openUC2/UC2-STEP/README.md

<p align="left">

</p>

# openUC2 *STEP Files*
---

This repository stores all the STEP Files for the openUC2 ecosystem. It is automatically exported using the Autodesk Inventor Task Scheduler.

## Get Involved

This project is open so that anyone can get involved. You don't even have to learn CAD designing or programming. Find ways you can contribute in  [CONTRIBUTING](https://github.com/openUC2/UC2-GIT/blob/master/CONTRIBUTING.md)

## License and Collaboration

This project is open-source and is released under the CERN open hardware license. Our aim is to make the kits commercially available.
We encourage everyone who is using our Toolbox to share their results and ideas, so that the Toolbox keeps improving. It should serve as a easy-to-use and easy-to-access general purpose building block solution for the area of STEAM education. All the design files are generally for free, but we would like to hear from you how is it going.

You're free to fork the project and enhance it. If you have any suggestions to improve it or add any additional functions make a pull-request or file an issue.

Please find the type of licenses [here](https://github.com/openUC2/UC2-GIT/blob/master/License.md)

REMARK: All files have been designed using Autodesk Inventor 2019 (EDUCATION)

## Collaborating
If you find this project useful, please like this repository, follow us on Twitter and cite the webpage! :-)
