openUC2/UC2-STEP/STEP/Assembly_Cube_Laser_Multicolour_insert_v3.ipt.step

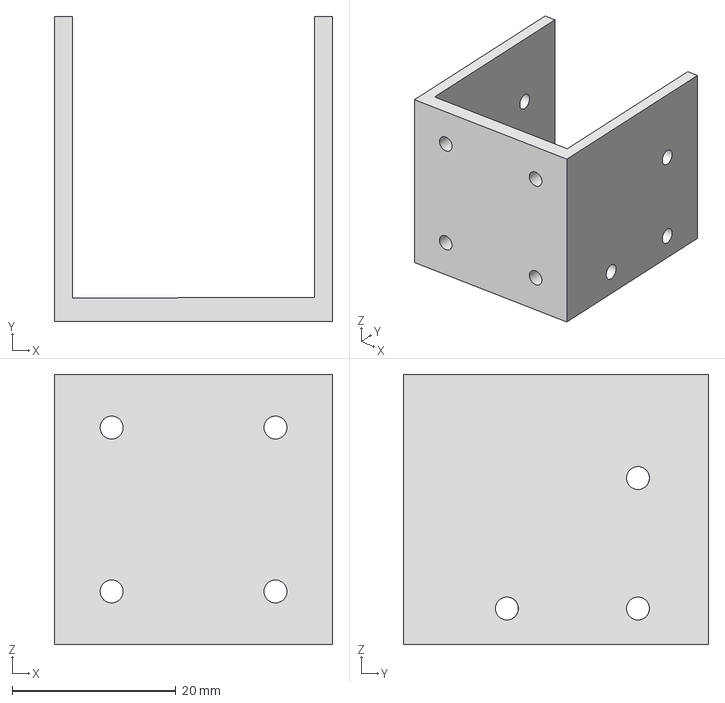
[picture p1: CAD file, 2022-11-30]
STEP/Assembly_Cube_Laser_Multicolour_insert_v3.ipt.step
33.9 x 37.3 x 33.0 mm
