openUC2/UC2-STEP/STEP/Assembly_Cube_Flexuremanipulator_v3.iam.step

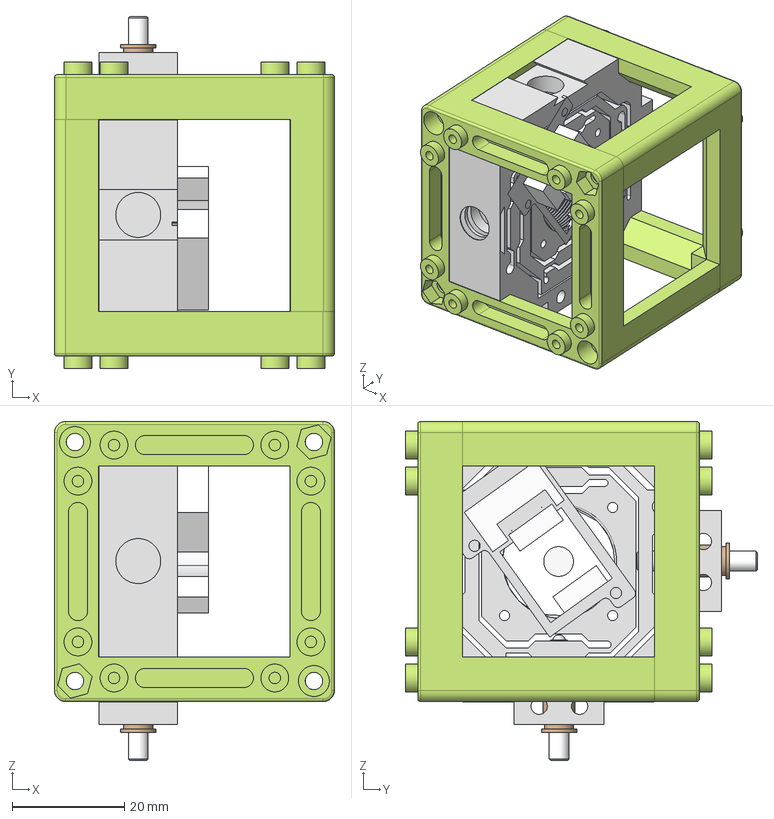
[picture p2: CAD file, 2022-11-30]
STEP/Assembly_Cube_Flexuremanipulator_v3.iam.step
49.8 x 62.6 x 60.3 mm
10_Cube_1x1_IM x 2
20_Cube_Inser_Flexuremanipulator_v3
00_F6SSN2P-Step x 2
00_F6SS088-Step x 2
20_Cube_Inser_Flexuremanipulator_springlock_v3
00_KES400_Bluray_Lens
00_KES_Bluray_Magnet
00_KES400_Lens
20_Cube_Insert_Flexuremanipulator_kes400_adapterplate_v3
