openUC2/UC2-STEP/STEP/Assembly_Cube_noBP.iam.step

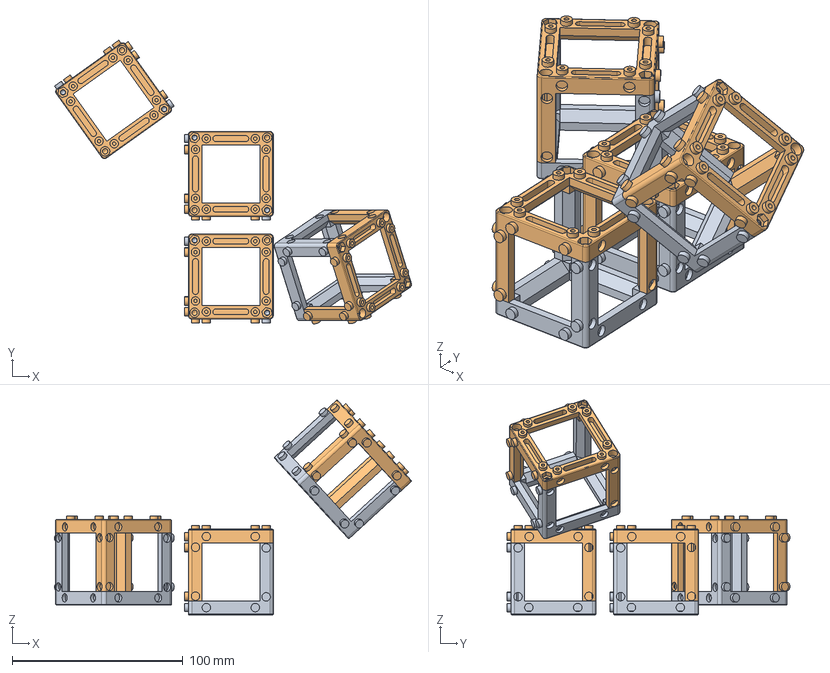
[picture p3: CAD file, 2022-11-30]
STEP/Assembly_Cube_noBP.iam.step
208.8 x 165.9 x 125.6 mm
10_Cube_1x1_IM x 4
10_Cube_1x1_IM_1 x 4
