openUC2/UC2-STEP/STEP/Assembly_Cube_Beamsplitter_new_v3.iam.step

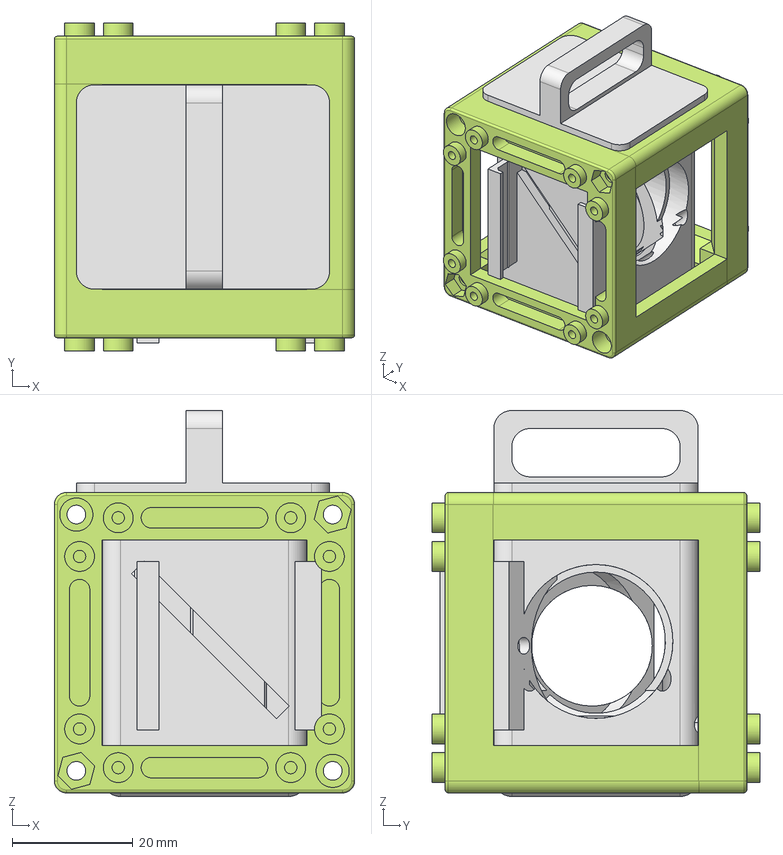
[picture p4: CAD file, 2022-11-30]
STEP/Assembly_Cube_Beamsplitter_new_v3.iam.step
49.8 x 54.4 x 64.0 mm
10_Cube_1x1_IM x 2
30_Cube_Insert_Filter_Revolver_Filter_base_single
30_Cube_Insert_Filter_Revolver_Filter_base_single_v3
