openUC2/UC2-STEP/STEP/Assembly_Cube_Flashlight_v3.iam.step

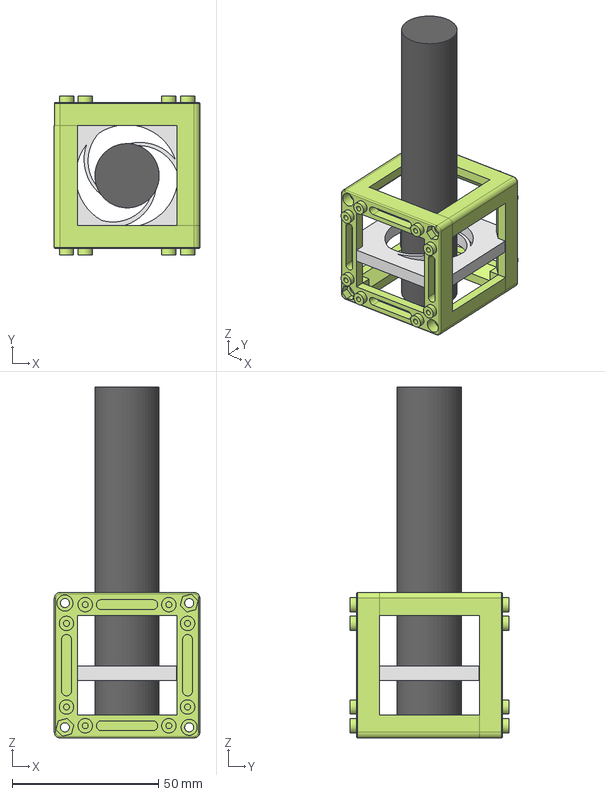
[picture p5: CAD file, 2022-11-30]
STEP/Assembly_Cube_Flashlight_v3.iam.step
49.9 x 54.5 x 120.0 mm
20_Cube_Insert_Holder-okular+flashlight_v3
10_Cube_1x1_IM x 2
00_flashlight
