openUC2/UC2-STEP/STEP/Assembly_Cube_Laser_Multicolour_v3.iam.step

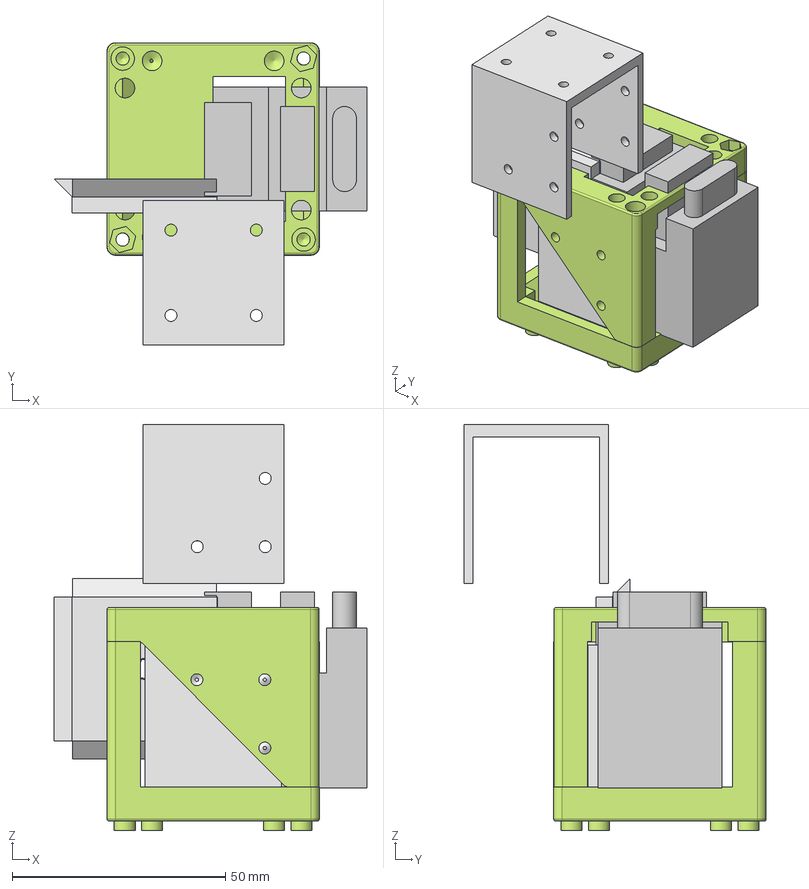
[picture p6: CAD file, 2022-11-30]
STEP/Assembly_Cube_Laser_Multicolour_v3.iam.step
73.3 x 70.9 x 95.1 mm
00_RGB_Laser_Laserlands
10_Cube_1x1_IM
10_Cube_1x1_IM_1
Assembly_Cube_Laser_Multicolour_insert_v3
20_Cube_Insert_Laser_multicolour_sidewall_v3
20_Cube_Insert_Template_inplate_V3
