openUC2/UC2-STEP/STEP/Assembly_Cube_Lasertack_v3.iam.step

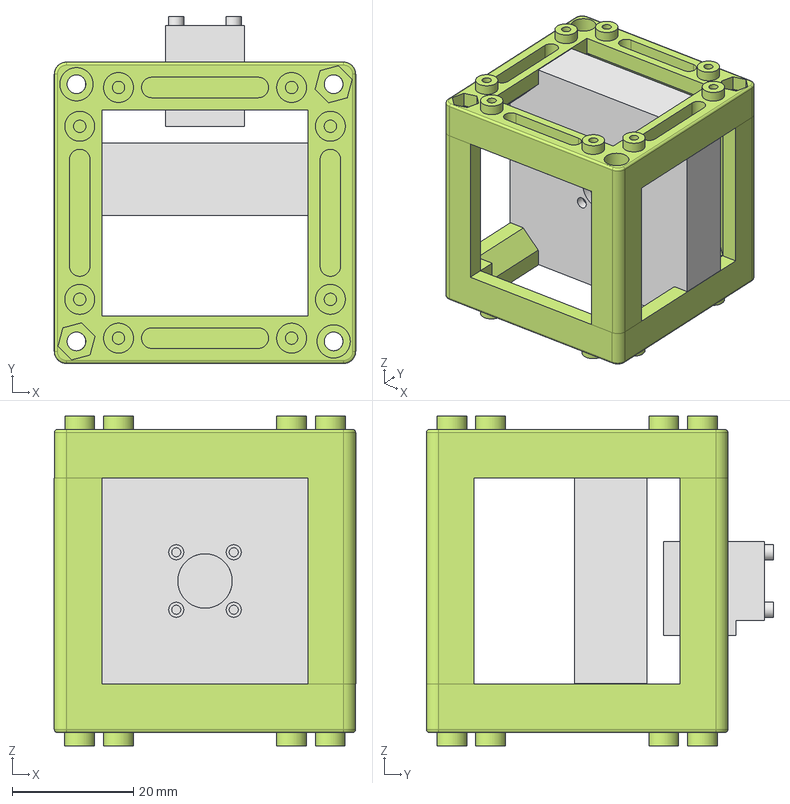
[picture p7: CAD file, 2022-11-30]
STEP/Assembly_Cube_Lasertack_v3.iam.step
49.8 x 57.3 x 54.5 mm
10_Cube_1x1_IM x 2
20_Cube_Insert_Lasertack_mount_v3
00_Lasertack_Coolingblock
