openUC2/UC2-STEP/STEP/Assembly_Cube_Baseplate_wMagnets_v3.iam.step

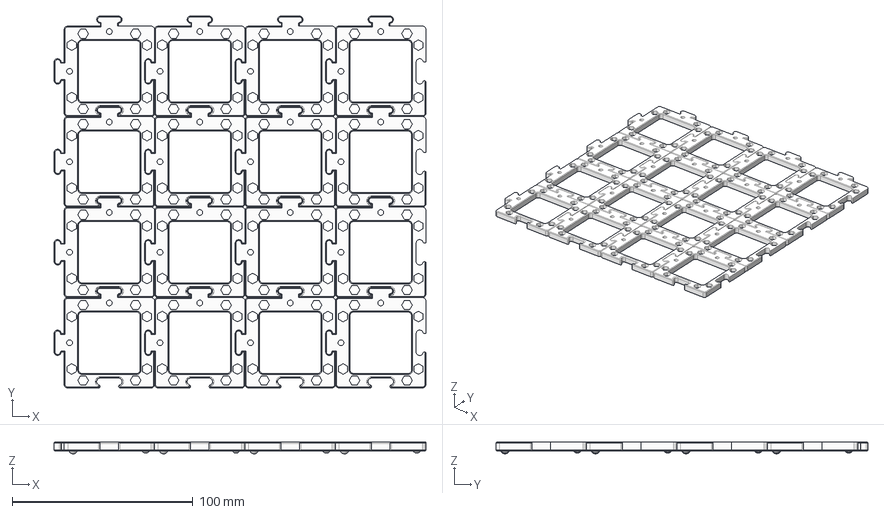
[picture p9: CAD file, 2022-11-30]
STEP/Assembly_Cube_Baseplate_wMagnets_v3.iam.step
205.6 x 205.6 x 6.55 mm
10_Base_puzzle_v3 x 16
00_BallMagnets_5mm x 16
