openUC2/UC2-STEP/STEP/Assembly_Cube_empty_IM_withBase_v3.iam.step

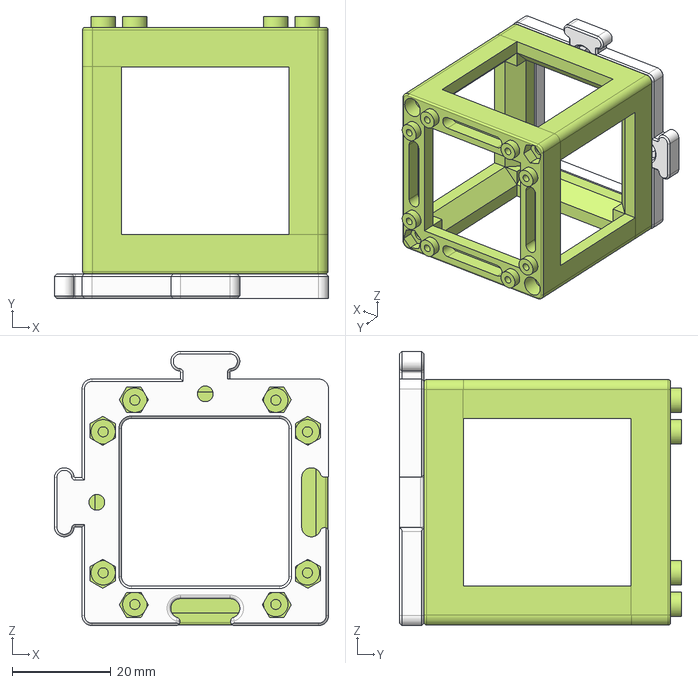
[picture p10: CAD file, 2022-11-30]
STEP/Assembly_Cube_empty_IM_withBase_v3.iam.step
55.6 x 57.2 x 55.6 mm
10_Cube_1x1_IM x 2
10_Base_puzzle_v3
