openUC2/UC2-STEP/STEP/Assembly_Cube_RMS_objective.iam.step

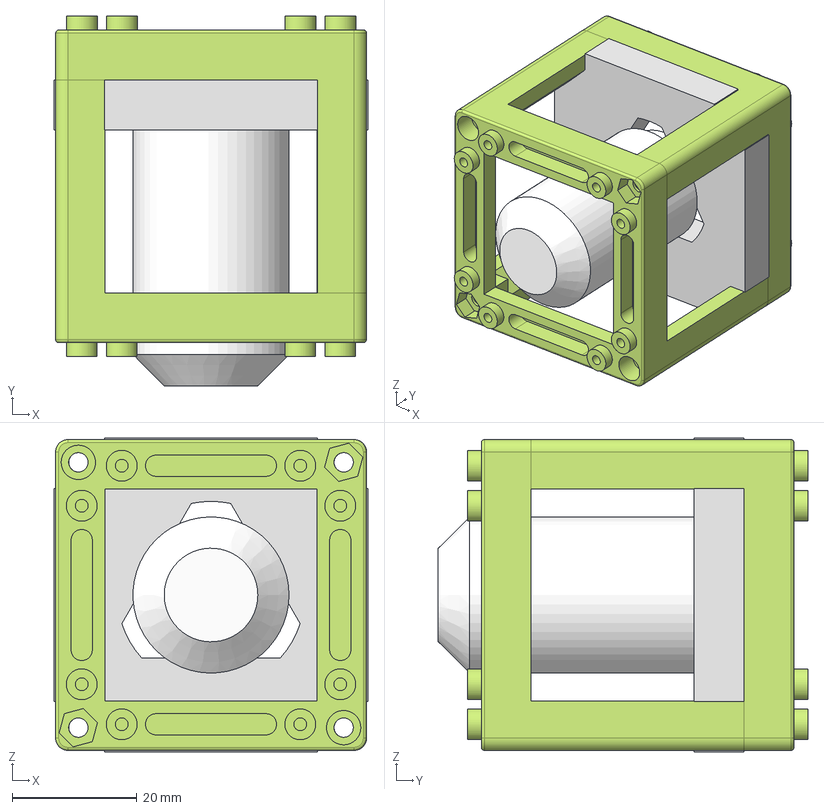
[picture p11: CAD file, 2022-11-30]
STEP/Assembly_Cube_RMS_objective.iam.step
50.3 x 59.2 x 50.3 mm
10_Cube_1x1_IM x 2
20_IM_Cube_Insert_Lens_holder_RMS_63x
00_Microscope_Objective_Lens10x
