openUC2/UC2-STEP/STEP/Assembly_Cube_Beamexpander_seperated_v3.iam.step

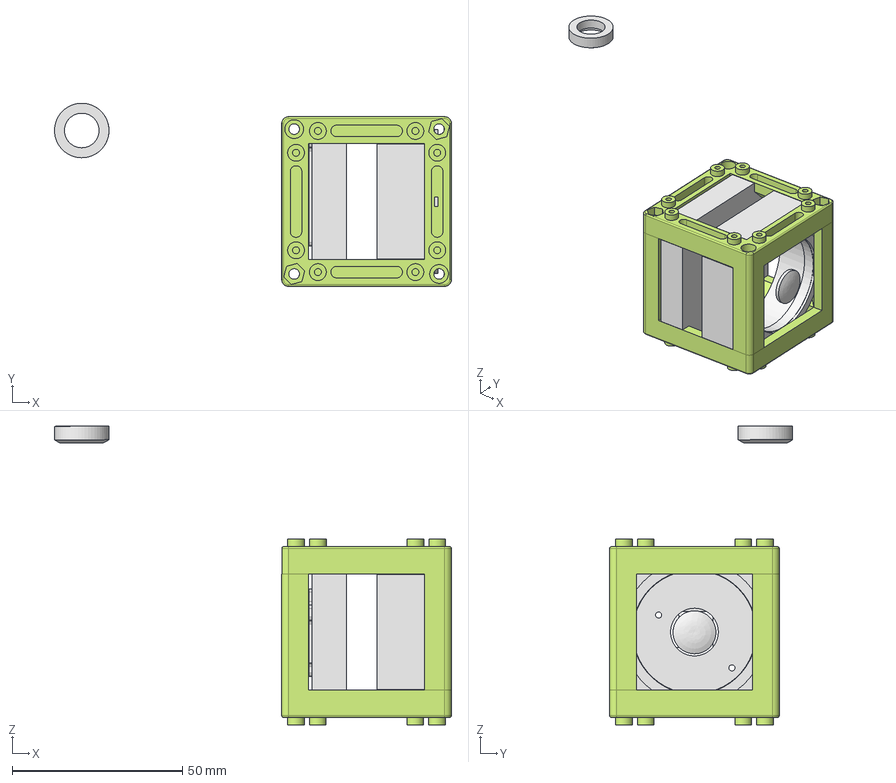
[picture p13: CAD file, 2022-11-30]
STEP/Assembly_Cube_Beamexpander_seperated_v3.iam.step
116.5 x 53.8 x 87.7 mm
10_Cube_1x1_IM x 2
00_Lens_f_29_d12.6
20_Beamexpander_Lens_Adapter
20_Cube_Insert_Fiber_STMount_Center
00_KES400_Bluray_Lens
00_KES_Bluray_Magnet
00_KES400_Lens
20_Lens_holder_DIA_50mm
20_Lens_holder_156mm_clamp
