openUC2/UC2-STEP/STEP/Assembly_Cube_lineartranslator_v3.iam.step

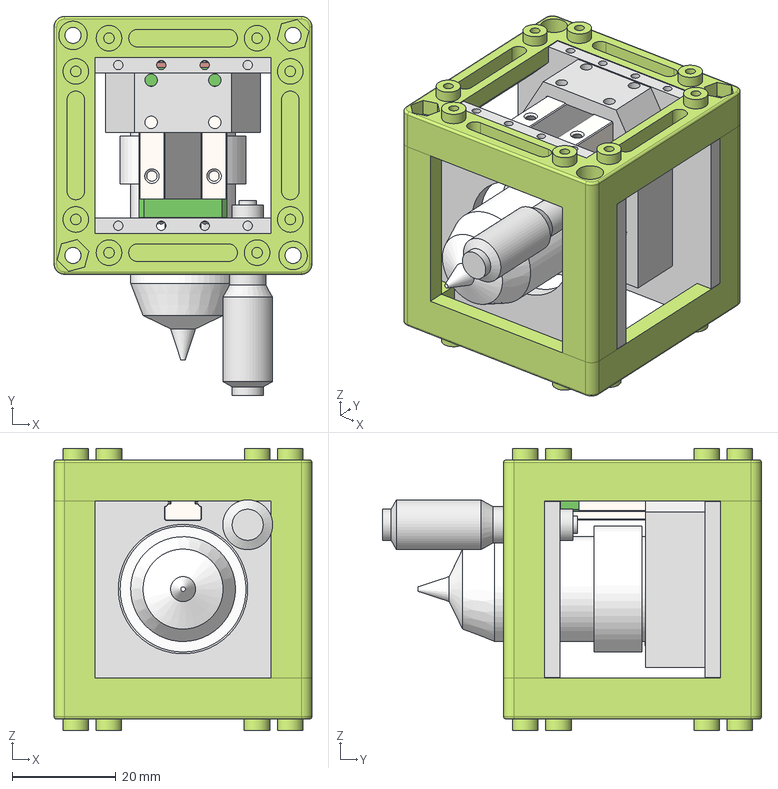
[picture p14: CAD file, 2022-11-30]
STEP/Assembly_Cube_lineartranslator_v3.iam.step
49.8 x 73.2 x 54.5 mm
10_Cube_1x1_IM x 2
20_Cube_Insert_lineartranlator_mgn7_base_v3 x 2
00_MGN7_34mm
MGN7-H
30_Cube_lineartranslator_adapter_RMS_v3
00_RS_Pro_Micrometer_small
00_objectivelens_10x
