openUC2/UC2-STEP/STEP/Assembly_base_4x1.iam.step

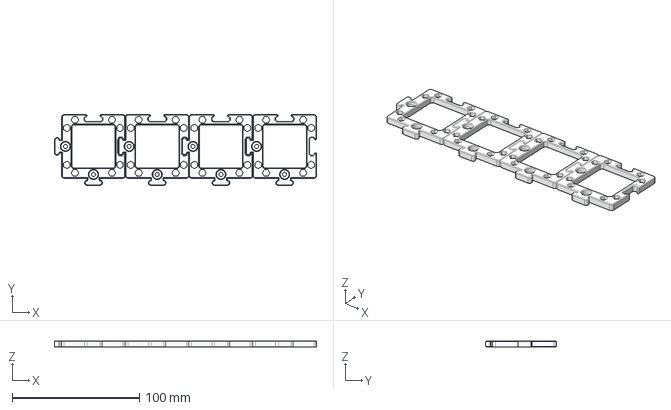
[picture p15: CAD file, 2022-11-30]
STEP/Assembly_base_4x1.iam.step
205.6 x 55.6 x 5.00 mm
10_Base_puzzle_v3 x 4
