openUC2/UC2-STEP/STEP/Assembly_Motorcoupling_Nema_M3_Selfcentering.iam.step

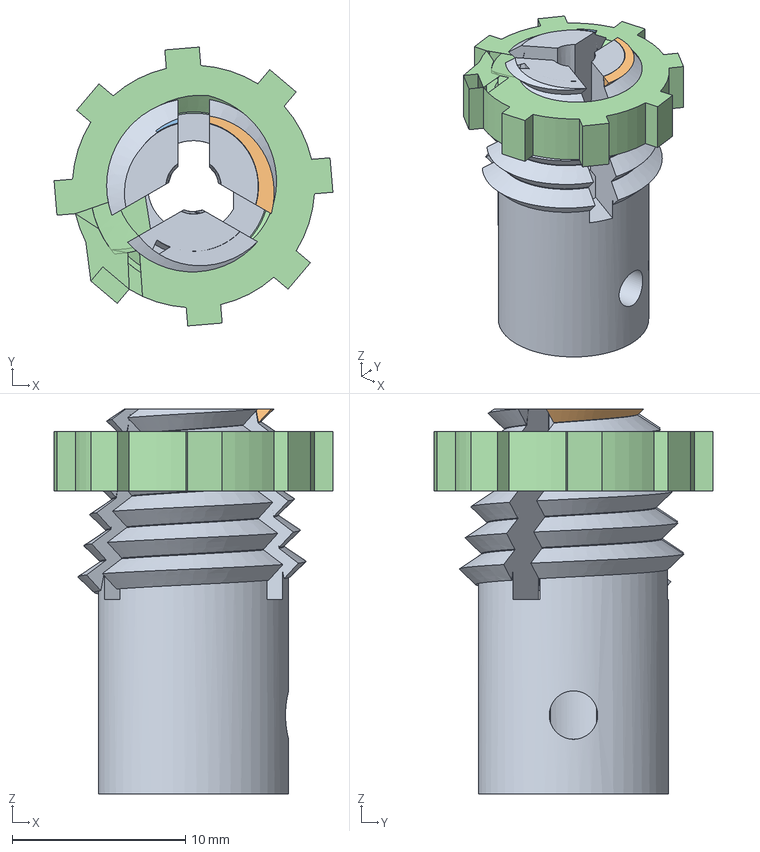
[picture p16: CAD file, 2022-11-30]
STEP/Assembly_Motorcoupling_Nema_M3_Selfcentering.iam.step
16.1 x 16.1 x 22.3 mm
00_coupler_5_3_nema_screw
00_coupler_5_3_nema_screw_nut
