openUC2/UC2-STEP/STEP/Assembly_Cube_Lightsheet_FEPTube_Flowcube_v3.iam.step

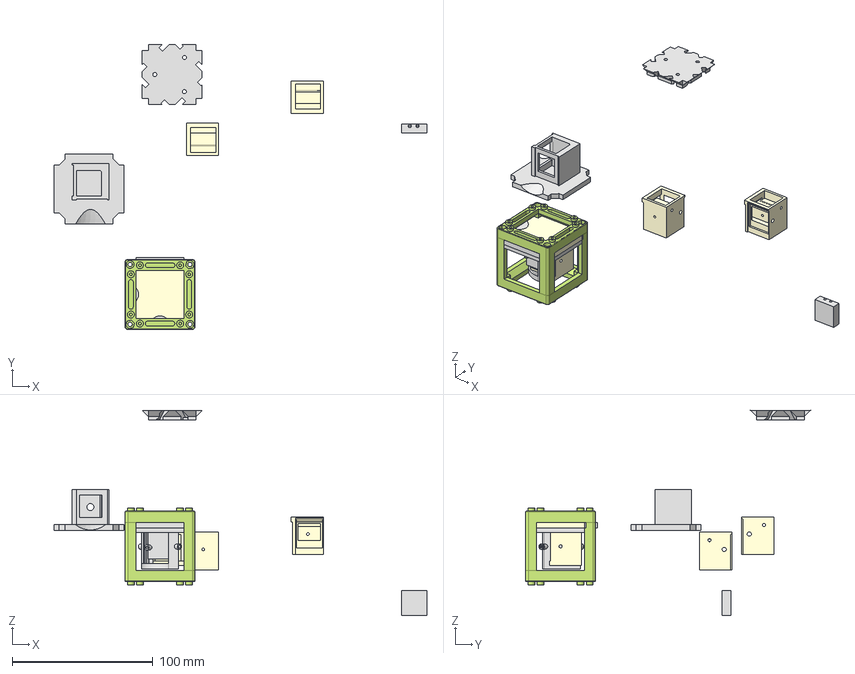
[picture p17: CAD file, 2022-11-30]
STEP/Assembly_Cube_Lightsheet_FEPTube_Flowcube_v3.iam.step
264.8 x 202.4 x 145.8 mm
10_Cube_1x1_IM x 2
20_Cube_Insert_Lightsheet_FEPTube_Flowcube_v3 x 2
00_FEP_Tube_3mm_x_20mm
20_Cube_Insert_Lightsheet_FEPTube_Pipette_v3
20_Cube_Insert_Lightsheet_FEPTube_Flowcube_v3_1
20_Cube_Insert_Lightsheet_FEPTube_shifted_v3
20_Cube_Insert_Lightsheet_FEPTube_shifted_blockonly_v3
20_Cube_Insert_Lightsheet_FEPTube_shifted_blockonly_v3_MIR
30_Cube_Insert_Filter_Revolver_Base_v3
20_Cube_Insert_Lightsheet_FEPTube_shifted_blockonly_squarecapillary_v 3
