openUC2/UC2-STEP/STEP/Assembly_Perestaltic_Pump_NEMA17.iam.step

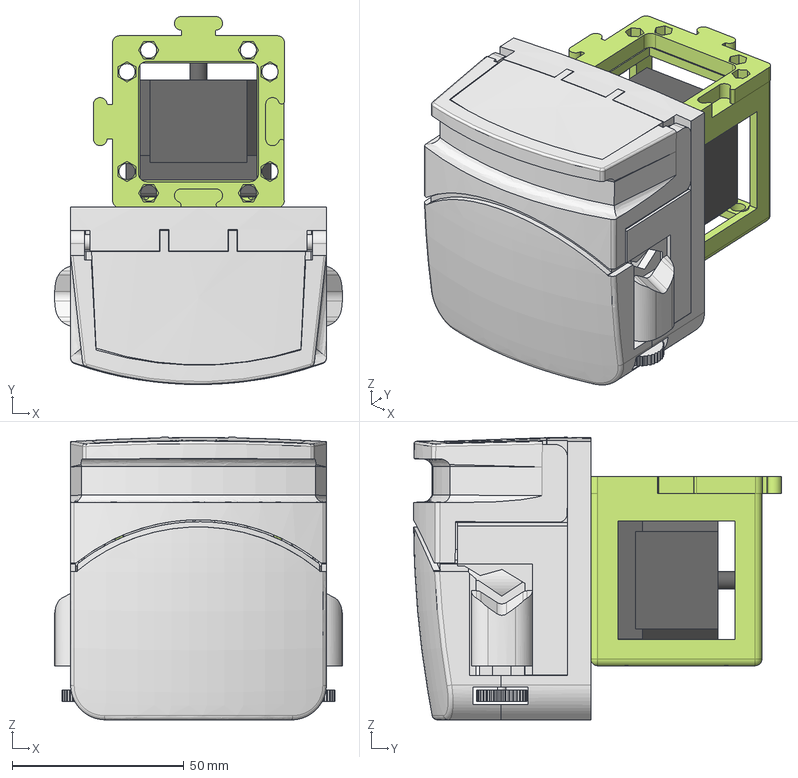
[picture p19: CAD file, 2022-11-30]
STEP/Assembly_Perestaltic_Pump_NEMA17.iam.step
83.8 x 107.1 x 82.3 mm
40_Perestaltic_Pump_NEMA17_Body
00_NEMA_17
Pump Slide Gray
Pump Base1 Gray
MS-0227 r2 Pump Head Shaft Modified
Pump Front Cover gray
Pump Clamp gray x 2
Pump Top Latch gray
