openUC2/UC2-STEP/STEP/Assembly_Cube_CanonEOS_Adapter_v3.iam.step

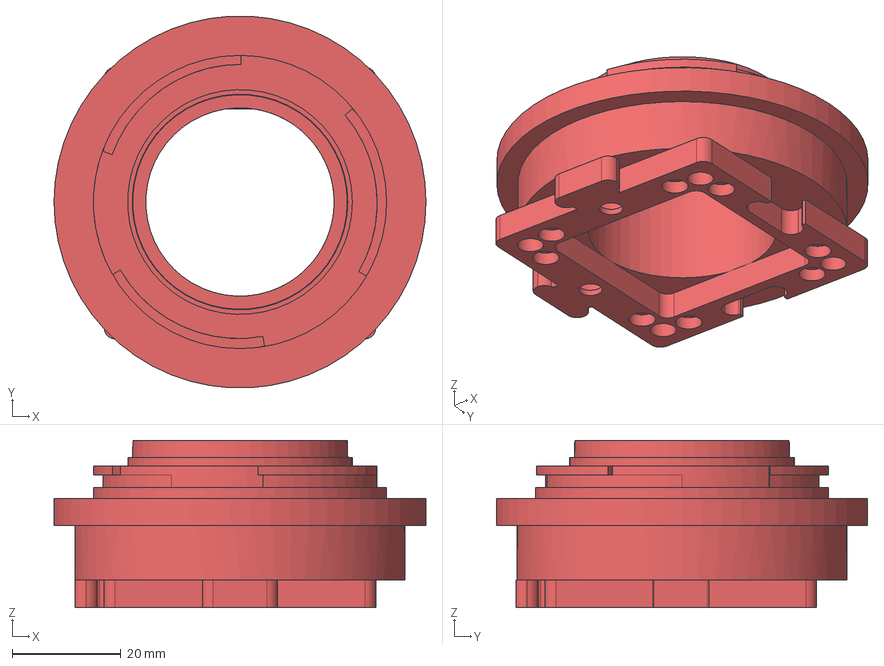
[picture p20: CAD file, 2022-11-30]
STEP/Assembly_Cube_CanonEOS_Adapter_v3.iam.step
68.5 x 68.4 x 30.8 mm
10_Base_v2
