openUC2/UC2-STEP/STEP/Assembly_Rect_Aperture_Insert_half.iam.step

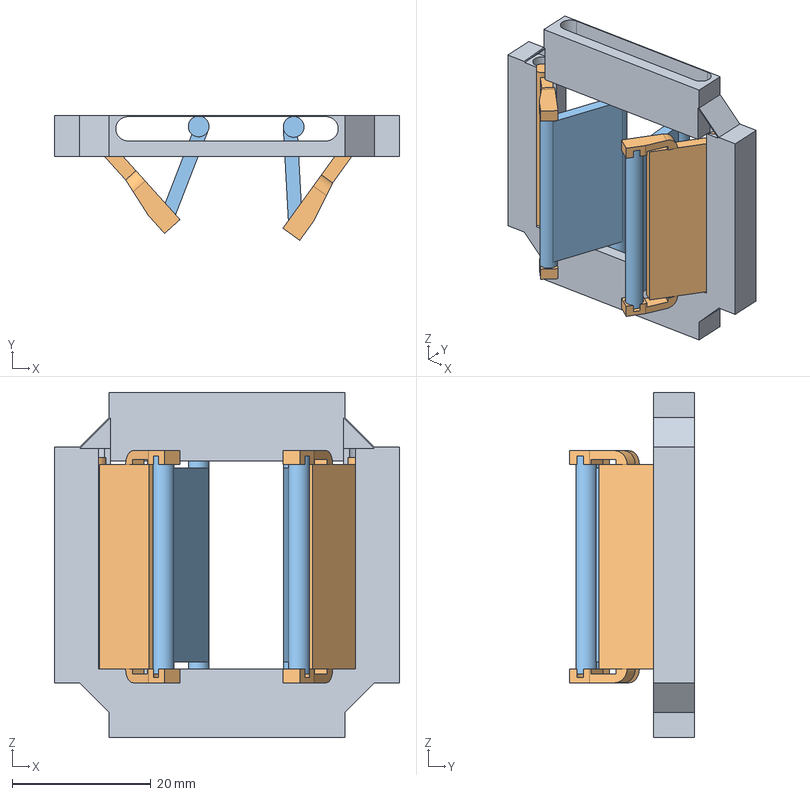
[picture p21: CAD file, 2022-11-30]
STEP/Assembly_Rect_Aperture_Insert_half.iam.step
49.8 x 18.0 x 49.8 mm
20_Rect_Aperture_Insert_half_v3
20_Rect_Aperture_door_hinge x 2
20_Rect_Aperture_door_slide x 2
