openUC2/UC2-STEP/STEP/Assembly_Cube_Sample_holder_v3_or2.iam.step

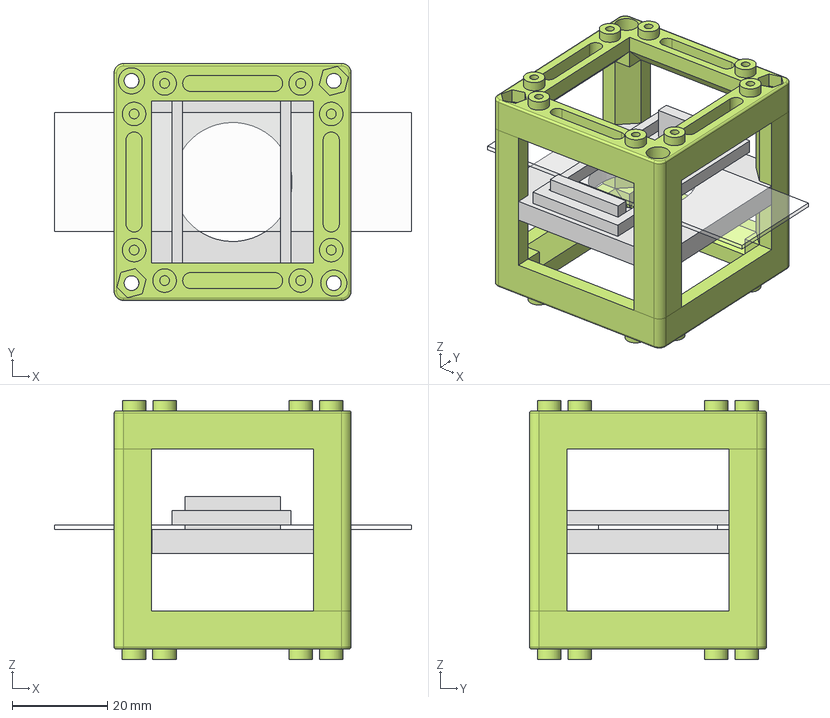
[picture p22: CAD file, 2022-11-30]
STEP/Assembly_Cube_Sample_holder_v3_or2.iam.step
75.0 x 49.8 x 54.5 mm
10_Cube_1x1_IM x 2
20_Cube_Insert_Sample_clamp
20_Cube_insert_Sample_holder_v3
00_Microscope_Slide
