openUC2/UC2-STEP/STEP/Assembly_Cube_Arducam_USB_v3.iam.step

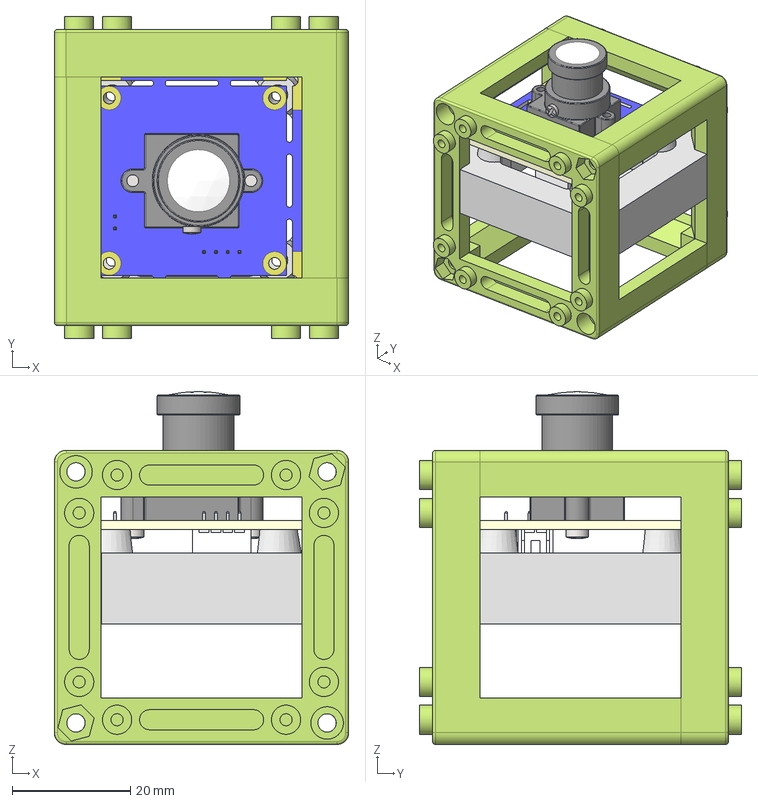
[picture p23: CAD file, 2022-11-30]
STEP/Assembly_Cube_Arducam_USB_v3.iam.step
49.8 x 54.5 x 59.7 mm
00_Arducam_USB
20_Cube_Insert_Arducam_USB_insert_v3
10_Cube_1x1_IM x 2
