openUC2/UC2-STEP/STEP/Assembly_Cube_Laser_v3.iam.step

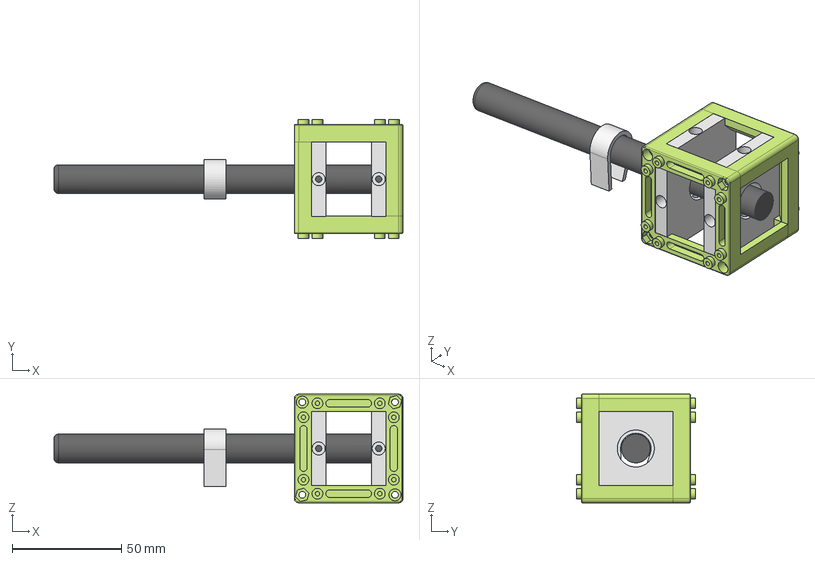
[picture p24: CAD file, 2022-11-30]
STEP/Assembly_Cube_Laser_v3.iam.step
160.0 x 54.5 x 49.8 mm
10_Cube_1x1_IM x 2
00_Laserpointer_450nm_blue
00_Laser_Clamp_OnOffSwitch
20_Cube_Insert_Laser_Holder_fixed_v3 x 2
