openUC2/UC2-STEP/STEP/Assembly_microfluidic_lightsheet_v0.iam.step

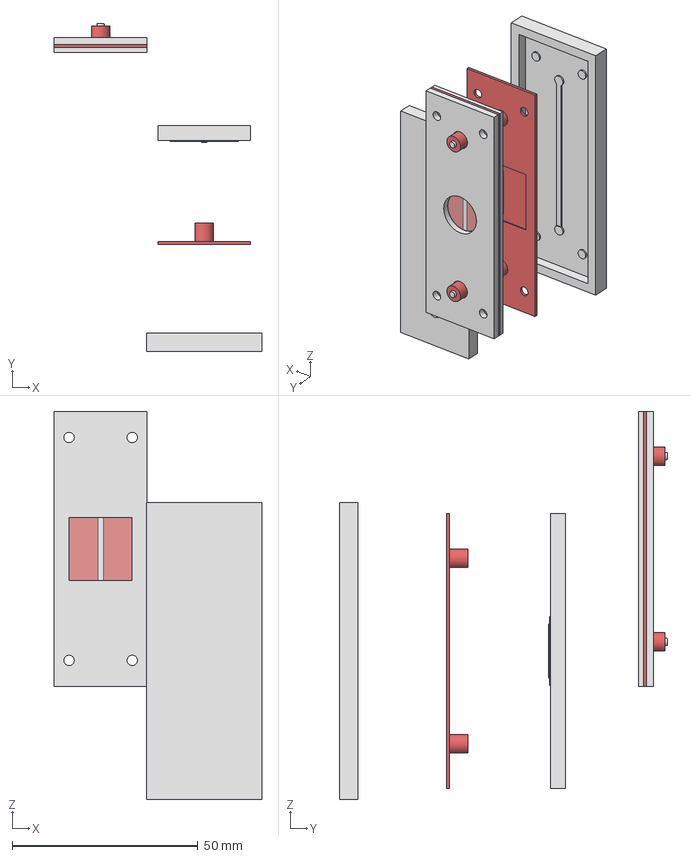
[picture p26: CAD file, 2022-11-30]
STEP/Assembly_microfluidic_lightsheet_v0.iam.step
55.9 x 88.3 x 104.5 mm
40_microfluidic_chip_lightsheet_base_v0
40_microfluidic_chip_lightsheet_layer1_v0
00_coverglass_18mm x 2
40_microfluidic_chip_lightsheet_layer1_negative_v0 x 2
40_microfluidic_chip_lightsheet_layer2_v0
40_microfluidic_chip_lightsheet_layer1_negative_mould_upper_v0
40_microfluidic_chip_lightsheet_layer1_negative_mould_lower_v0
