openUC2/UC2-STEP/STEP/Assembly_Cube_28byi_Motor_v3.iam.step

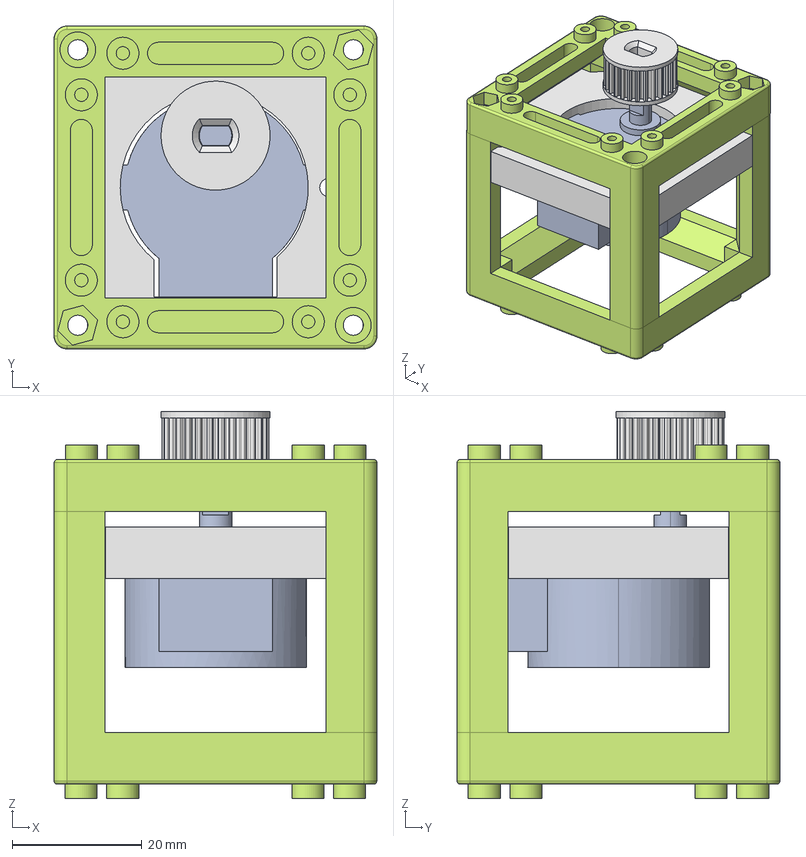
[picture p27: CAD file, 2022-11-30]
STEP/Assembly_Cube_28byi_Motor_v3.iam.step
49.8 x 49.8 x 59.7 mm
10_Cube_1x1_IM x 2
00_Stepper_Motor_28BYJ-48
20_Cube_Insert_RaspiCam_v3
00_Pulley_28byj-48
