openUC2/UC2-STEP/STEP/Assembly_Cube_NEOMATRIX_4x4_v3.iam.step

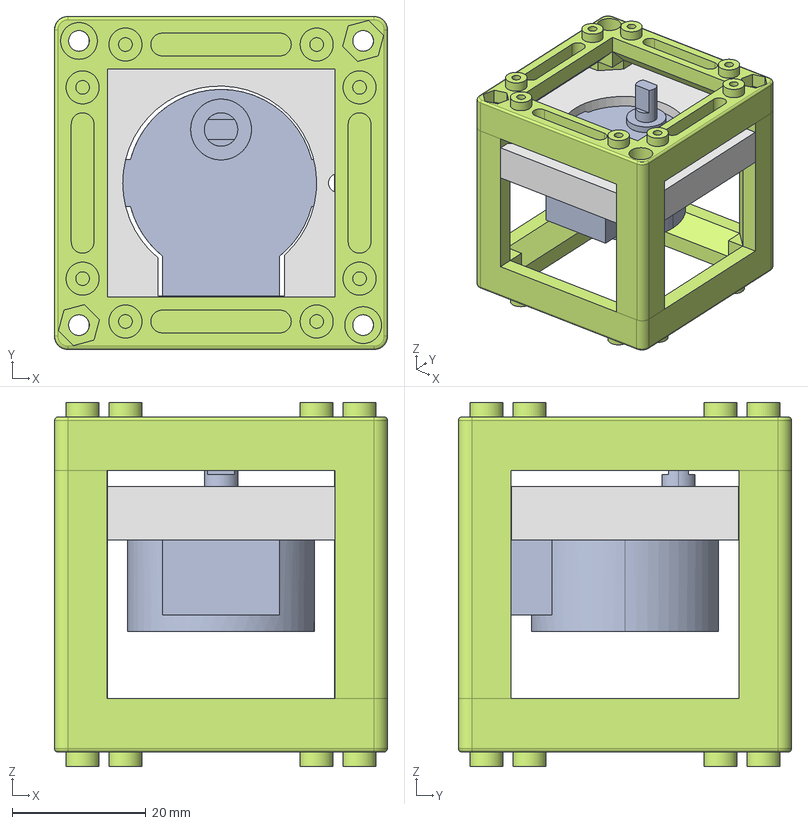
[picture p28: CAD file, 2022-11-30]
STEP/Assembly_Cube_NEOMATRIX_4x4_v3.iam.step
49.8 x 49.8 x 54.5 mm
10_Cube_1x1_IM x 2
00_Stepper_Motor_28BYJ-48
20_Cube_Insert_RaspiCam_v3
