openUC2/UC2-STEP/STEP/Assembly_Cube_Daheng_Imaging_Camera_v3.iam.step

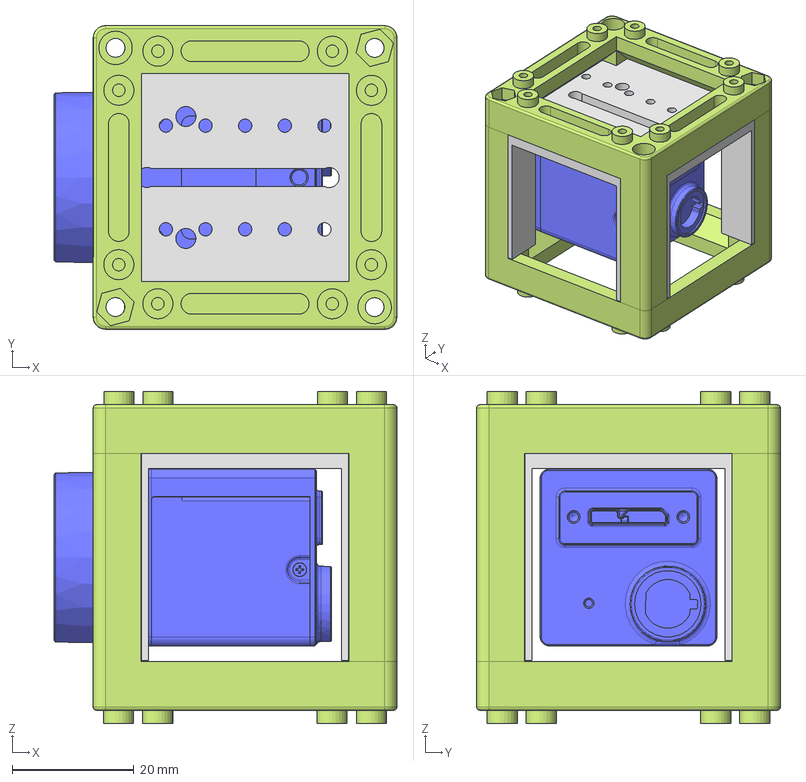
[picture p29: CAD file, 2022-11-30]
STEP/Assembly_Cube_Daheng_Imaging_Camera_v3.iam.step
56.2 x 49.8 x 54.5 mm
10_Cube_1x1_IM x 2
00_Daheng_IMX174_mer2_u3_user_a1.0.1
20_Cube_insert_AlliedVision_Alvium_v3
