openUC2/UC2-STEP/STEP/Assembly_Cube_Eyepiece_v3.iam.step

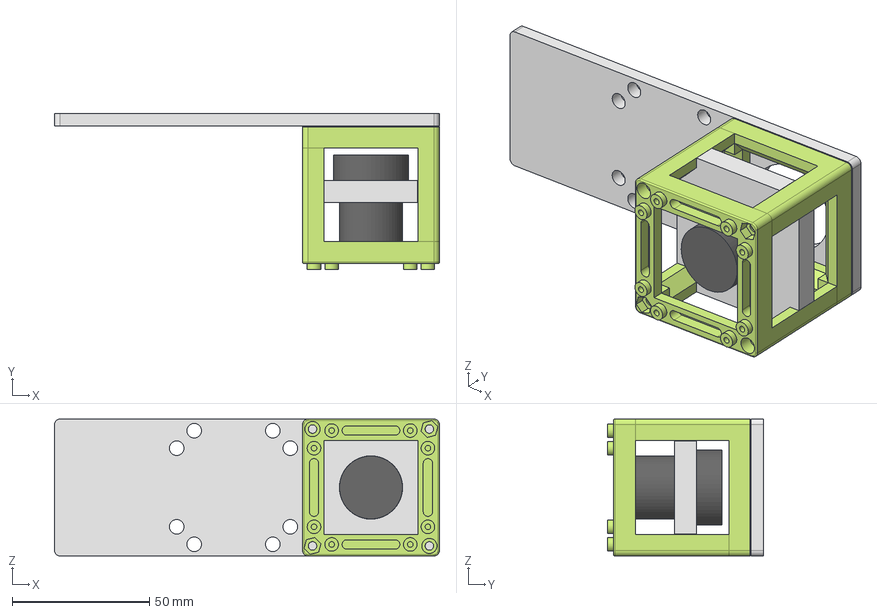
[picture p30: CAD file, 2022-11-30]
STEP/Assembly_Cube_Eyepiece_v3.iam.step
140.0 x 56.8 x 49.8 mm
10_Cube_1x1_IM x 2
00_Eyepiece_WF20x 23,2mm
30_Smartphone_Holder_v3
20_Cube_Insert_Eyepiece
