openUC2/UC2-STEP/STEP/Assembly_Cube_2D_Galvo_Fiberlauncher_v3.iam.step

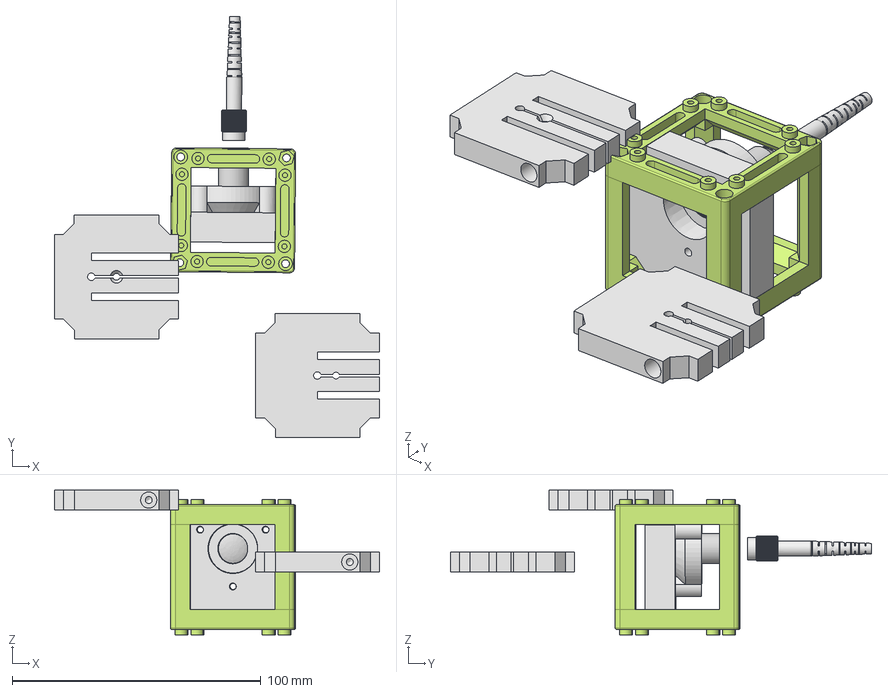
[picture p31: CAD file, 2022-11-30]
STEP/Assembly_Cube_2D_Galvo_Fiberlauncher_v3.iam.step
130.6 x 169.2 x 58.2 mm
10_Cube_1x1_IM x 2
00_SM1FC-Step
20_Cube_Insert_2D_Galvo_Fiberlaunch_v3
20_Cube_Insert_2D_Galvo_Fiberlaunch_SM1FC_part1_v3
P1-305A-FC-1-Step
00_Fiber_M12_collimator_v3
20_Cube_Insert_2D_Galvo_Fiberlaunch_center_v3
