openUC2/UC2-STEP/STEP/Assembly_Cube_Lens_holder_165mm_v3.iam.step

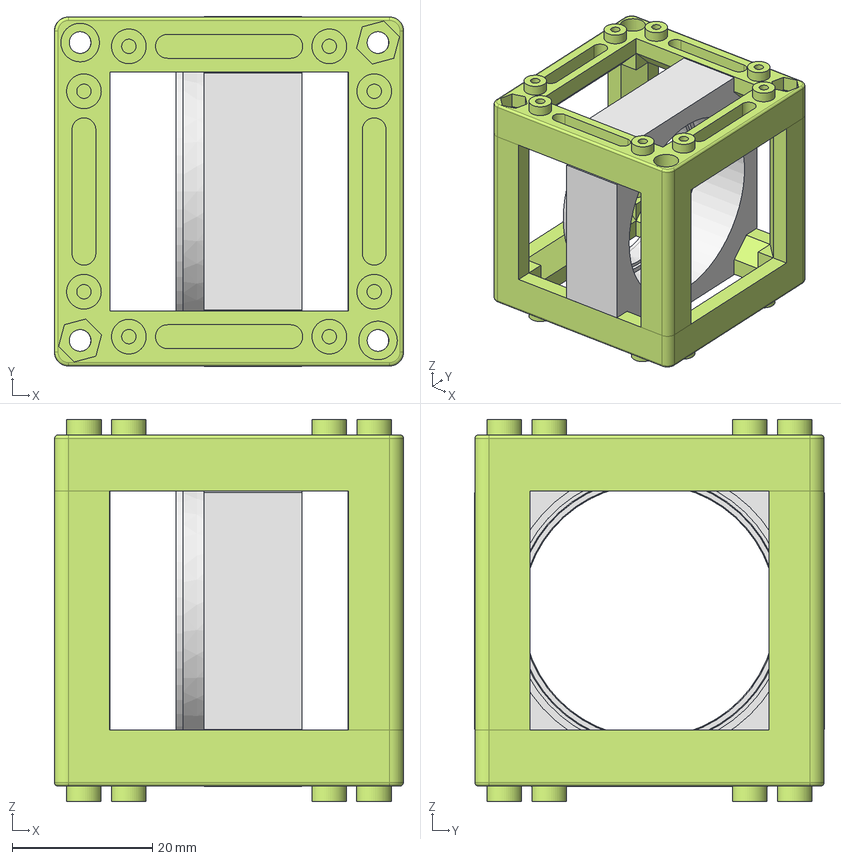
[picture p32: CAD file, 2022-11-30]
STEP/Assembly_Cube_Lens_holder_165mm_v3.iam.step
49.8 x 50.0 x 54.5 mm
10_Cube_1x1_IM x 2
20_Lens_holder_DIA_50mm
20_Lens_holder_156mm_clamp
