openUC2/UC2-STEP/STEP/Assembly_Cube_BaslerCam_acA1920_25gm_v3.iam.step

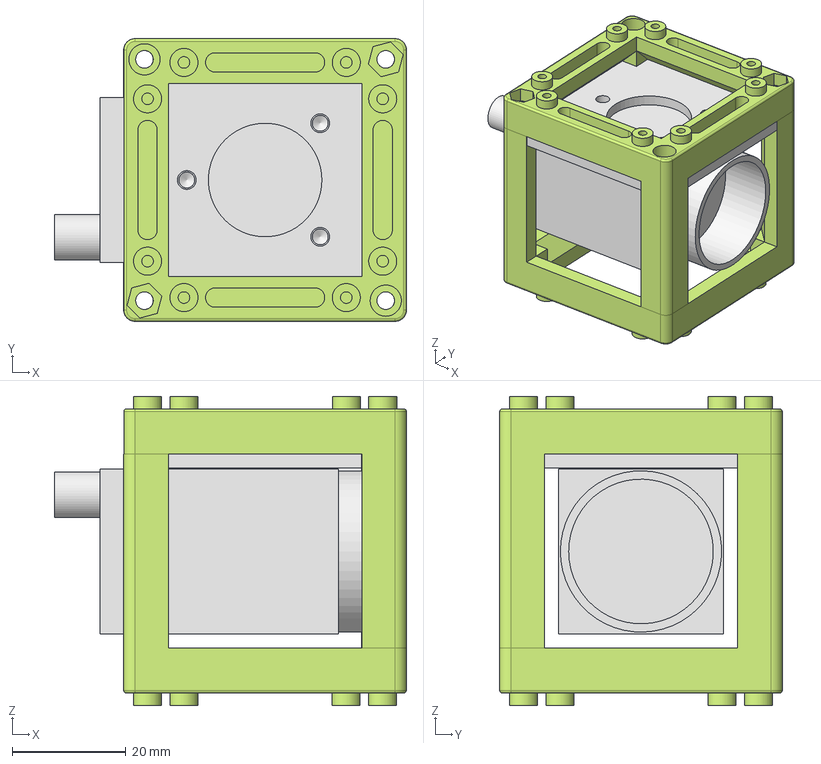
[picture p33: CAD file, 2022-11-30]
STEP/Assembly_Cube_BaslerCam_acA1920_25gm_v3.iam.step
62.0 x 49.8 x 54.5 mm
10_Cube_1x1_IM x 2
00_Basler_acA1920_25gm
20_Cube_insert_Basler_acA1920_25gm_v3
