openUC2/UC2-STEP/STEP/Assembly_Cube_RaspiCam_v3.iam.step

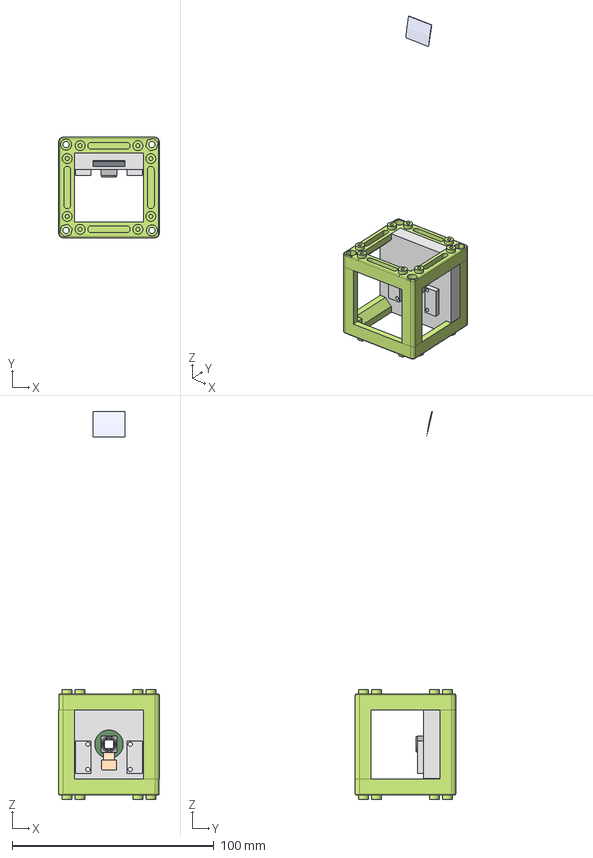
[picture p34: CAD file, 2022-11-30]
STEP/Assembly_Cube_RaspiCam_v3.iam.step
49.8 x 49.8 x 192.2 mm
10_Cube_1x1_IM x 2
RasPi_Camera
20_Cube_Insert_RaspiCam_v3
