openUC2/UC2-STEP/STEP/Assembly_Cube_Insert_Template_straightened_v3.iam.step

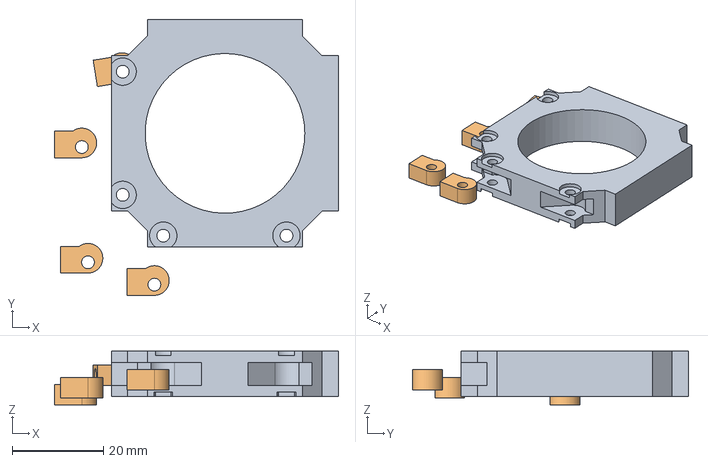
[picture p35: CAD file, 2022-11-30]
STEP/Assembly_Cube_Insert_Template_straightened_v3.iam.step
62.2 x 60.4 x 11.8 mm
20_Cube_Insert_Filter_25mm
20_Cube_Insert_Template_straightened_levelarm_v3 x 4
