openUC2/UC2-STEP/STEP/Assembly_RMS_Aligningtool_opticalaxis.iam.step

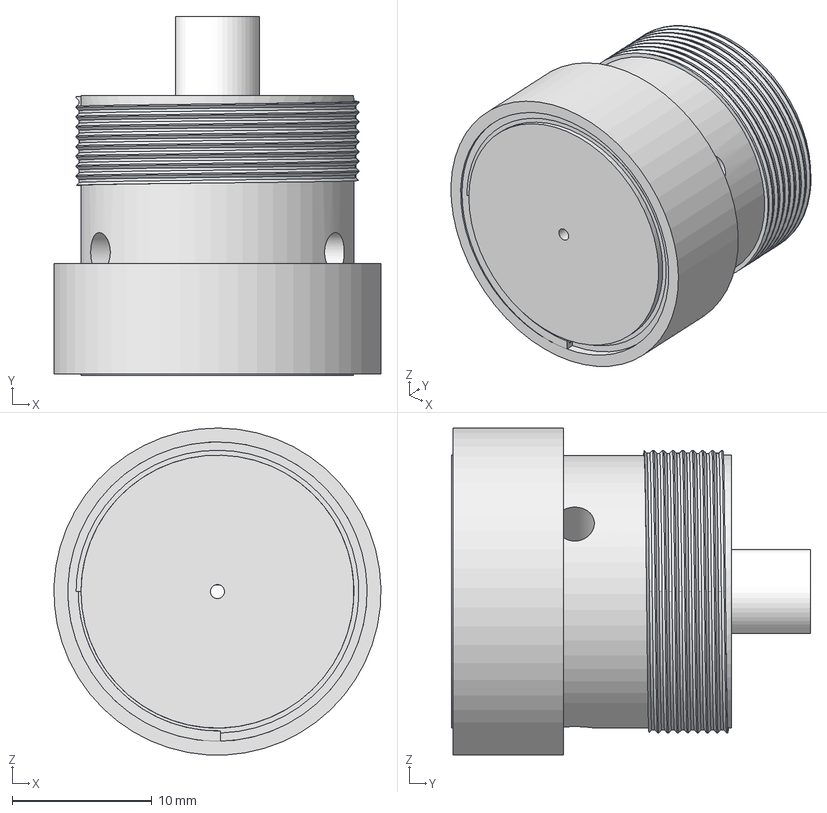
[picture p37: CAD file, 2022-11-30]
STEP/Assembly_RMS_Aligningtool_opticalaxis.iam.step
23.4 x 25.7 x 23.4 mm
00_RMS_Laser_alignmenttool
00_IR_Laserdiode
00_RMS_Thread
