openUC2/UC2-STEP/STEP/50_Assembly_ETL_Mould.iam.step

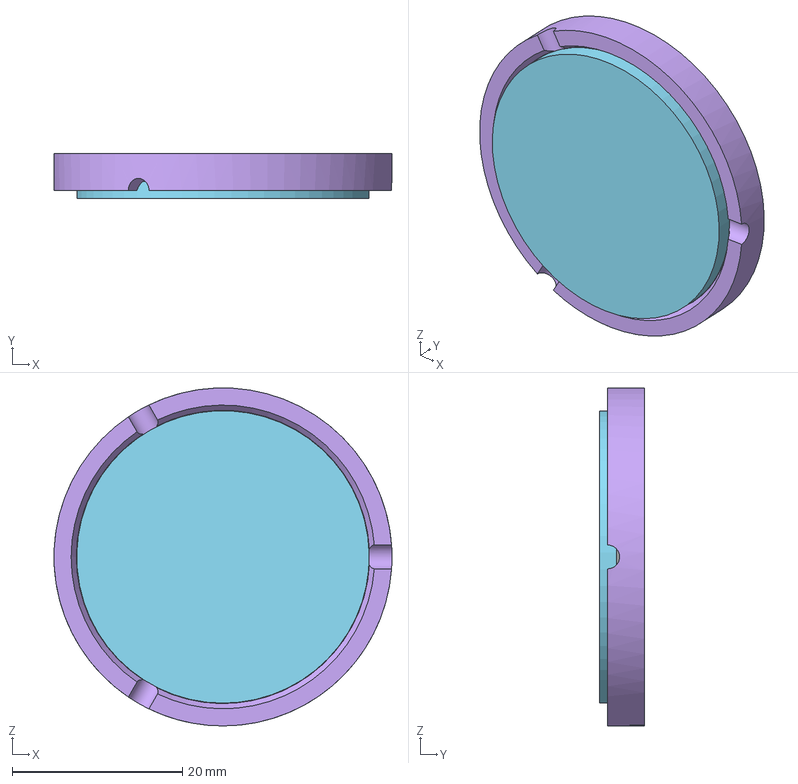
[picture p38: CAD file, 2022-11-30]
STEP/50_Assembly_ETL_Mould.iam.step
39.7 x 5.30 x 39.6 mm
50_ETL_Membrane_Mould_Lower_v0
50_ETL_Membrane_Mould_Upper_v0
00_coverglass_10mm x 2
50_ETL_Membrane_v0
