openUC2/UC2-STEP/STEP/Assembly_Cube_focusing_v3.iam.step

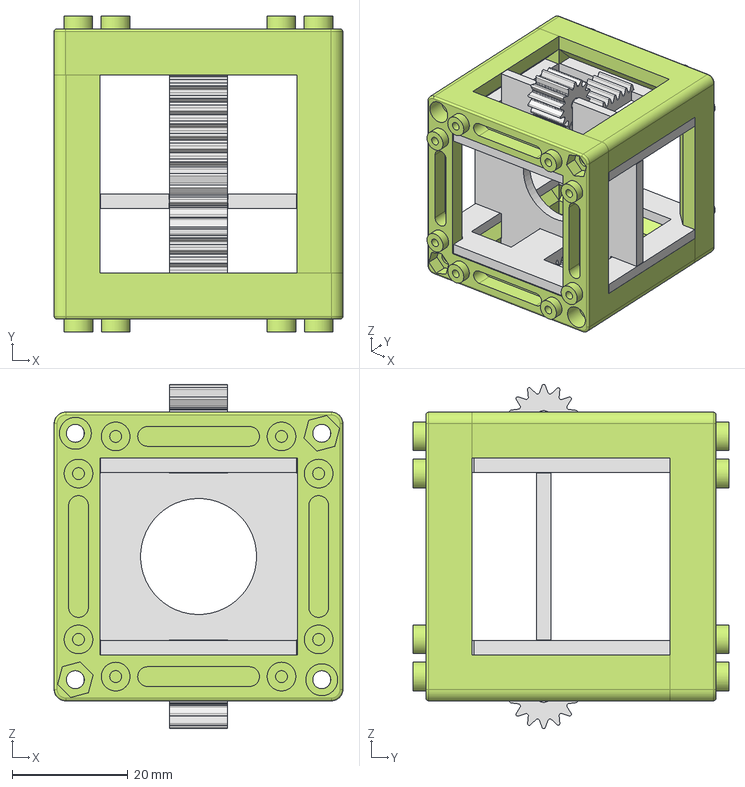
[picture p39: CAD file, 2022-11-30]
STEP/Assembly_Cube_focusing_v3.iam.step
49.8 x 54.5 x 59.4 mm
10_Cube_1x1_IM x 2
20_Cube_Insert_focusing_rail_v3 x 2
20_Cube_Insert_focusing_holder_v3
30_Cube_Z_Focus_MGN12_manual_gear_v3 x 2
