openUC2/UC2-STEP/STEP/20_Rect_Aperture_test_full.iam.step

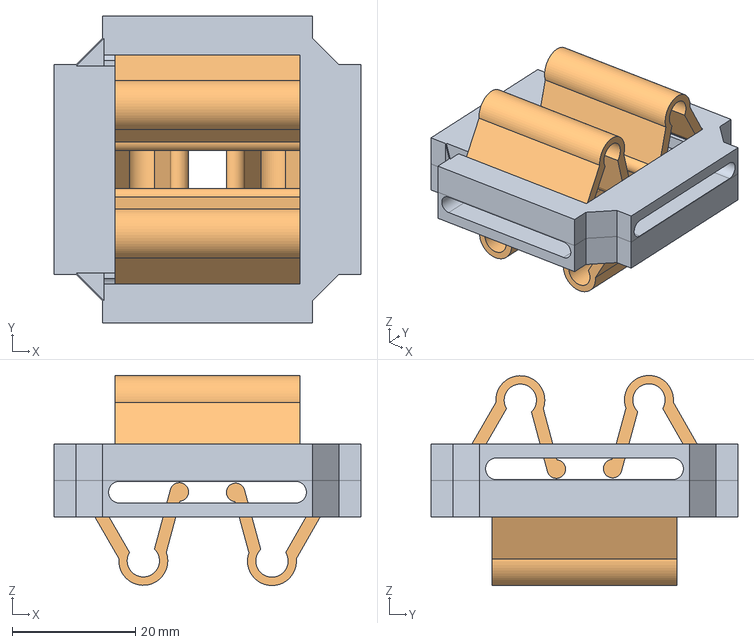
[picture p40: CAD file, 2022-11-30]
STEP/20_Rect_Aperture_test_full.iam.step
49.8 x 49.8 x 34.1 mm
20_Rect_Aperture_Insert_half_v3 x 2
20_Rect_Aperture_door_test x 4
