openUC2/UC2-STEP/STEP/Assembly_Cube_Samplebase_v3.iam.step

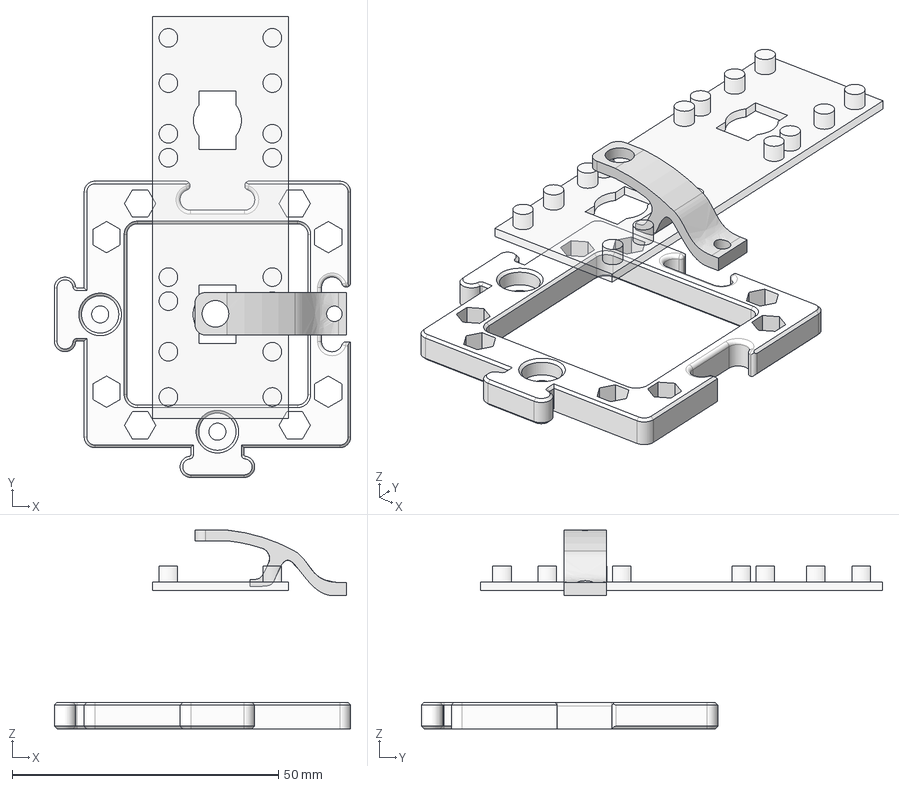
[picture p41: CAD file, 2022-11-30]
STEP/Assembly_Cube_Samplebase_v3.iam.step
55.6 x 86.5 x 37.3 mm
10_Base_puzzle_v3
00_FluidicChip_AlexSwen
30_Cube_Chipadapter_Fluicis
30_Cube_Chipadapter_Fluicis_clamp
