openUC2/UC2-STEP/STEP/Assembly_Cube_AlliedVision_Alvium_v3.iam.step

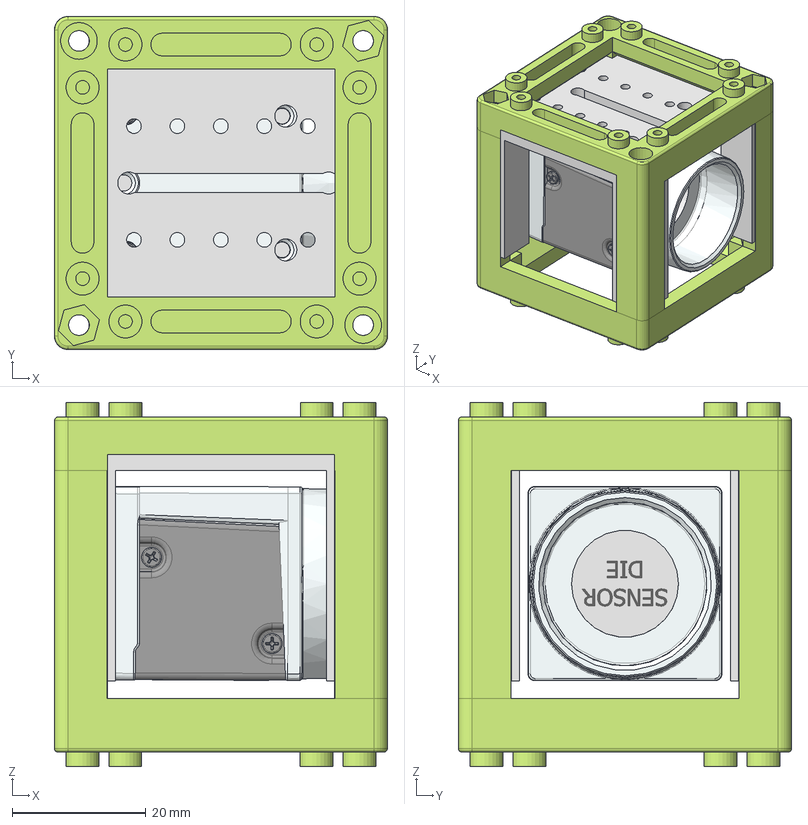
[picture p42: CAD file, 2022-11-30]
STEP/Assembly_Cube_AlliedVision_Alvium_v3.iam.step
49.8 x 49.8 x 54.5 mm
10_Cube_1x1_IM x 2
20_Cube_insert_AlliedVision_Alvium_v3
00_Basler_ace_USB3_C-Mount
