openUC2/UC2-STEP/STEP/Assembly_Cube_Dichroic_Beamsplitter_25x35_v3.iam.step

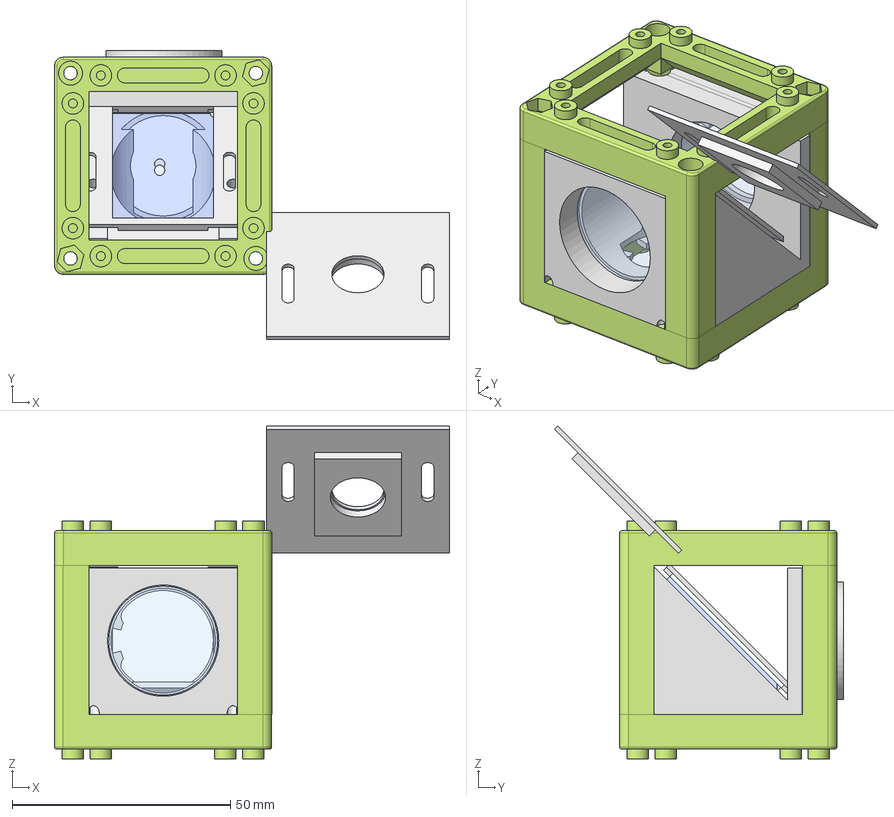
[picture p43: CAD file, 2022-11-30]
STEP/Assembly_Cube_Dichroic_Beamsplitter_25x35_v3.iam.step
90.6 x 66.2 x 76.3 mm
10_Cube_1x1_IM x 2
20_Cube_Insert_Beamsplittercube_Base_25x35_v3
00_Comar_Dichroic_16x25x0.2
00_Comar_Filter_25Dia x 3
20_Cube_Insert_Beamsplittercube_Retainring_25mm x 2
20_Cube_Insert_Beamsplittercube_Dichroicmirror_Retainplate
20_Cube_Insert_Beamsplittercube_Dichroicmirror_Retainplate_filteradap ter12.5mm_25_36
