openUC2/UC2-STEP/STEP/Assembly_Cube_SQUID_Z_Focus_v3.iam.step

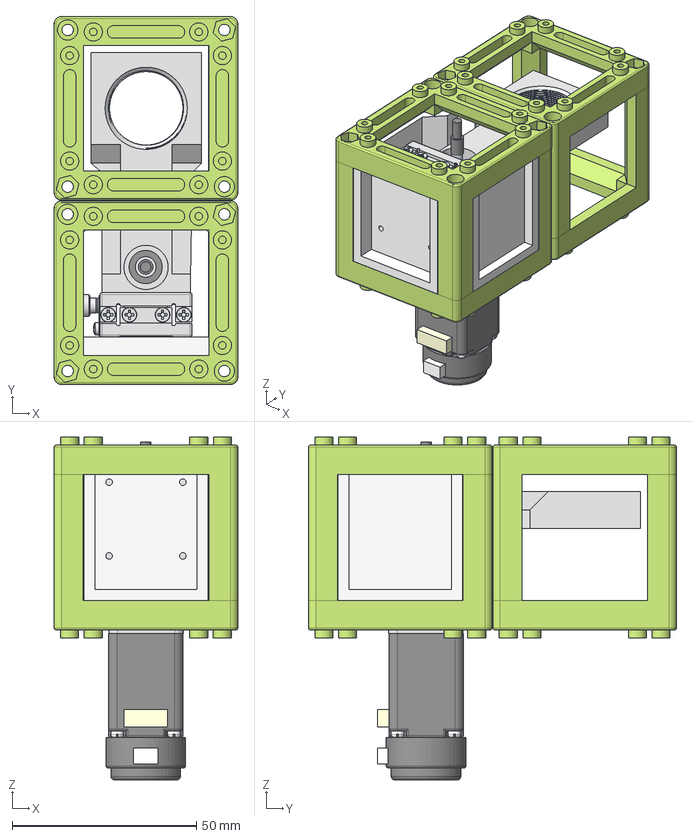
[picture p44: CAD file, 2022-11-30]
STEP/Assembly_Cube_SQUID_Z_Focus_v3.iam.step
49.8 x 99.8 x 93.0 mm
30_Cube_SQUID_Z_Focus_base_v3
Group1^MX25-SC(«¬¿ý)
Group2^MX25-SC(«¬¿ý)
10_Cube_1x1_IM x 4
30_Cube_SQUID_Z_Focus_slide_v3
30_Cube_SQUID_Z_Focus_spacer_v3
AMETEK-21H4U-2_5-0_75-12-ENC
