openUC2/UC2-STEP/STEP/Assembly_Cube_Z_Focus_Drylin_NEMA_slide.iam.step

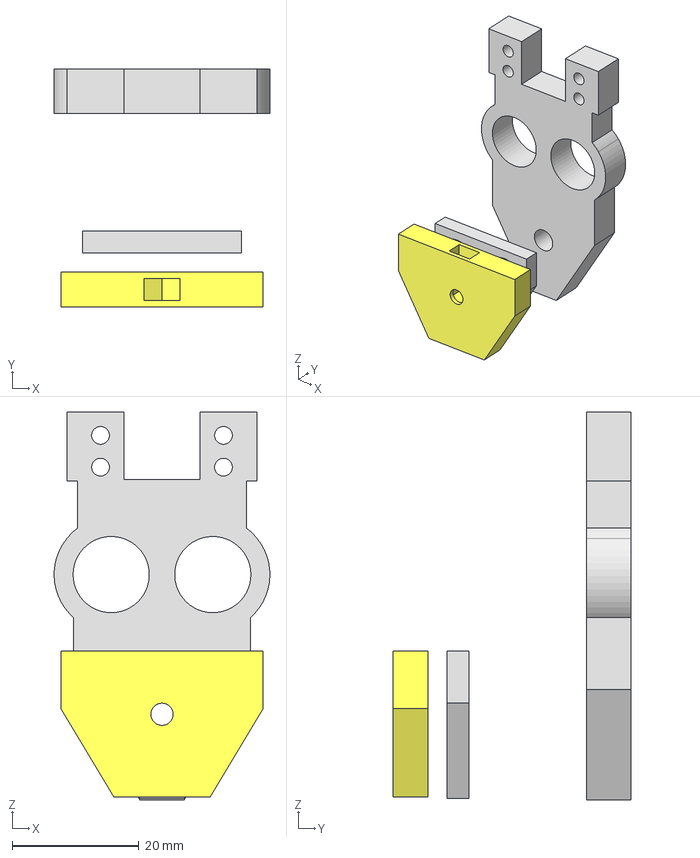
[picture p45: CAD file, 2022-11-30]
STEP/Assembly_Cube_Z_Focus_Drylin_NEMA_slide.iam.step
34.0 x 37.5 x 61.1 mm
30_Cube_Z_Focus_Drylin_NEMA_slide_part1
30_Cube_Z_Focus_Drylin_NEMA_slide_part1_1
30_Cube_Z_Focus_MGN_NEMA_slide_part2
