openUC2/UC2-STEP/STEP/Assembly_Cube_explosion_IM_v3.iam.step

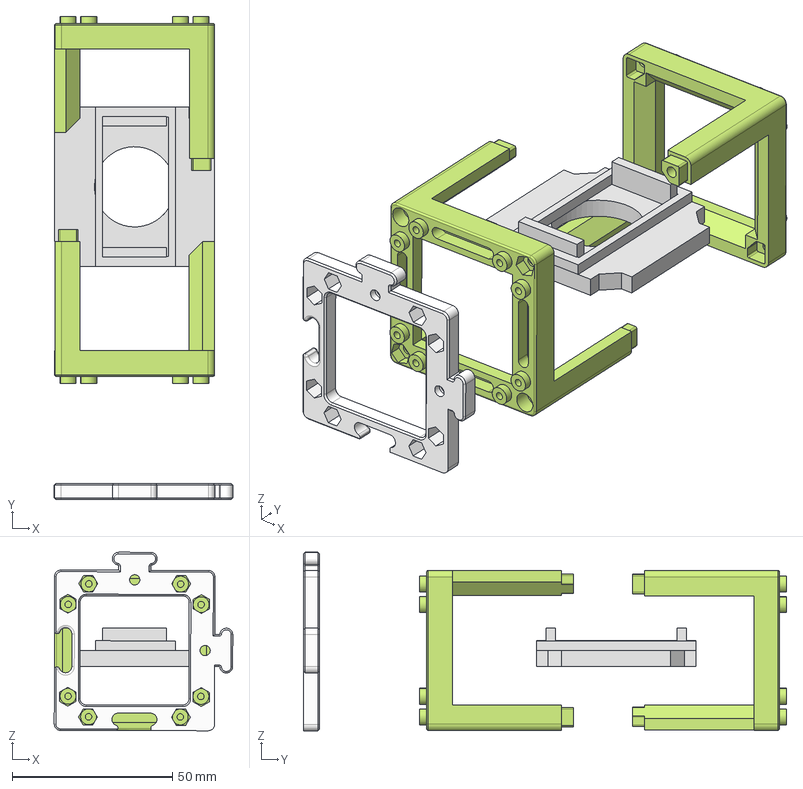
[picture p46: CAD file, 2022-11-30]
STEP/Assembly_Cube_explosion_IM_v3.iam.step
55.7 x 150.6 x 55.7 mm
10_Base_puzzle_v3
10_Cube_1x1_IM x 2
20_Cube_Insert_Sample_clamp
20_Cube_insert_Sample_holder_v3
