openUC2/UC2-STEP/STEP/Assembly_Cube_CircularAperture_v3 - Kopie.iam.step

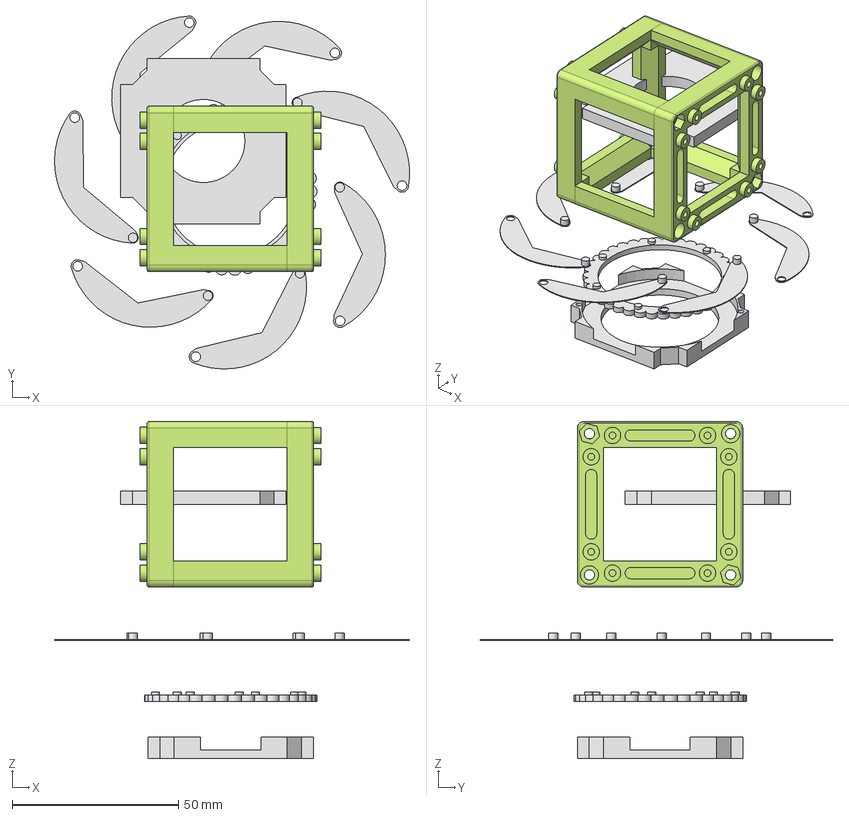
[picture p47: CAD file, 2022-11-30]
STEP/Assembly_Cube_CircularAperture_v3 - Kopie.iam.step
106.8 x 106.2 x 101.4 mm
20_Cube_Insert_CirAp_Lid_v3
20_Cube_Insert_CirAp_Wheel
20_Cube_Insert_CirAp_Guide_v3
10_Cube_1x1_IM x 2
20_Cube_Insert_CirAp_Leaf x 7
