openUC2/UC2-STEP/STEP/Assembly_Cube_Mirror_Stairs_NEW_v3.iam.step

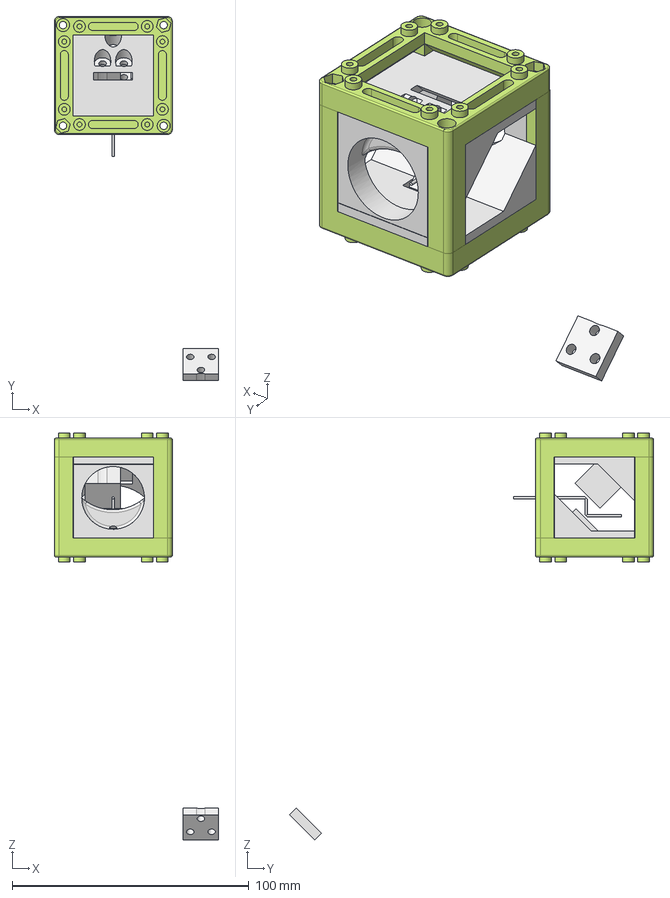
[picture p48: CAD file, 2022-11-30]
STEP/Assembly_Cube_Mirror_Stairs_NEW_v3.iam.step
69.4 x 153.7 x 171.8 mm
20_Cube_Insert_Mirror_Stairs_fixed_v3 x 2
10_Cube_1x1_IM x 2
00_Beam_Stairs_7.5mm
20_Cube_Insert_Mirror_Stairs_fixed_varspacer1_v3 x 2
20_Cube_Insert_Mirror_Stairs_fixed_varspacer2_v3
