openUC2/UC2-STEP/STEP/Assembly_Cube_Insert_Laser_Decentered_Galvo_v3.iam.step

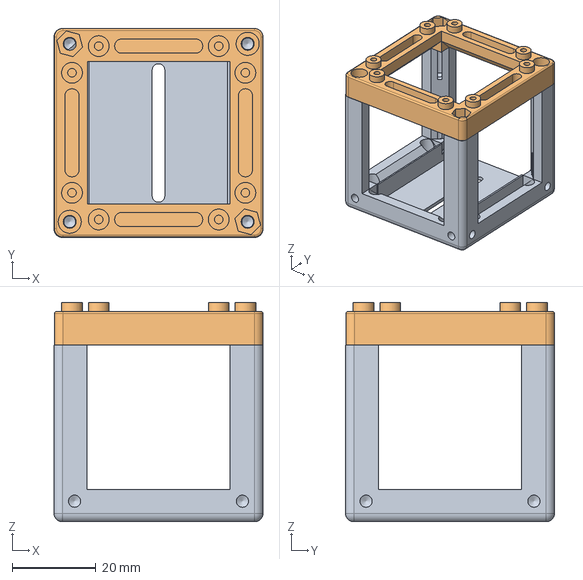
[picture p50: CAD file, 2022-11-30]
STEP/Assembly_Cube_Insert_Laser_Decentered_Galvo_v3.iam.step
49.8 x 49.8 x 52.3 mm
10_Cube_1x1_v2
20_Cube_Insert_Laser_Decentered_Galvo_lid_1
