openUC2/UC2-STEP/STEP/20_Cube_Insert_Template_fullcube_v3.ipt.step

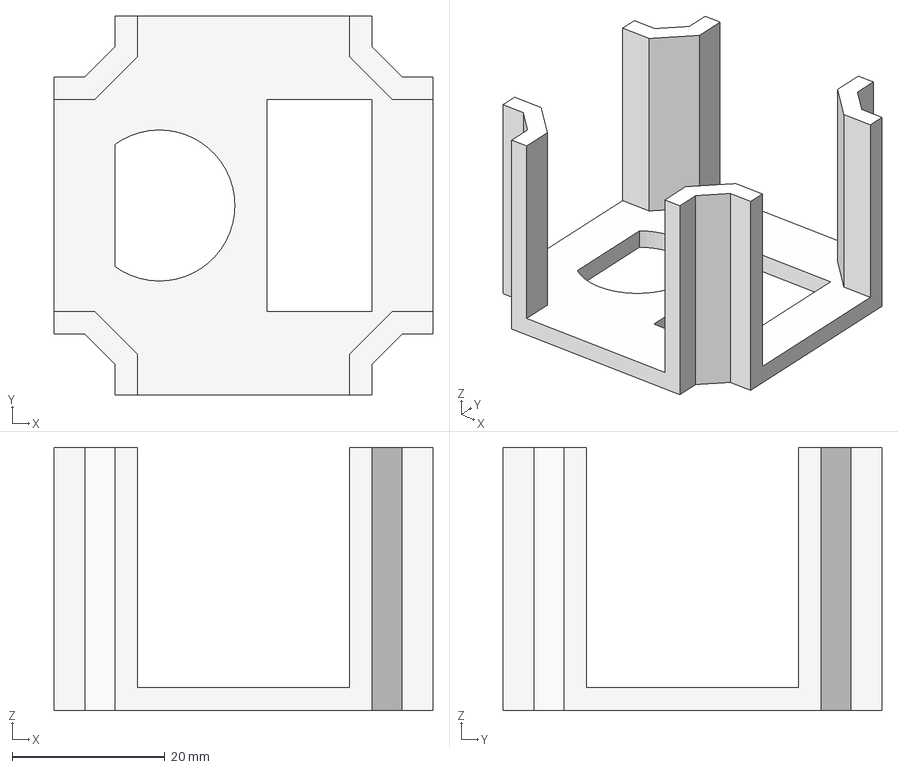
[picture p51: CAD file, 2022-11-30]
STEP/20_Cube_Insert_Template_fullcube_v3.ipt.step
49.7 x 49.7 x 34.5 mm
