openUC2/UC2-STEP/STEP/Assembly_Cube_Fibermount_LC_v3.iam.step

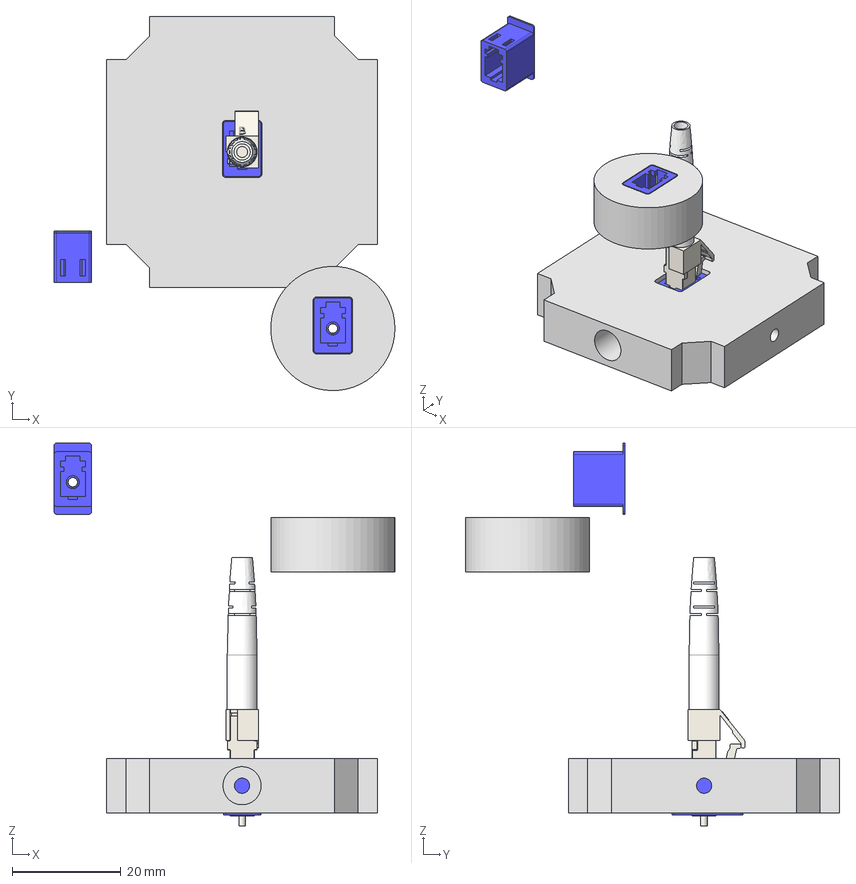
[picture p52: CAD file, 2022-11-30]
STEP/Assembly_Cube_Fibermount_LC_v3.iam.step
62.6 x 68.7 x 70.4 mm
20_Cube_Insert_Fiber_STMount_Center
00_SM05LC-Step x 3
00_LC_Duplex_Fiber_Connector
00_SM05LC-toRMS
