openUC2/UC2-STEP/STEP/Assy_Support Profile.iam.step

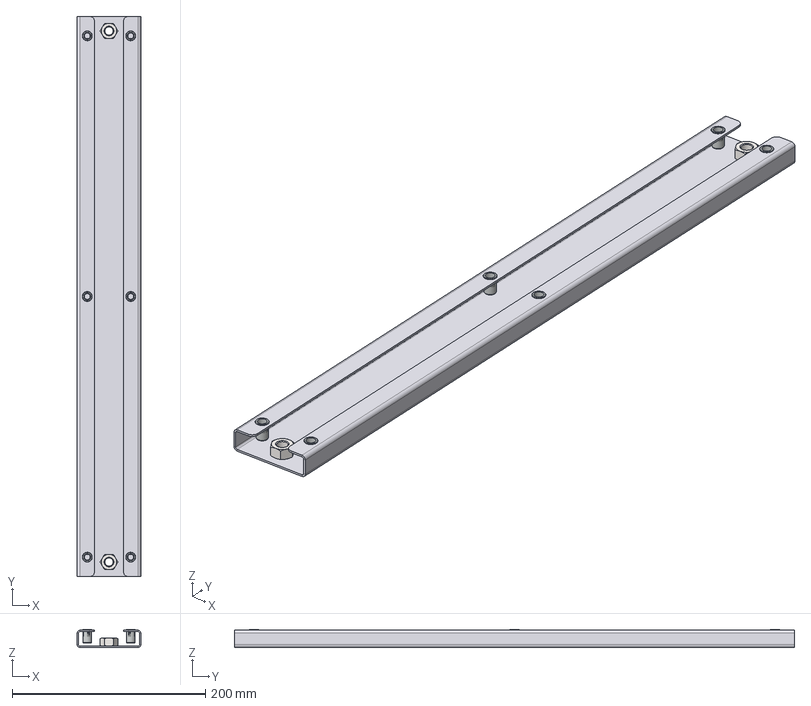
[picture p53: CAD file, 2022-11-30]
STEP/Assy_Support Profile.iam.step
66.0 x 580.0 x 18.7 mm
Support profile
Nut Rivet M6 x 6
hex nut style 1 gradeab_iso_ISO - 4032 - M10 - D - N x 2
