openUC2/UC2-STEP/STEP/Assembly_Cube_2D_Galvo_v3.iam.step

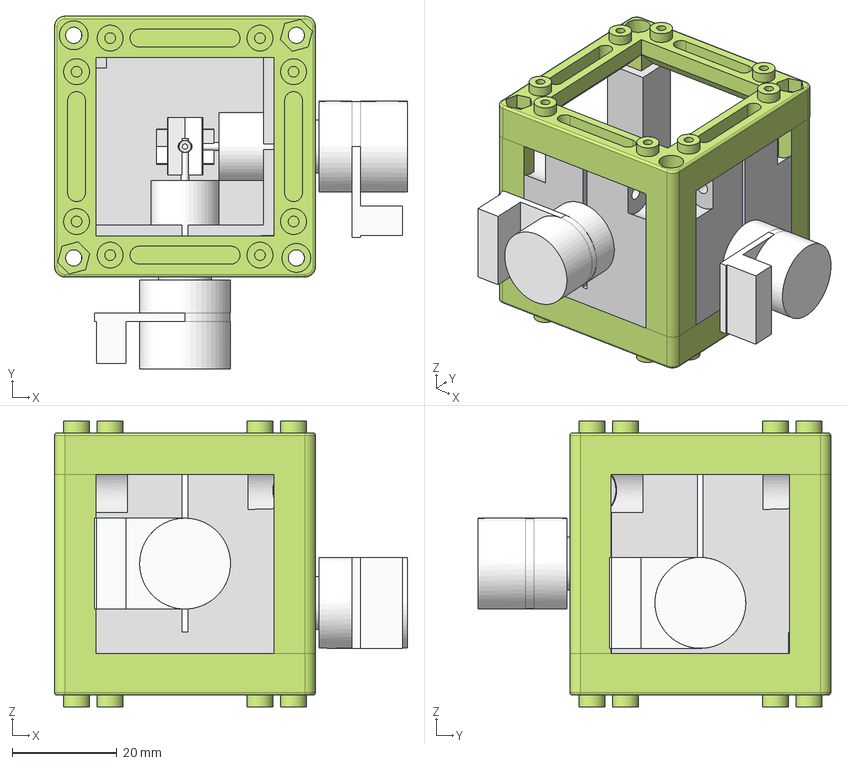
[picture p54: CAD file, 2022-11-30]
STEP/Assembly_Cube_2D_Galvo_v3.iam.step
67.4 x 67.3 x 54.5 mm
00_Galvo_Taobao x 2
10_Cube_1x1_IM x 2
20_Cube_insert_AlliedVision_Alvium_v3
