openUC2/UC2-STEP/STEP/Assembly_XYZ_micrometre_heightadapter.iam.step

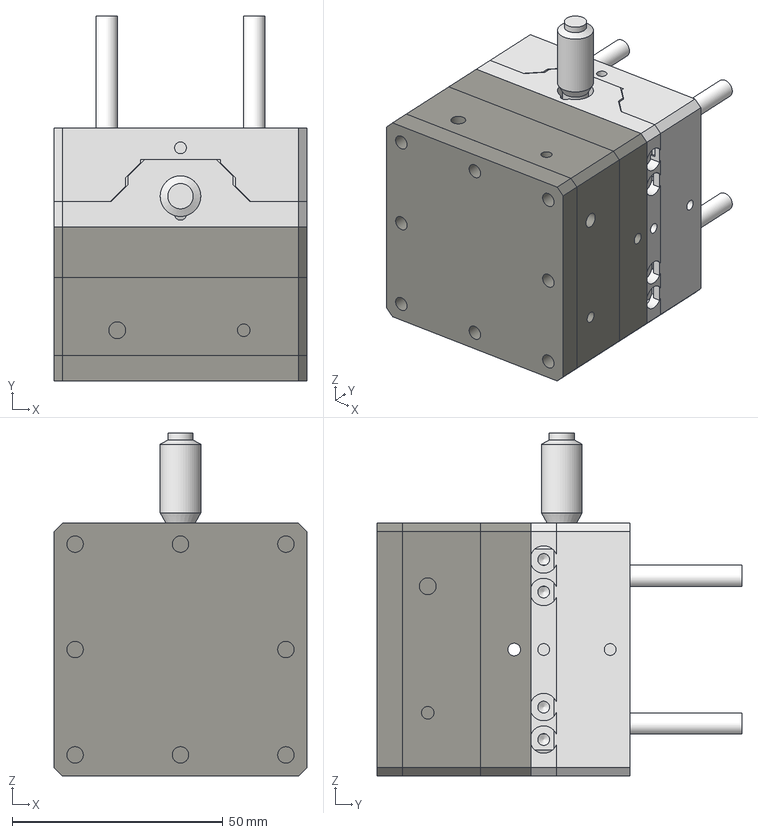
[picture p55: CAD file, 2022-11-30]
STEP/Assembly_XYZ_micrometre_heightadapter.iam.step
60.0 x 86.5 x 81.4 mm
00_XY_stage-CHUO_SEIKI_LD-647-R1-Top
00_XY_stage-CHUO_SEIKI_LD-647-R1-Middle
00_XY_stage-CHUO_SEIKI_LD-647-R1-Bottom
40_XYStage_Heightadapter_Base
00_RS_Pro_Micrometer_small
00_rod_5mm x 4
40_XYStage_Heightadapter_Levelarm
40_XYStage_Heightadapter_Slide
