openUC2/UC2-STEP/STEP/Assembly_Cube_Syringepump_Micro_v3.iam.step

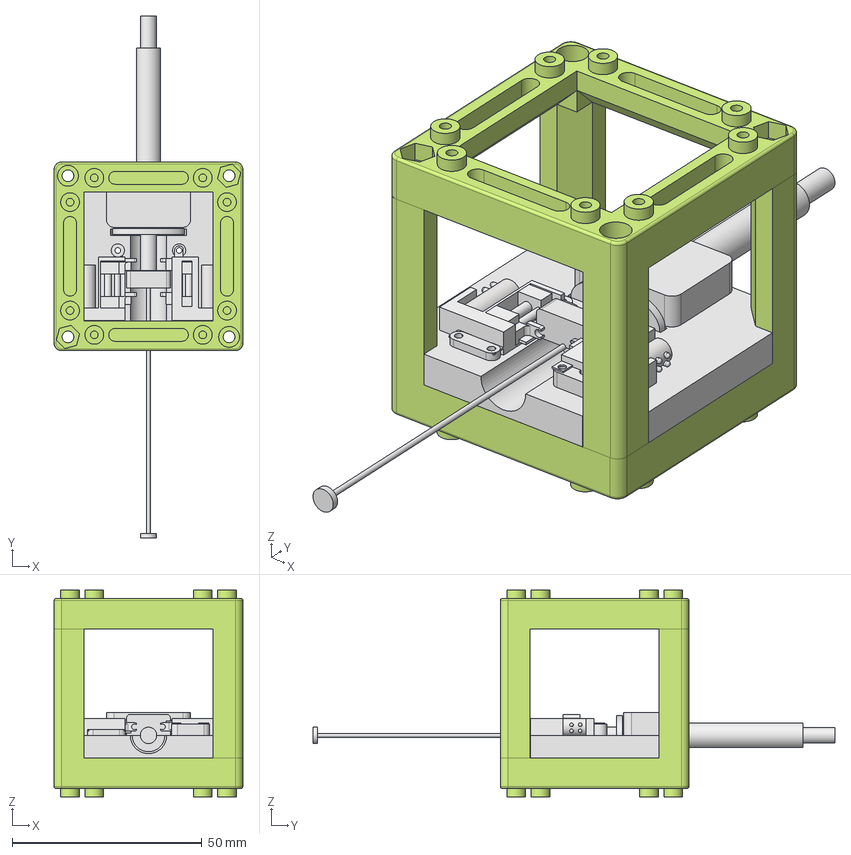
[picture p56: CAD file, 2022-11-30]
STEP/Assembly_Cube_Syringepump_Micro_v3.iam.step
49.8 x 137.7 x 54.5 mm
10_Cube_1x1_IM x 2
20_Cube_Insert_Syringepump_Micro_v3
00_Syringe_10ml
00_Microlinearmotor_aliexpress_5mm x 2
20_Cube_Insert_Template_magnetic_clamp_v3
20_Cube_Insert_Syringepump_Micro_syringeclamp_v3
