openUC2/UC2-STEP/STEP/Assembly_Cube_Beamexpander_v3.iam.step

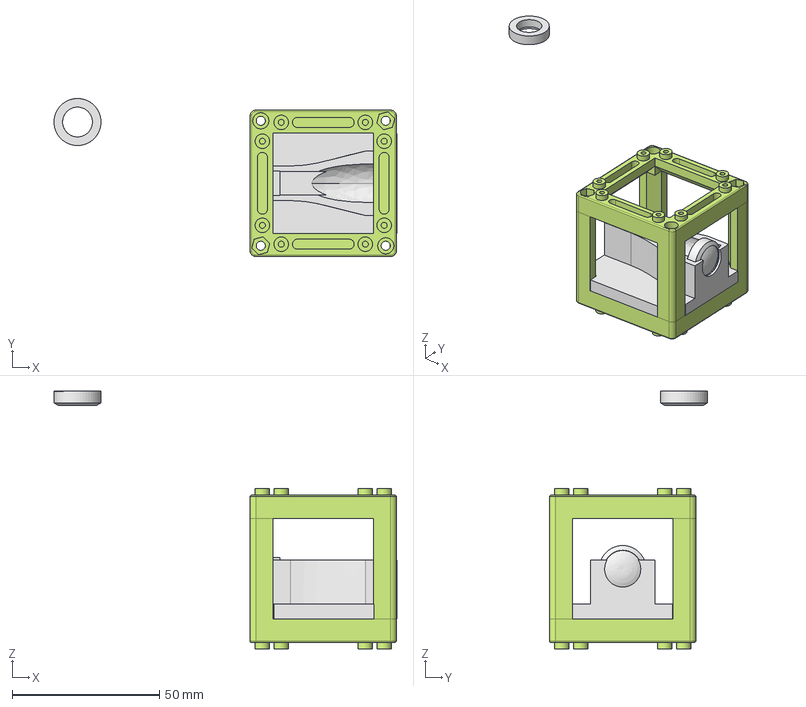
[picture p57: CAD file, 2022-11-30]
STEP/Assembly_Cube_Beamexpander_v3.iam.step
116.7 x 53.7 x 87.7 mm
10_Cube_1x1_IM x 2
20_Cube_Insert_Beamexpander_v3
20_Beamexpander_Lens_Adapter x 2
00_Lens_Iphone_5s
00_Lens_f_29_d12.6
