openUC2/UC2-STEP/STEP/Assembly_Cube_Lens_holder_100mm_v3.iam.step

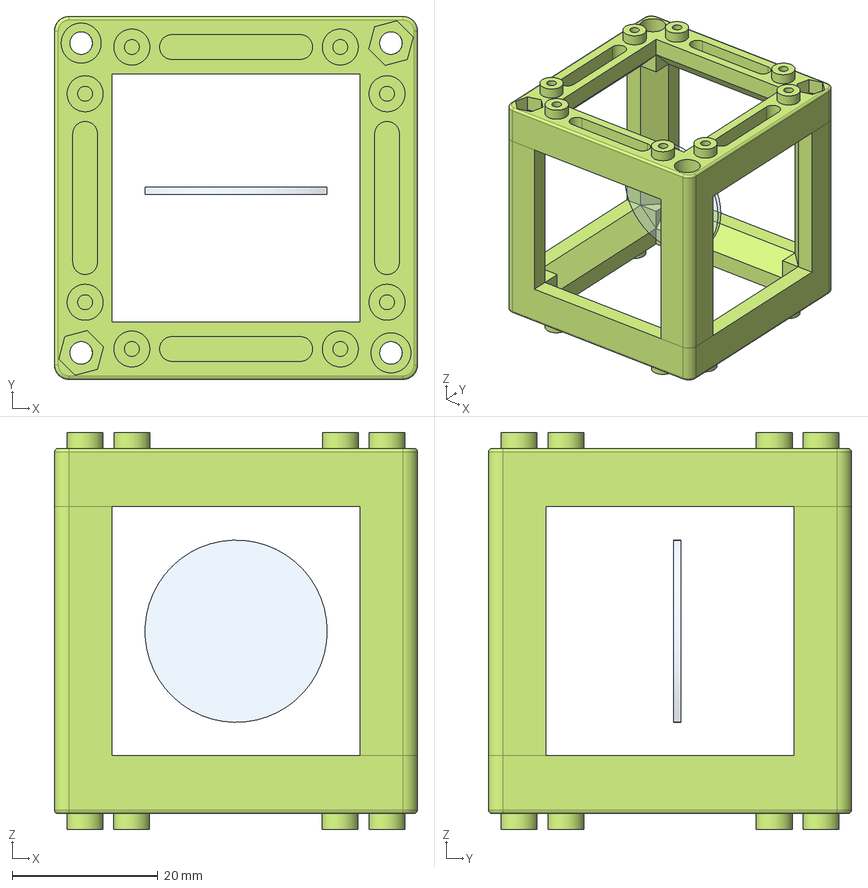
[picture p58: CAD file, 2022-11-30]
STEP/Assembly_Cube_Lens_holder_100mm_v3.iam.step
49.8 x 49.8 x 54.5 mm
10_Cube_1x1_IM x 2
20_Insert_Lens_holder_v3_imported
20_Insert_Lens_clamp_v3
00_Comar_Filter_25Dia
