openUC2/UC2-STEP/STEP/Assembly_Voicecoil_Flexure_Scanner_v0.iam.step

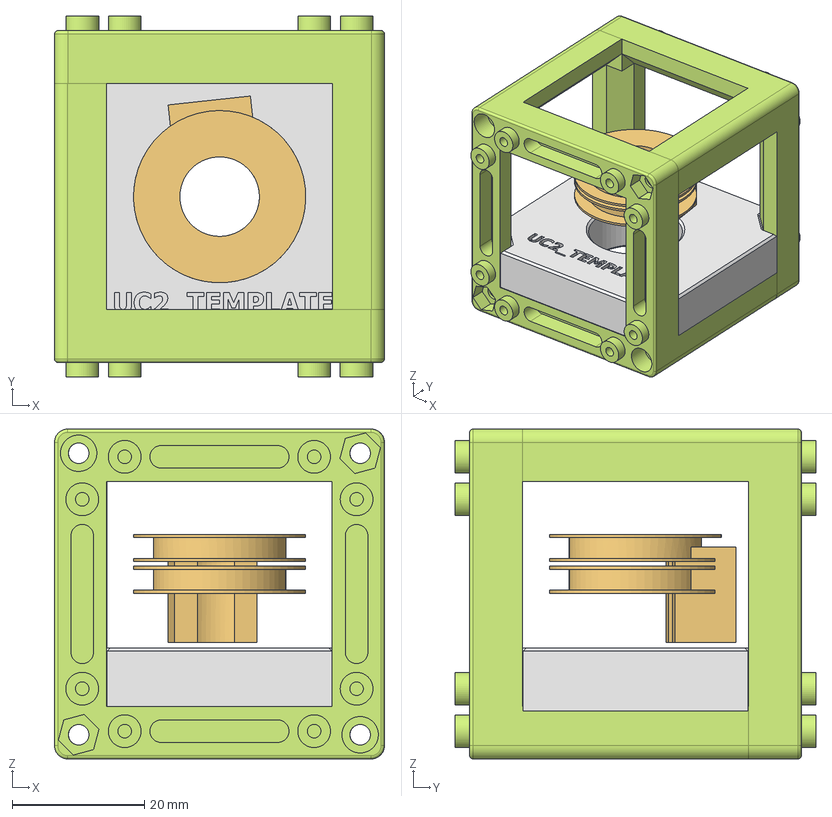
[picture p59: CAD file, 2022-11-30]
STEP/Assembly_Voicecoil_Flexure_Scanner_v0.iam.step
49.8 x 54.5 x 49.8 mm
50_ETL_28by_coil
10_Cube_1x1_IM x 2
20_Cube_Insert_Filter_25mm
