openUC2/UC2-STEP/STEP/Assembly_cellSTORM_fiberbase_v3.iam.step

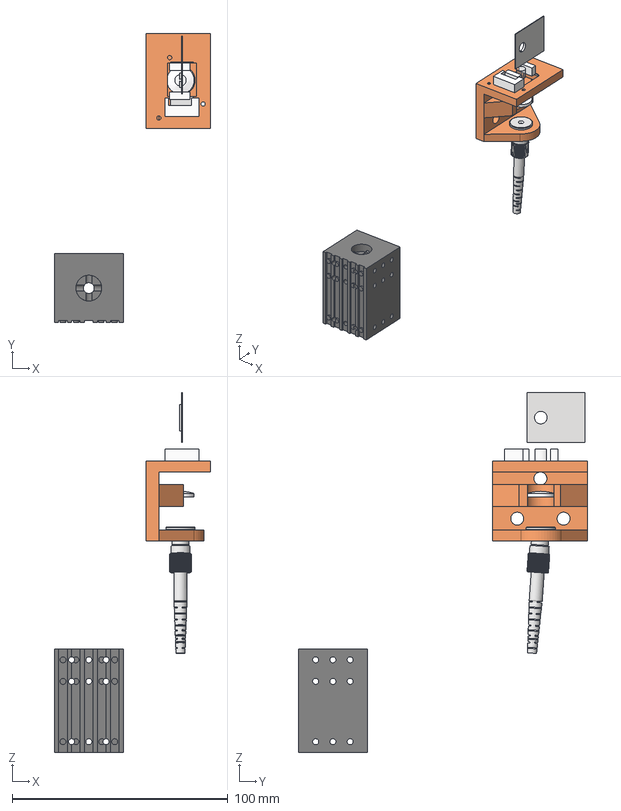
[picture p60: CAD file, 2022-11-30]
STEP/Assembly_cellSTORM_fiberbase_v3.iam.step
72.5 x 134.2 x 167.0 mm
P1-305A-FC-1-Step
SM05FCA-Step
LA1304-Step
30_cellSTORM_fiberbase_base_v3
02_Nanoscopy_Chip
00_LASER_640nm
00_KES400_Bluray_Lens
00_KES_Bluray_Magnet
00_KES400_Lens
