openUC2/UC2-STEP/STEP/Assembly_Openflexure_Deltagstage_v3.iam.step

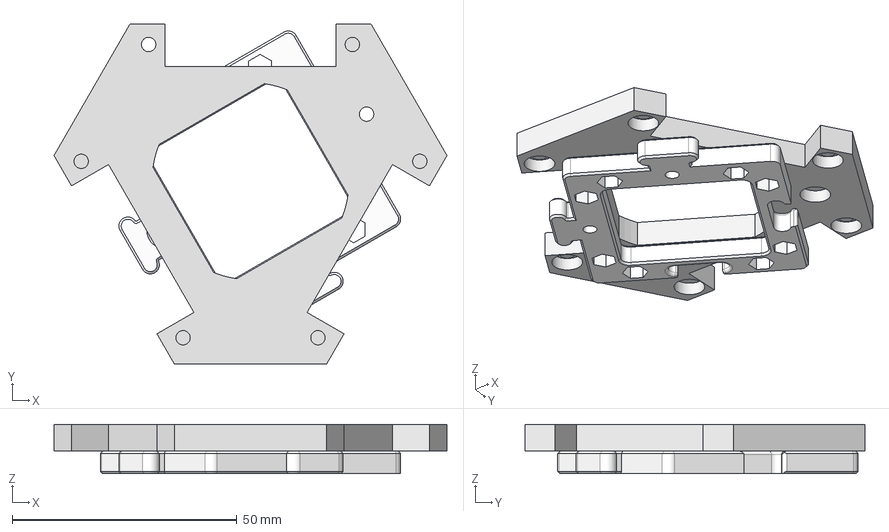
[picture p61: CAD file, 2022-11-30]
STEP/Assembly_Openflexure_Deltagstage_v3.iam.step
87.4 x 75.7 x 11.0 mm
00_openflexure_delta_stage_06_22
20_Cube_Insert_Openflexure_Deltastage_Adapter
