openUC2/UC2-STEP/STEP/Assembly_Cube_Dichroic_Beamsplitter_multi_motorized_25x35_linearmotor_v3.iam.step

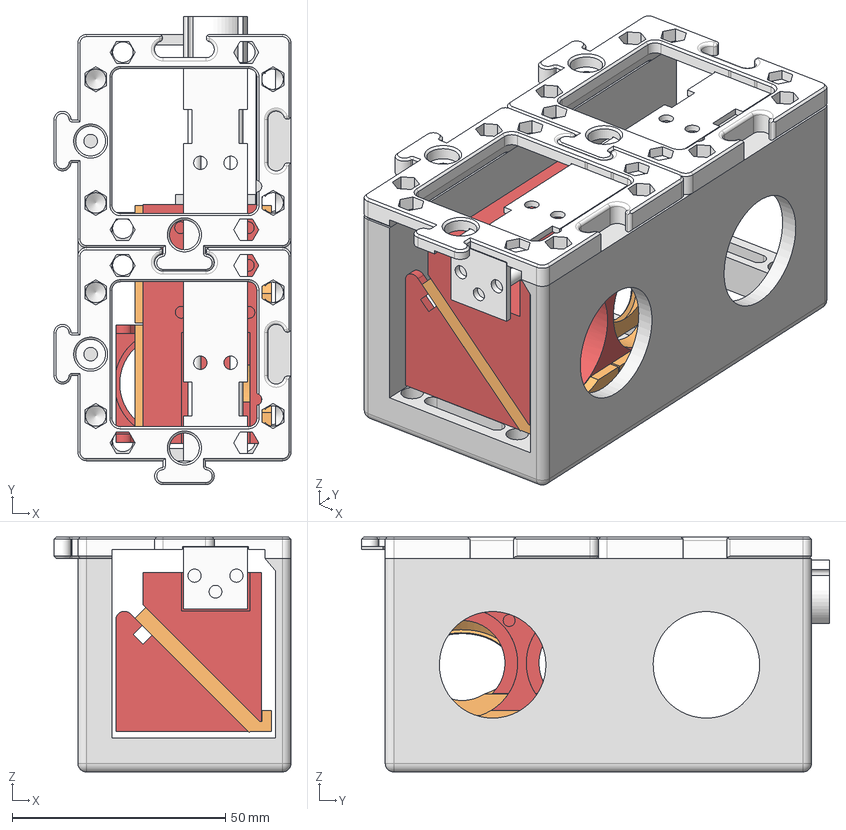
[picture p62: CAD file, 2022-11-30]
STEP/Assembly_Cube_Dichroic_Beamsplitter_multi_motorized_25x35_linearmotor_v3.iam.step
55.6 x 109.9 x 55.1 mm
30_Cube_Insert_Filter_Revolver_Filter_base_triple
00_Linear_Stepper_90mm
00_Linear_Stepper_90mm_slide
20_Cube_Insert_Beamsplittercube_motorized_base_slide_linearmotor x 2
30_Cube_Insert_Filter_Revolver_Filter_lid_linearmotor x 2
30_Cube_Insert_Filter_Revolver_Filter_lid_triple_linearmotor
30_Cube_Insert_Filter_Revolver_Filter_lid_linearmotor_excitationfilte r
