openUC2/UC2-STEP/STEP/Assembly_Cube_LED_Matrix_v3.iam.step

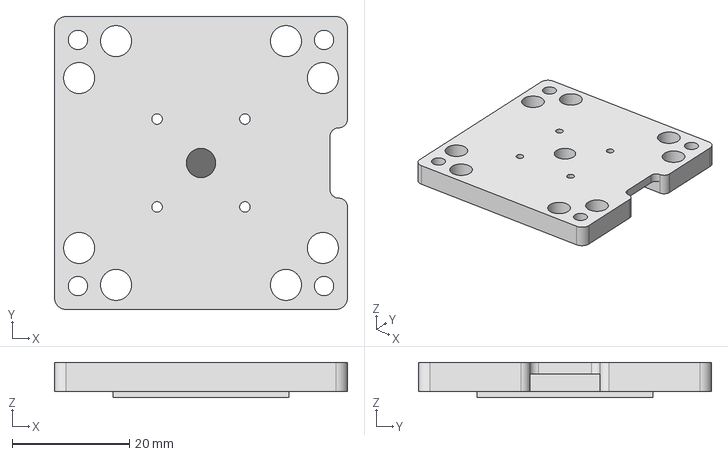
[picture p64: CAD file, 2022-11-30]
STEP/Assembly_Cube_LED_Matrix_v3.iam.step
50.0 x 50.0 x 6.00 mm
00_LED-ARRAY_4x4
20_IM_LED_holder
