openUC2/UC2-STEP/STEP/Assembly_Cube_empty_IM_v3.iam.step

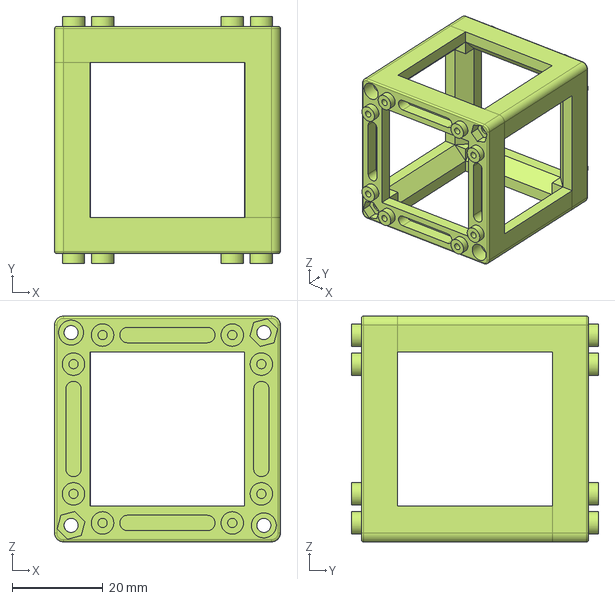
[picture p66: CAD file, 2022-11-30]
STEP/Assembly_Cube_empty_IM_v3.iam.step
49.8 x 54.5 x 49.8 mm
10_Cube_1x1_IM x 2
