openUC2/UC2-STEP/STEP/Assembly_Z-Stage_Sampleholder.iam.step

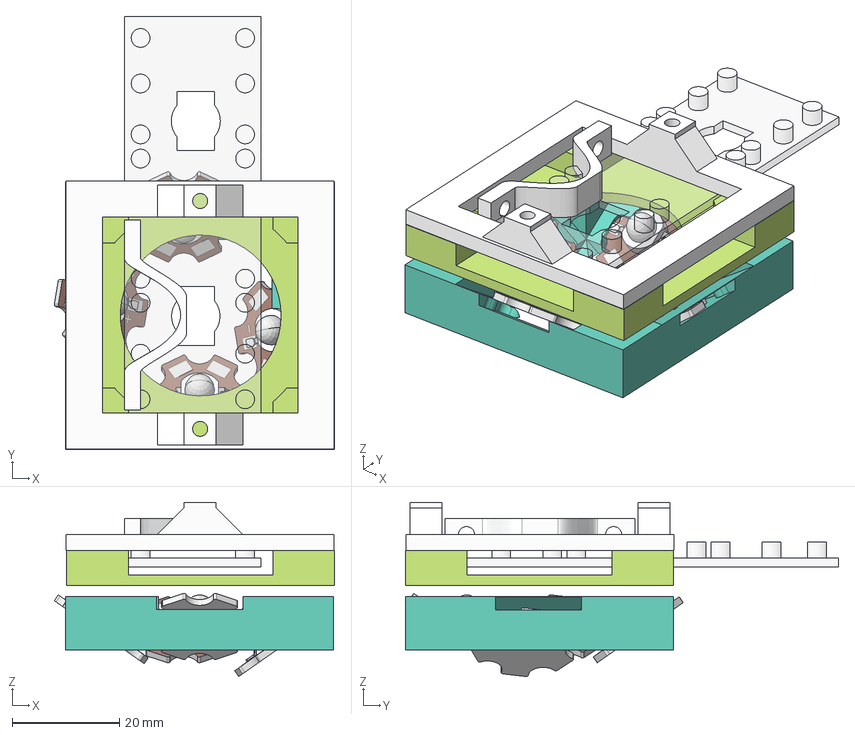
[picture p67: CAD file, 2022-11-30]
STEP/Assembly_Z-Stage_Sampleholder.iam.step
52.3 x 80.8 x 32.5 mm
30_XY_Stage_Clamp_Slide
00_FluidicChip_AlexSwen
30_Z_Stage_Adapterplate
30_Z_Stage_Fluomodule
00_LED_star_base x 4
00_LED_lens x 4
00_LED_smd_body x 4
