openUC2/UC2-STEP/STEP/Assembly_Cube_Lens_Cylindrical__cheap_v3.iam.step

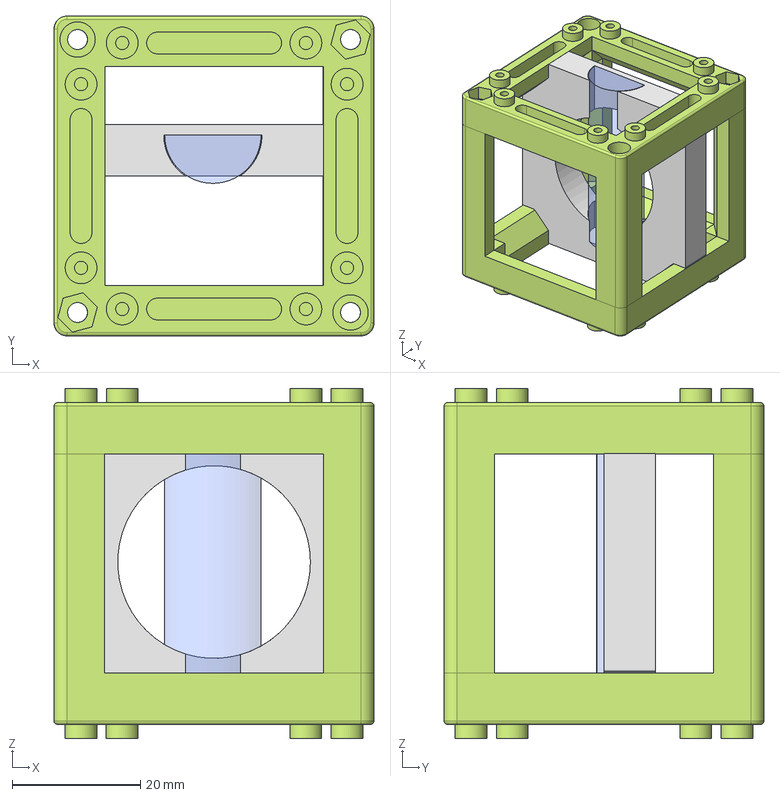
[picture p68: CAD file, 2022-11-30]
STEP/Assembly_Cube_Lens_Cylindrical__cheap_v3.iam.step
49.8 x 49.8 x 54.5 mm
10_Cube_1x1_IM x 2
00_Glassslab_Lens_Cylindrical_30mm_Plexiglas
20_Cube_Insert_Lens_Cylindrical_v3
