openUC2/UC2-STEP/STEP/Assembly_Cube_Z_Focus_MGN_manual_v3.iam.step

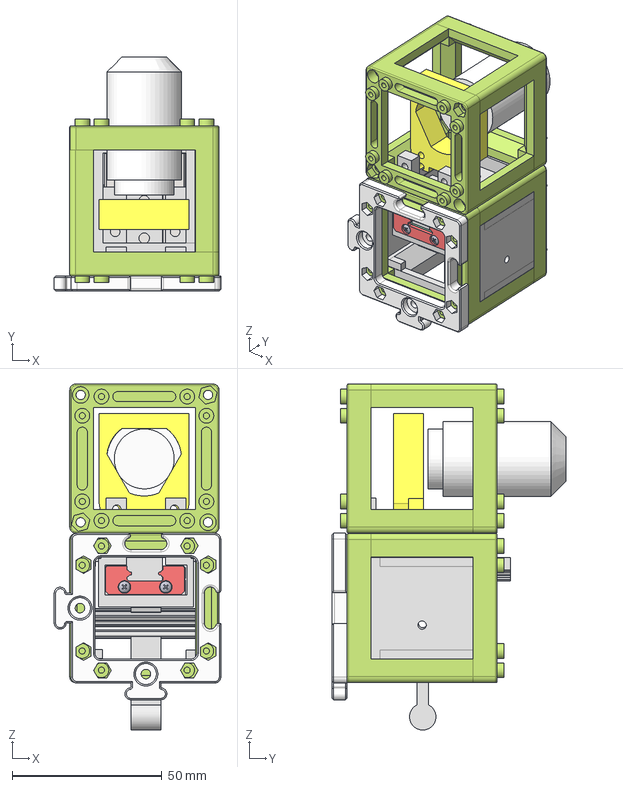
[picture p69: CAD file, 2022-11-30]
STEP/Assembly_Cube_Z_Focus_MGN_manual_v3.iam.step
55.6 x 78.0 x 115.5 mm
10_Cube_1x1_IM x 4
00_MGN12H, LINEAR GUIDE BLOCK
30_Cube_Z_Focus_MGN_manual_base_v3
00_Microscope_Objective_Lens10x
10_Base_puzzle_v3
30_Cube_Z_Focus_MGN_NEMA_rail
30_Cube_Z_Focus_MGN_NEMA_adapter
30_Cube_Z_Focus_MGN12_NEMA_slide_part2
30_Cube_Z_Focus_MGN12_manual_gear_v3
