openUC2/UC2-STEP/STEP/Assembly_Cube_Dichroic_Beamsplitter_multi_motorized_25x35_linearmotor_90degreerot_v3.iam.step

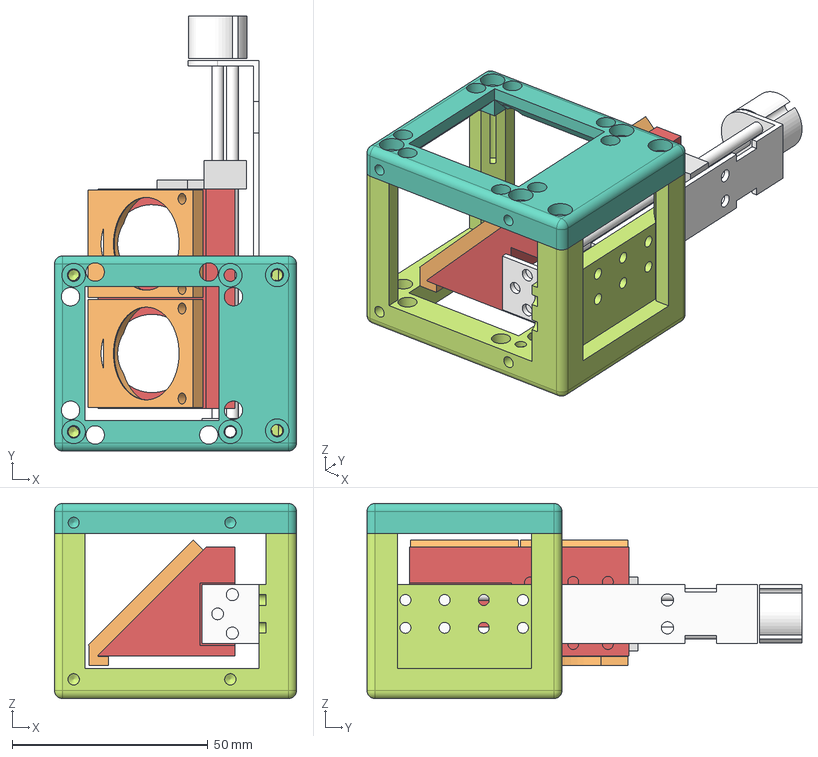
[picture p71: CAD file, 2022-11-30]
STEP/Assembly_Cube_Dichroic_Beamsplitter_multi_motorized_25x35_linearmotor_90degreerot_v3.iam.step
61.8 x 111.1 x 49.8 mm
30_Cube_Insert_Filter_Revolver_Filter_base_triple
00_Linear_Stepper_90mm
00_Linear_Stepper_90mm_slide
20_Cube_Insert_Beamsplittercube_motorized_cube_base
20_Cube_Insert_Beamsplittercube_motorized_cube_LID
30_Cube_Insert_Filter_Revolver_Filter_lid_linearmotor x 2
