openUC2/UC2-STEP/STEP/Assembly_Cube_Laser_Block_v3.iam.step

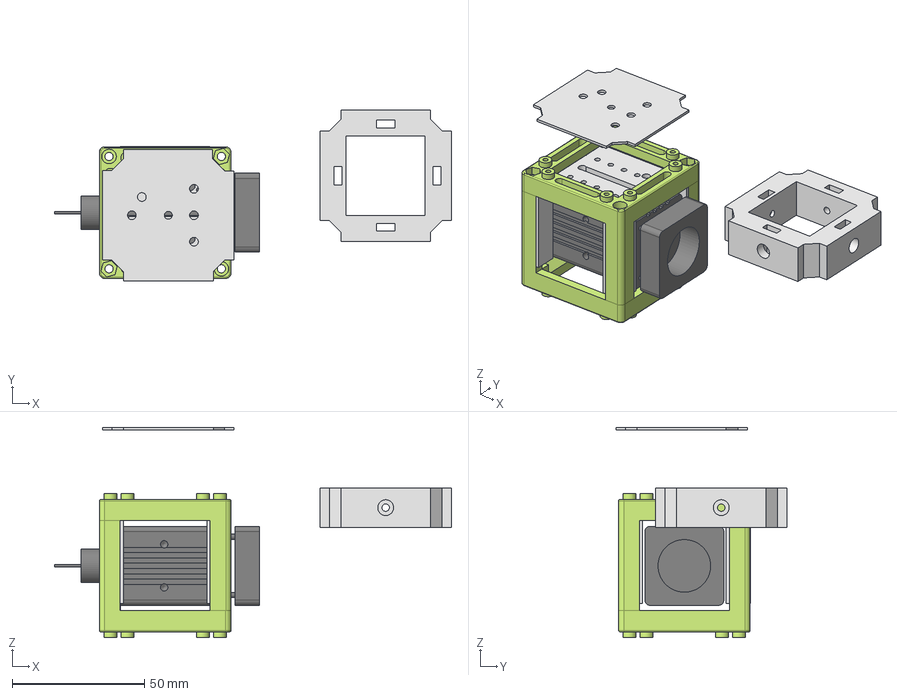
[picture p73: CAD file, 2022-11-30]
STEP/Assembly_Cube_Laser_Block_v3.iam.step
150.2 x 64.8 x 79.6 mm
10_Cube_1x1_IM x 2
00_Laser_532nm_200mw
20_Cube_insert_AlliedVision_Alvium_v3
20_Cube_insert_AlliedVision_Alvium_v3_1
30_Cube_Z_Focus_MGN_NEMA_Motorsupport_centered
