openUC2/UC2-STEP/STEP/Assembly_cellSTORM_laserbase_v3.iam.step

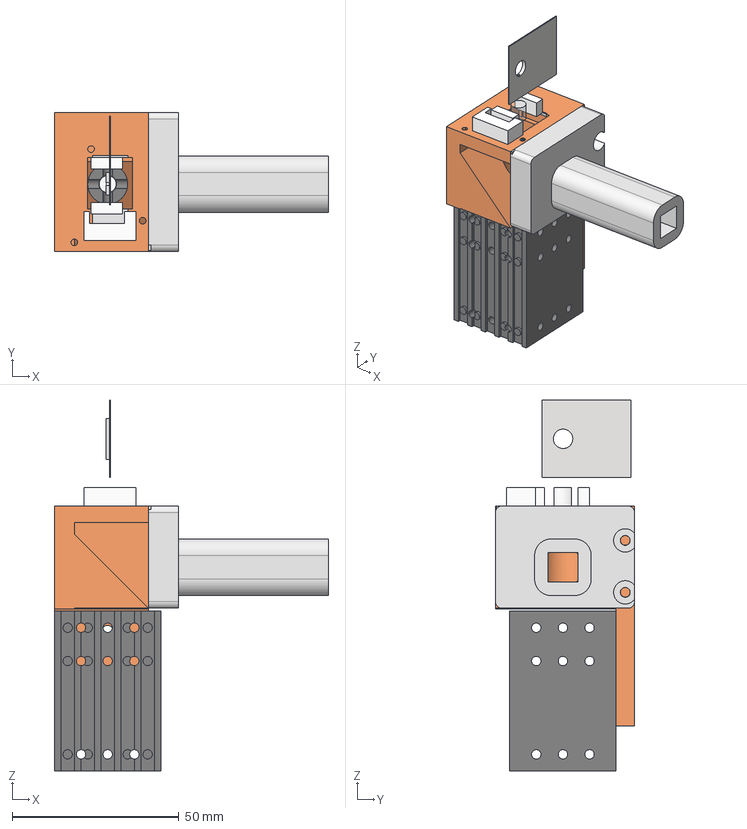
[picture p74: CAD file, 2022-11-30]
STEP/Assembly_cellSTORM_laserbase_v3.iam.step
82.3 x 41.8 x 111.3 mm
30_cellSTORM_laserbase_base_v3
02_Nanoscopy_Chip
00_LASER_640nm
00_KES400_Bluray_Lens
00_KES_Bluray_Magnet
00_KES400_Lens
30_cellSTORM_laserbase_ESP32cameradapter_v3
