openUC2/UC2-STEP/STEP/Assembly_Cube_Rect_Aperture_v3.iam.step

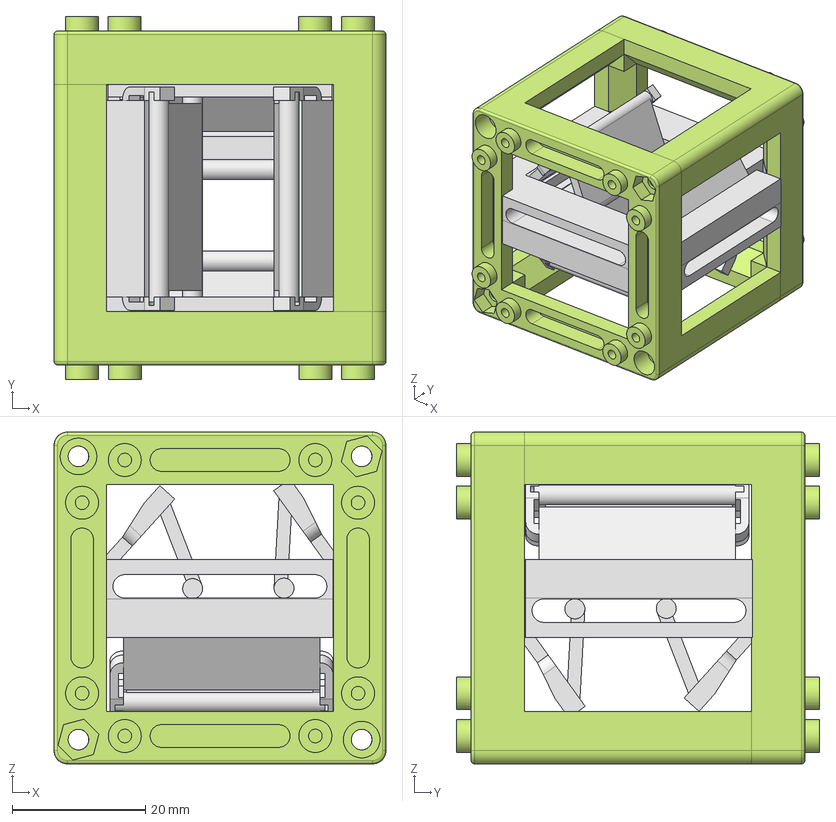
[picture p75: CAD file, 2022-11-30]
STEP/Assembly_Cube_Rect_Aperture_v3.iam.step
49.8 x 54.5 x 49.8 mm
10_Cube_1x1_IM x 2
20_Rect_Aperture_Insert_half_v3 x 2
20_Rect_Aperture_door_hinge x 4
20_Rect_Aperture_door_slide x 4
