openUC2/UC2-STEP/STEP/Assembly_Powersupply_Galvo.iam.step

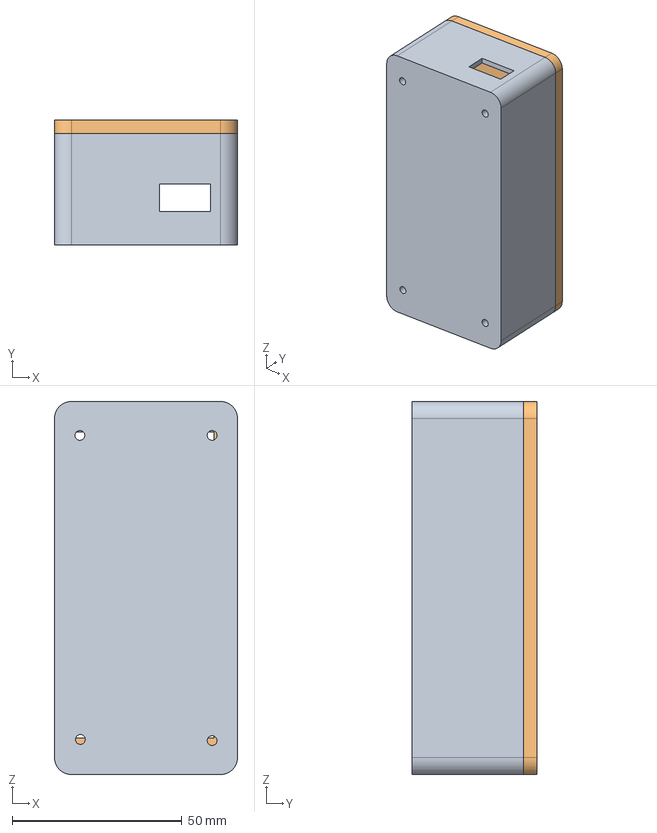
[picture p76: CAD file, 2022-11-30]
STEP/Assembly_Powersupply_Galvo.iam.step
54.0 x 37.0 x 110.0 mm
00_Case_Powersupply_Galvo
00_Case_Powersupply_Galvo_lid
