openUC2/UC2-STEP/STEP/Assembly_XYTable_Aliepexress_cellstorm_laserslide.iam.step

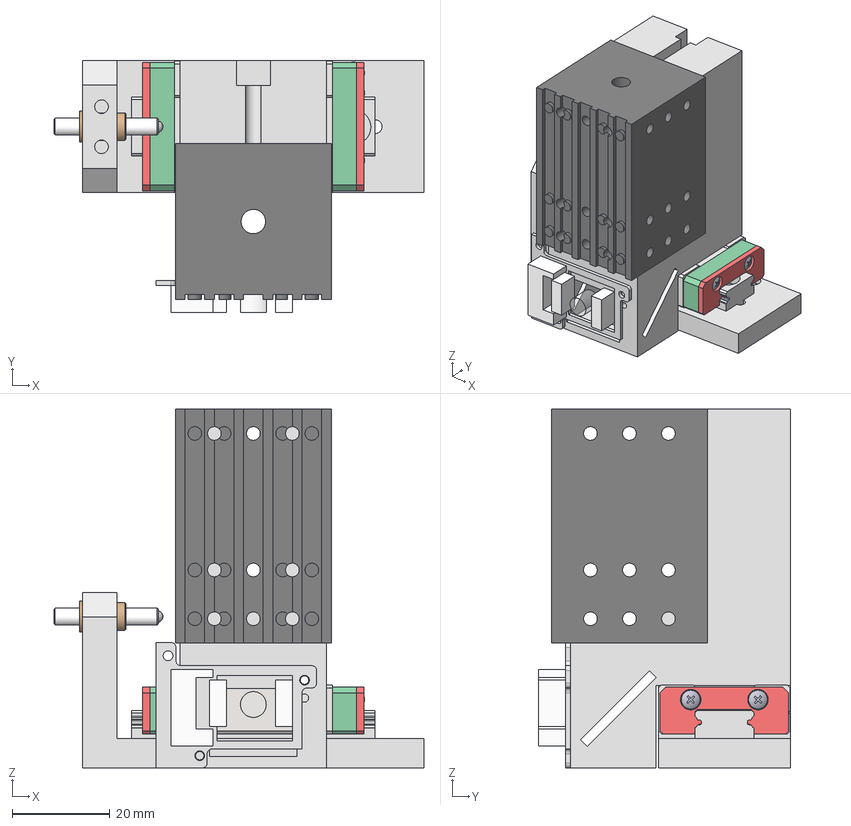
[picture p77: CAD file, 2022-11-30]
STEP/Assembly_XYTable_Aliepexress_cellstorm_laserslide.iam.step
75.9 x 51.7 x 73.6 mm
30_Cube_Z_Focus_MGN_NEMA_rail
00_MGN12H, LINEAR GUIDE BLOCK
00_LASER_640nm
30_XYTabel_Aliexpress_cellSTORM_xmount
30_XYTabel_Aliexpress_cellSTORM_lasermount
00_KES400_Bluray_Lens
00_KES_Bluray_Magnet
00_KES400_Lens
00_F6SSN2P-Step
00_F6SS088-Step
