openUC2/UC2-STEP/STEP/Assembly_BOX_Insert_Holder.ipt.step

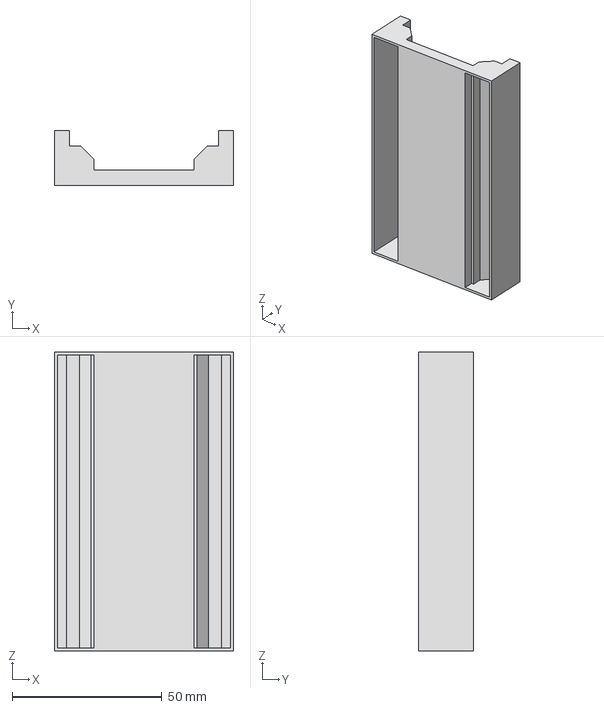
[picture p78: CAD file, 2022-11-30]
STEP/Assembly_BOX_Insert_Holder.ipt.step
60.0 x 18.3 x 100.0 mm
