openUC2/UC2-STEP/STEP/Assembly_Cube_KES400A_OPU_v3.iam.step

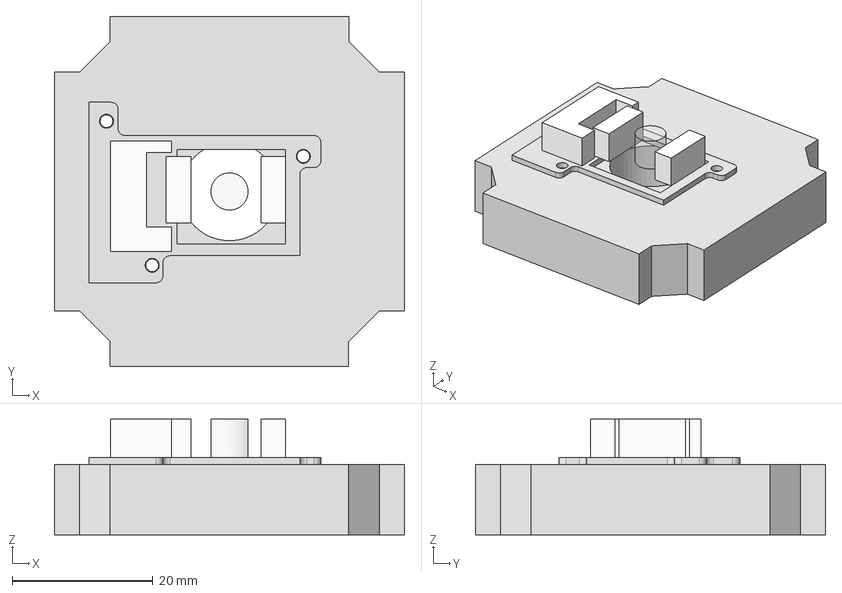
[picture p79: CAD file, 2022-11-30]
STEP/Assembly_Cube_KES400A_OPU_v3.iam.step
49.8 x 49.8 x 16.5 mm
20_Cube_Insert_Fiber_STMount_Center
00_KES400_Bluray_Lens
00_KES_Bluray_Magnet
00_KES400_Lens
