openUC2/UC2-STEP/STEP/EXPERIMENT_LEGO_Assembly_Cube_empty_IM_v3.iam.step

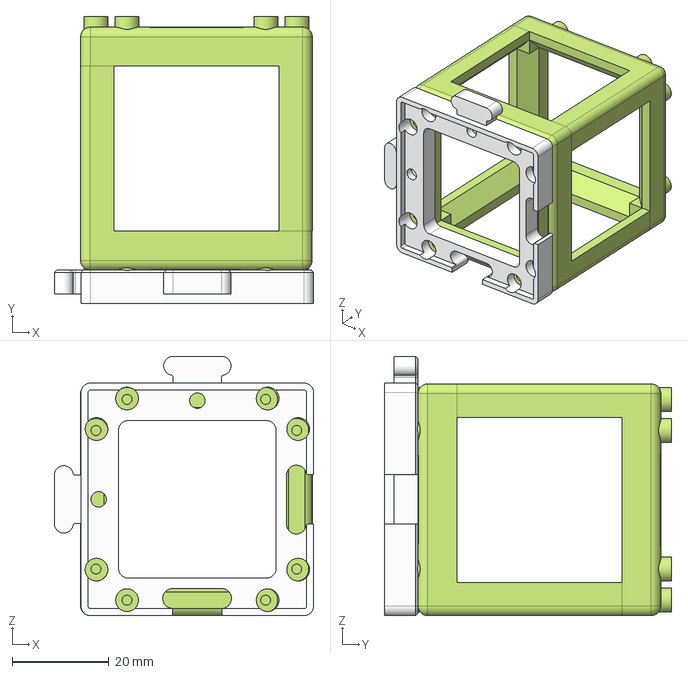
[picture p80: CAD file, 2022-11-30]
STEP/EXPERIMENT_LEGO_Assembly_Cube_empty_IM_v3.iam.step
53.5 x 59.2 x 53.5 mm
EXPERIMENT_LEGO_10_Cube_1x1_IM x 2
10_Base_puzzle_v3
