openUC2/UC2-STEP/STEP/Assembly_Cube_Eyeball_v3.iam.step

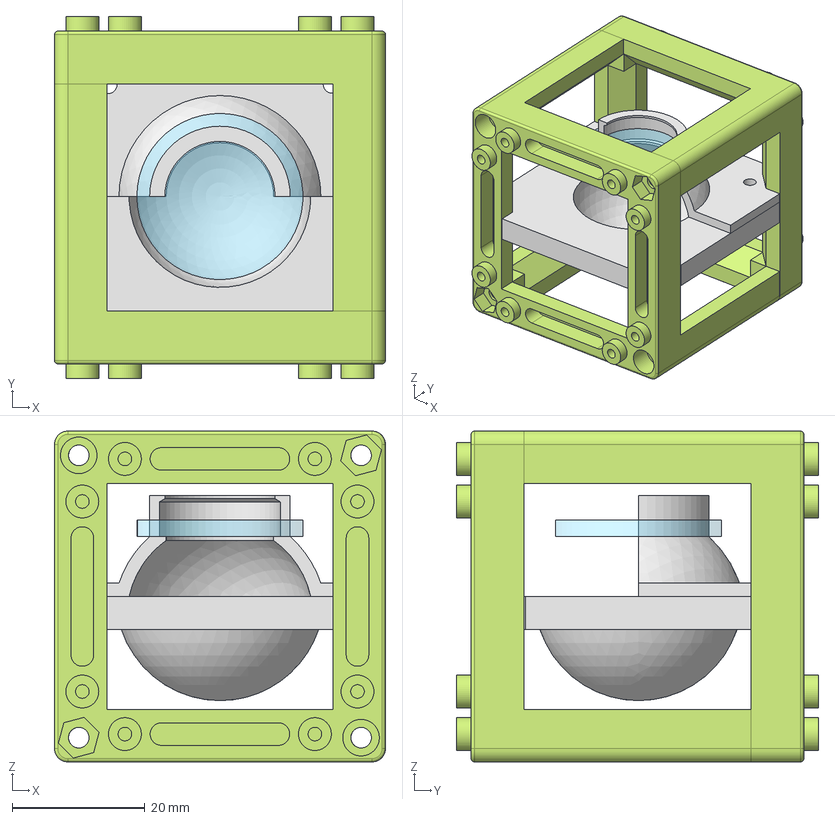
[picture p81: CAD file, 2022-11-30]
STEP/Assembly_Cube_Eyeball_v3.iam.step
49.8 x 54.5 x 49.8 mm
20_Cube_Insert_Eye_v3
20_Cube_Insert_Eye_Lens_v3
10_Cube_1x1_IM x 2
00_Lens_d21,5
