openUC2/UC2-STEP/STEP/Assembly_Cube_Lid_KES400A_Pickup.iam.step

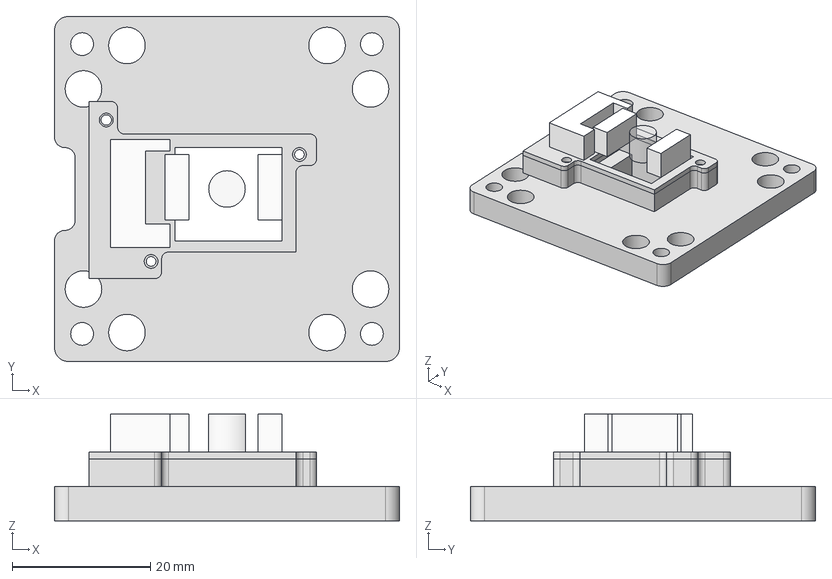
[picture p82: CAD file, 2022-11-30]
STEP/Assembly_Cube_Lid_KES400A_Pickup.iam.step
50.0 x 50.0 x 15.5 mm
30_IM_TopPlate_KES400A_holder_v3
00_KES400_Bluray_Lens
00_KES_Bluray_Magnet
00_KES400_Lens
