openUC2/UC2-STEP/STEP/Assembly_Cube_Camera_ESP32_v3.iam.step

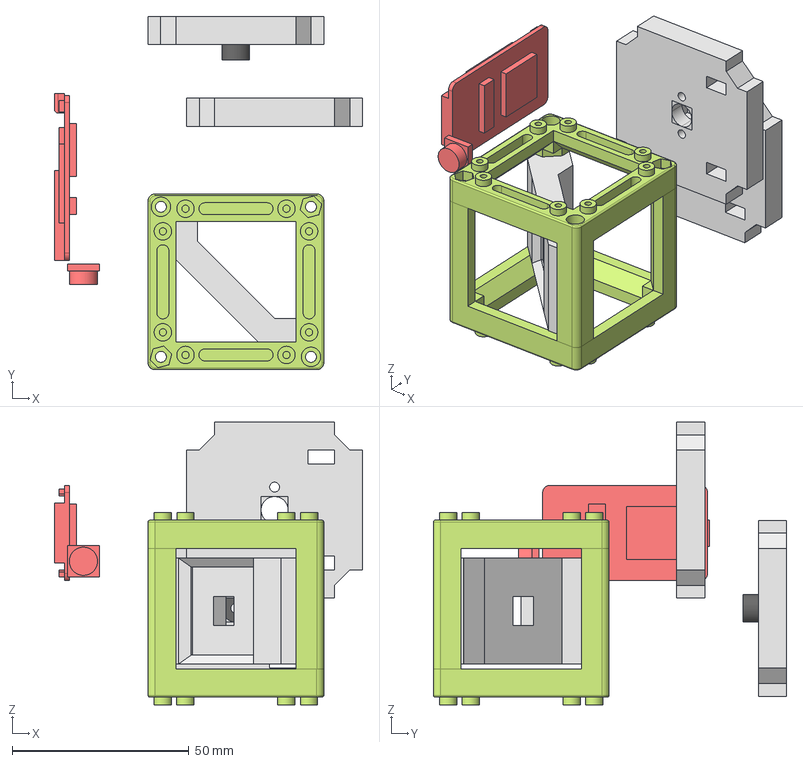
[picture p83: CAD file, 2022-11-30]
STEP/Assembly_Cube_Camera_ESP32_v3.iam.step
87.2 x 100.1 x 80.1 mm
10_Cube_1x1_IM x 2
20_Cube_Insert_Filter_25mm x 2
00_OV_lens
20_Cube_Insert_Mirror_Holder_wLogo_v3
00_ESP32_Board
