openUC2/UC2-STEP/STEP/Assembly_Joystick_PS2.iam.step

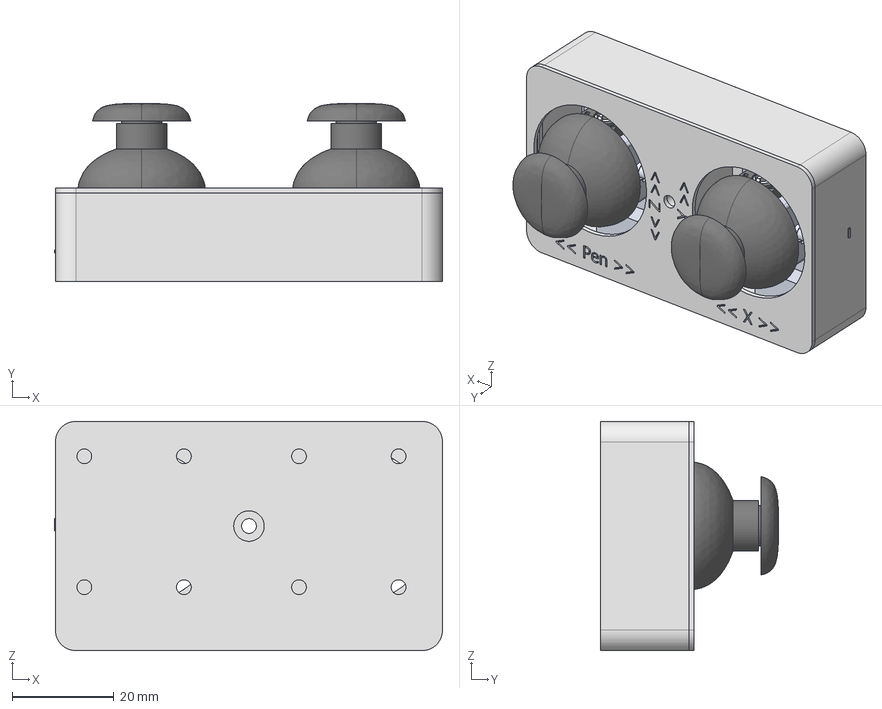
[picture p85: CAD file, 2022-11-30]
STEP/Assembly_Joystick_PS2.iam.step
76.2 x 35.0 x 45.0 mm
00_Joystick_PS2 x 2
40_Joystick_PS2_Base
40_Joystick_PS2_Lid
