openUC2/UC2-STEP/STEP/Assembly_Cube_Z_Focus_Drylin_manual_v3.iam.step

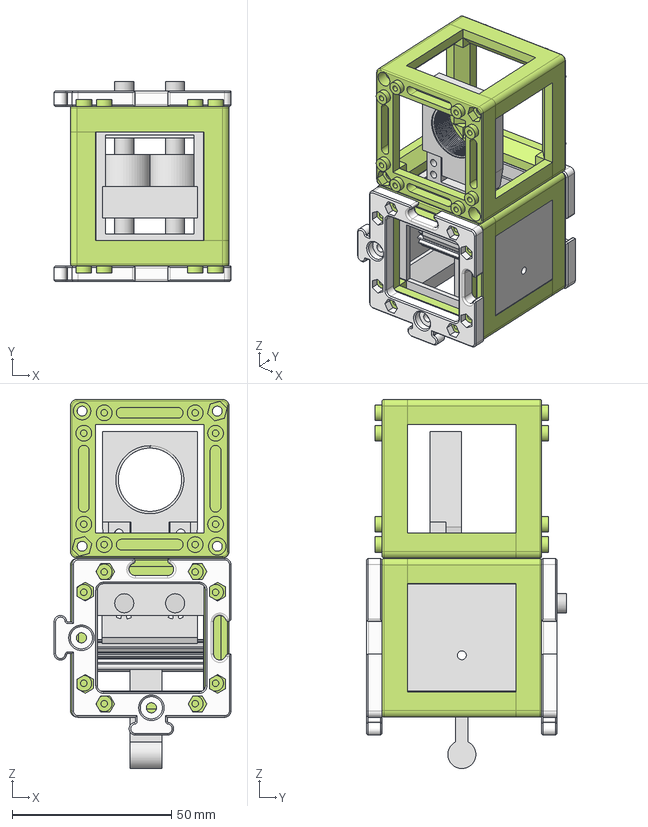
[picture p86: CAD file, 2022-11-30]
STEP/Assembly_Cube_Z_Focus_Drylin_manual_v3.iam.step
55.6 x 63.0 x 116.0 mm
30_Cube_Z_Focus_MGN_NEMA_adapter_RMS
00_rod_6mm x 2
10_Base_puzzle_v3 x 2
30_Cube_Z_Focus_Drylin_manual_base_v3
10_Cube_1x1_IM x 6
30_Cube_Z_Focus_MGN12_manual_gear_v3
30_Cube_Z_Focus_MGN12_NEMA_slide_part2
