openUC2/UC2-STEP/STEP/Assembly_Insert_Kinematic_Mirrormount_45_base.iam.step

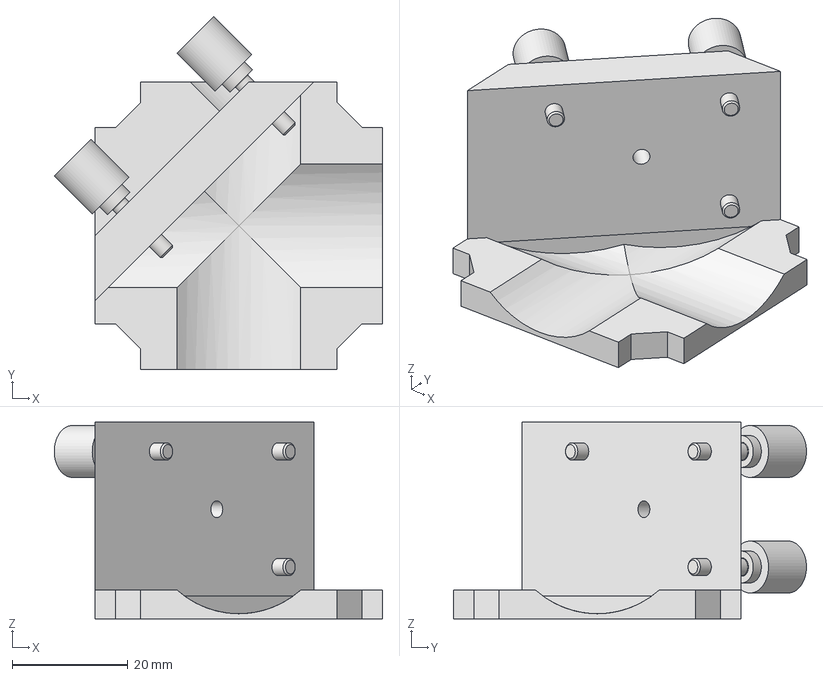
[picture p87: CAD file, 2022-11-30]
STEP/Assembly_Insert_Kinematic_Mirrormount_45_base.iam.step
56.9 x 61.1 x 34.1 mm
20_Cube_Insert_Kinematic_Mirrormount_45_base_part1
20_Cube_Insert_Kinematic_Mirrormount_45_base_part2
30_Adapter_M3_nut x 3
DIN 912 - M3 x 12 x 3
