openUC2/UC2-STEP/STEP/Assembly_Cube_SyringePump_Nema8_Cartridge.iam.step

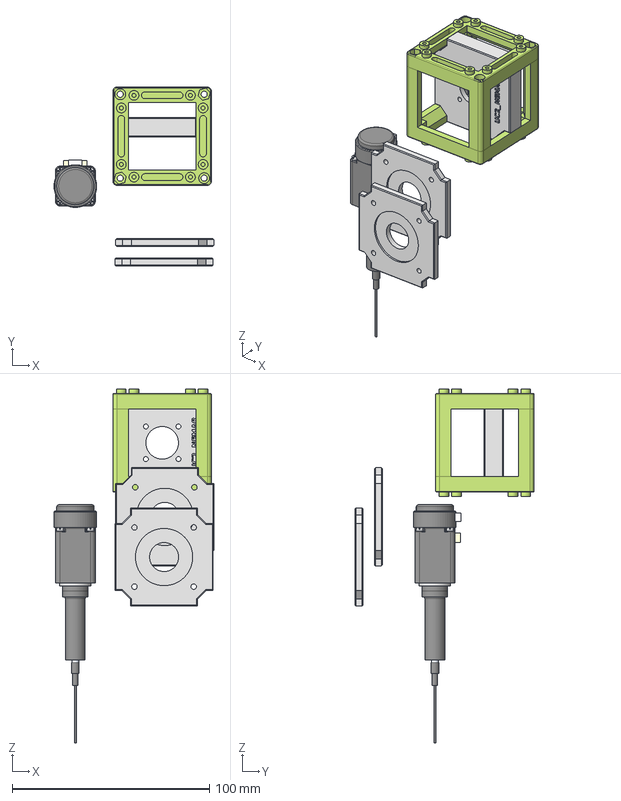
[picture p88: CAD file, 2022-11-30]
STEP/Assembly_Cube_SyringePump_Nema8_Cartridge.iam.step
81.0 x 90.6 x 179.3 mm
10_Cube_1x1_IM x 2
20_Cube_Insert_Nema8_Holder_Center_v3
20_Cube_Insert_Syringe_Cardridge_Holder_center x 2
00_Joy-IT-B20SHD4353_NEMA8_captive
