openUC2/UC2-STEP/STEP/Assembly_Cube_Servomotor_G90_v3.iam.step

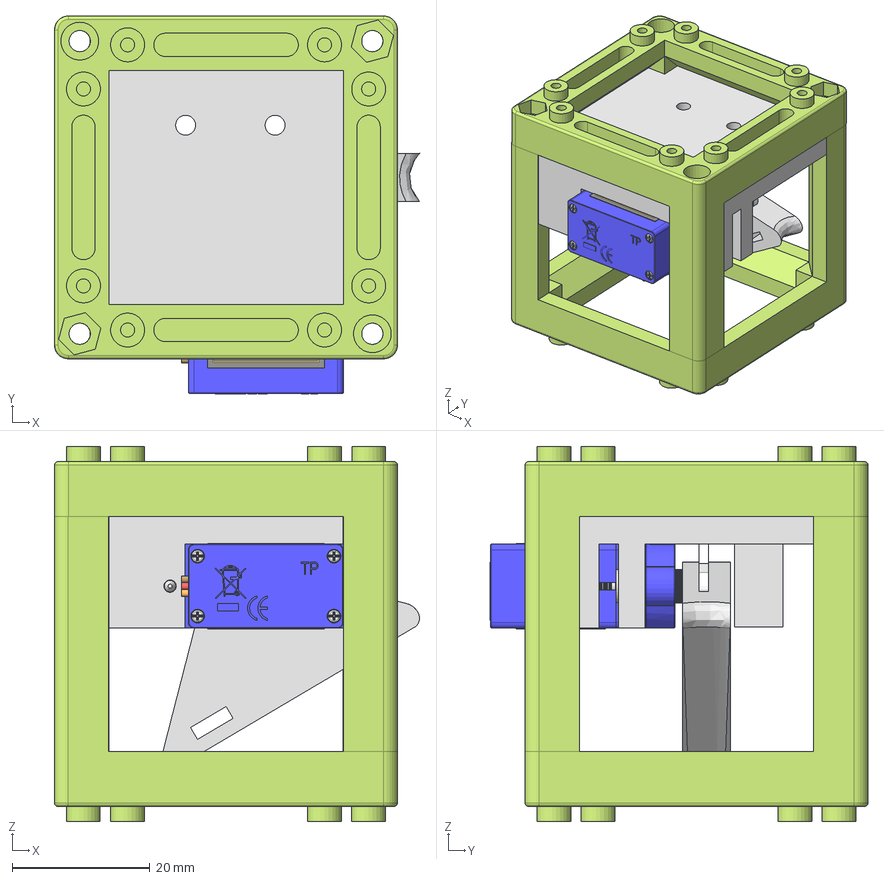
[picture p89: CAD file, 2022-11-30]
STEP/Assembly_Cube_Servomotor_G90_v3.iam.step
53.0 x 54.9 x 54.5 mm
10_Cube_1x1_IM x 2
20_Cube_Insert_RaspiCam_v3
00_Servomotor_SG90
00_penholder_servomotor
