openUC2/UC2-STEP/STEP/Assembly_Cube_Mirror_Stairs_v3.iam.step

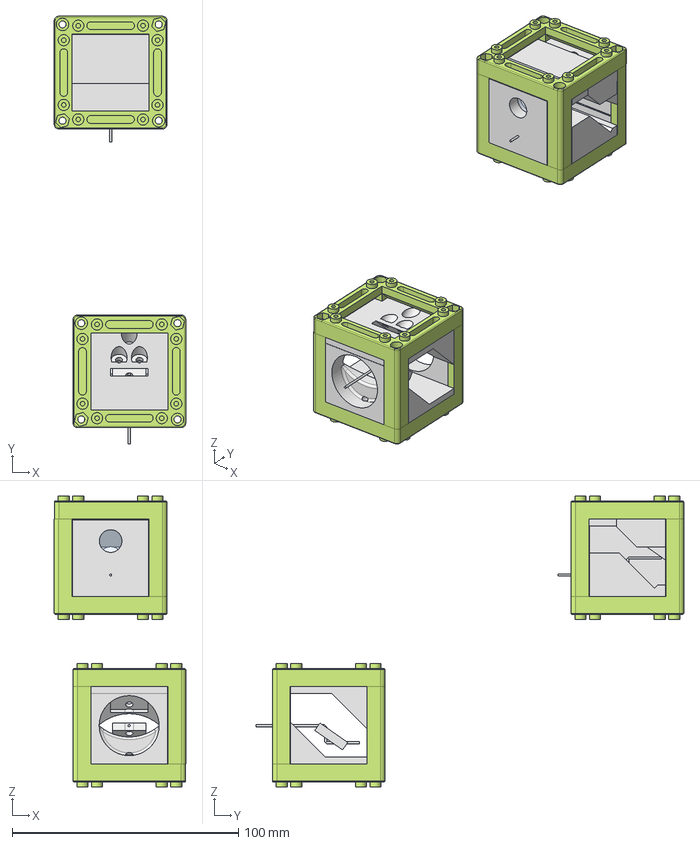
[picture p90: CAD file, 2022-11-30]
STEP/Assembly_Cube_Mirror_Stairs_v3.iam.step
58.1 x 188.9 x 128.5 mm
10_Cube_1x1_IM x 4
20_Cube_Insert_Beamsplittercube_Base_25x35_v3
00_Comar_Filter_25Dia
00_Beam_Stairs_7.5mm x 2
20_Cube_Insert_Mirror_Stairs_variable_v3 x 2
20_Cube_Insert_Mirror_Stairs_fixed_v3 x 2
20_Cube_Insert_Mirror_Stairs_fixed_varspacer1_v3
