openUC2/UC2-STEP/STEP/Assembly_Cube_LED_Matrix_8x8_v3.iam.step

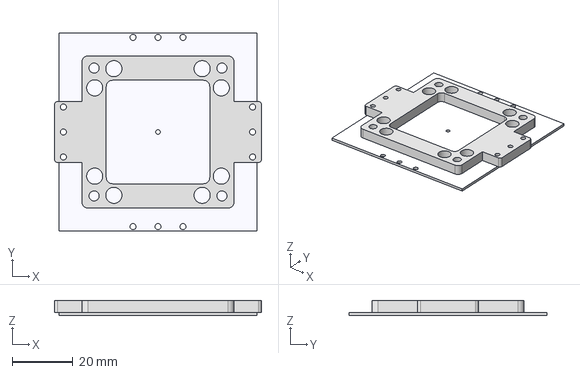
[picture p91: CAD file, 2022-11-30]
STEP/Assembly_Cube_LED_Matrix_8x8_v3.iam.step
68.0 x 65.0 x 5.00 mm
20_IM_LED_holder
00_LED-ARRAY
