openUC2/UC2-STEP/STEP/Assembly_Cube_despeckler_v3.iam.step

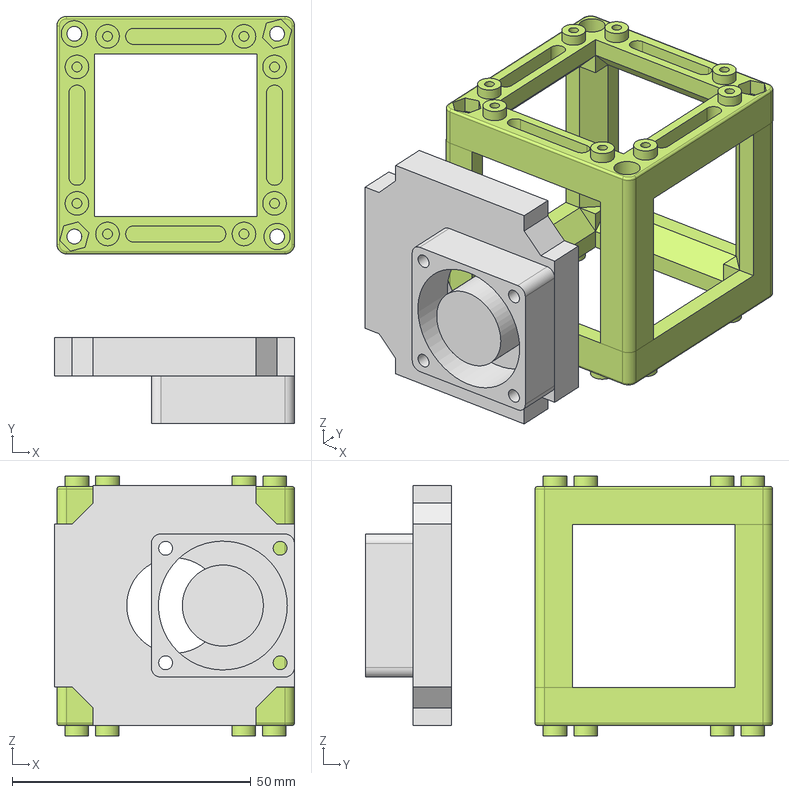
[picture p92: CAD file, 2022-11-30]
STEP/Assembly_Cube_despeckler_v3.iam.step
50.3 x 85.4 x 54.5 mm
10_Cube_1x1_IM x 2
20_IM_Cube_Insert_Lens_holder_RMS_63x
00_fan_30mm_24mm
