openUC2/UC2-STEP/STEP/Assembly_Cube_Objective_Holder_v3.iam.step

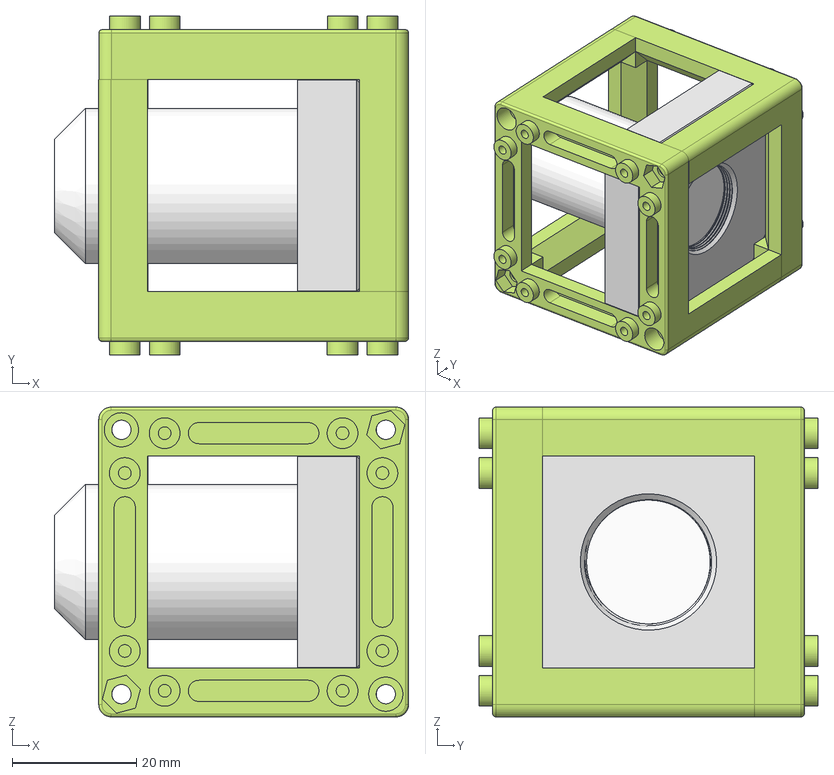
[picture p93: CAD file, 2022-11-30]
STEP/Assembly_Cube_Objective_Holder_v3.iam.step
57.0 x 54.5 x 49.8 mm
00_Microscope_Objective_Lens10x
10_Cube_1x1_IM x 2
20_Cube_Insert_RMS
