openUC2/UC2-STEP/STEP/Assembly_Cube_Sidewall_v3.iam.step

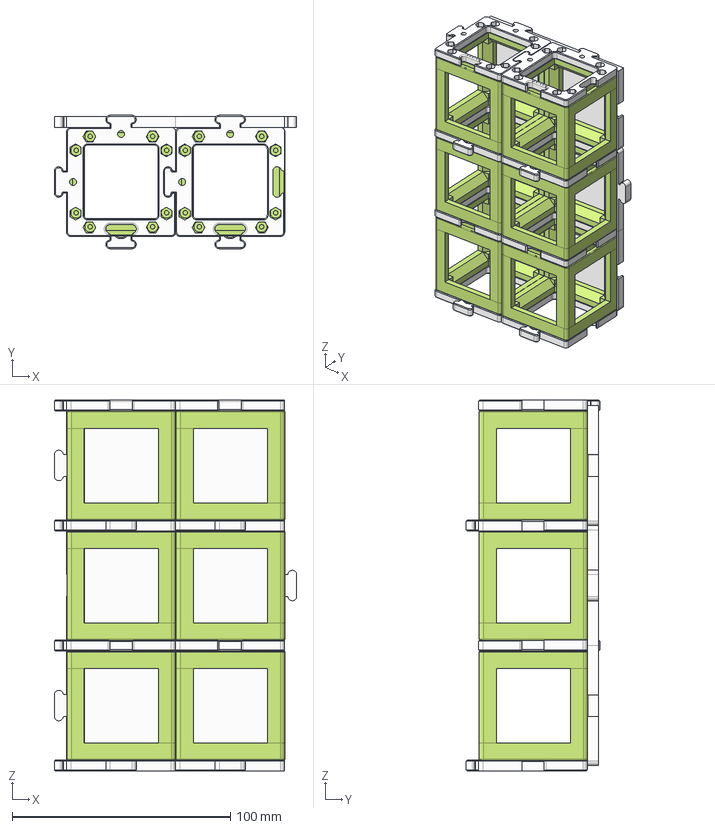
[picture p94: CAD file, 2022-11-30]
STEP/Assembly_Cube_Sidewall_v3.iam.step
111.1 x 61.2 x 170.0 mm
10_Base_puzzle_sideplate_v3 x 6
10_Cube_1x1_IM x 12
10_Base_puzzle_v3 x 8
