openUC2/UC2-STEP/STEP/Assembly_Cube_Flexuremanipulator_zonly_v3.iam.step

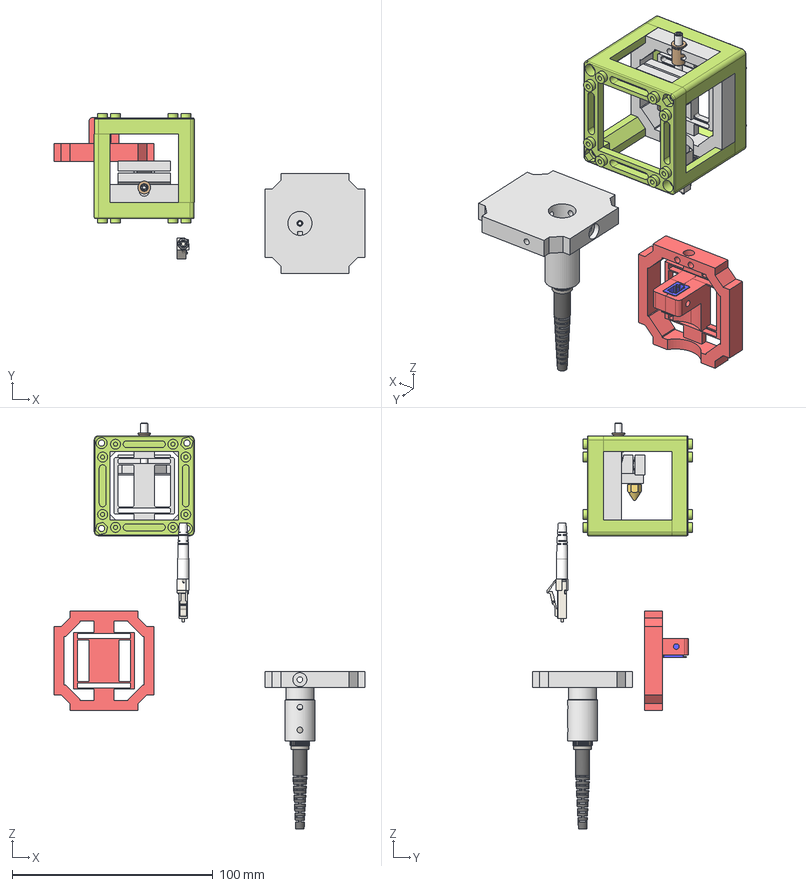
[picture p95: CAD file, 2022-11-30]
STEP/Assembly_Cube_Flexuremanipulator_zonly_v3.iam.step
154.9 x 79.6 x 202.2 mm
00_F6SS088-Step
00_F6SSN2P-Step
10_Cube_1x1_IM x 2
20_Cube_Inser_Flexuremanipulator_zonly_translation_v3
00_mk8_nozzle_0.4STEP
20_Cube_Insert_Felxuremanipulator_zonly_fiberlid
20_Cube_Inser_Flexuremanipulator_ST_connector_zonly_v3
00_SM05LC-Step
00_LC_Duplex_Fiber_Connector
20_Cube_Insert_Filter_25mm
00_PM20-ST-Step
00_10127C-Step
