openUC2/UC2-STEP/STEP/Assembly_base_4x4.iam.step

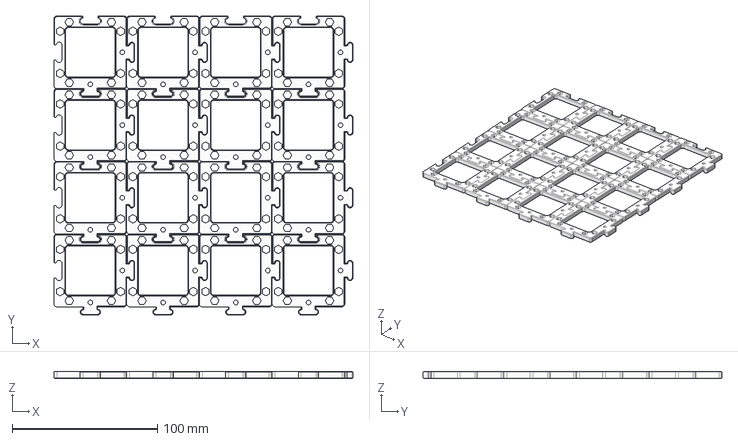
[picture p96: CAD file, 2022-11-30]
STEP/Assembly_base_4x4.iam.step
205.6 x 205.6 x 5.00 mm
10_Base_puzzle_v3 x 16
