openUC2/UC2-STEP/STEP/00_CXY1-Step.ipt.step

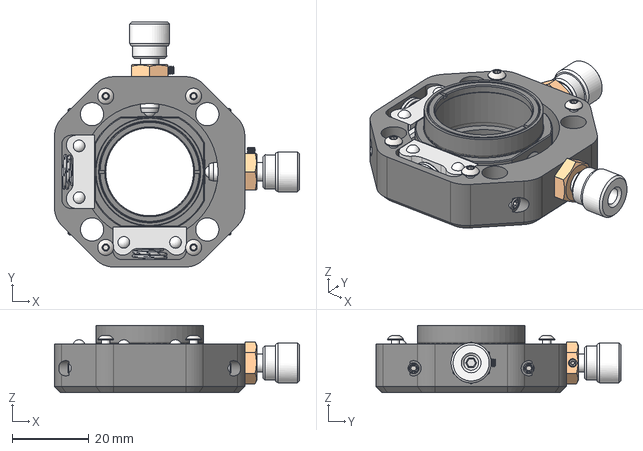
[picture p98: CAD file, 2022-11-30]
STEP/00_CXY1-Step.ipt.step
63.8 x 63.8 x 17.5 mm
