openUC2/UC2-STEP/STEP/00_coverslip_22mm_round_adapter.ipt.step

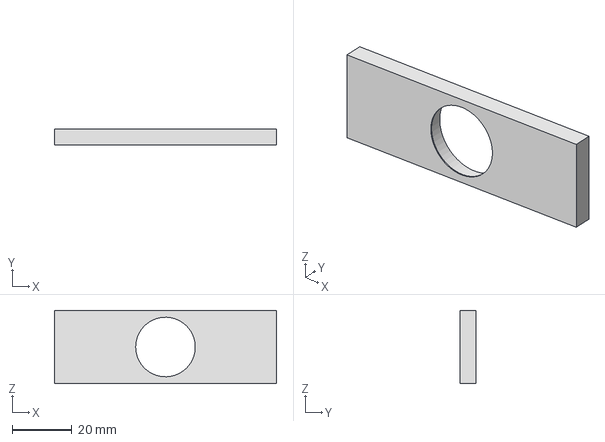
[picture p99: CAD file, 2022-11-30]
STEP/00_coverslip_22mm_round_adapter.ipt.step
74.5 x 5.30 x 24.5 mm
