openUC2/UC2-STEP/STEP/00_XYTable_china_75_55mm.ipt.step

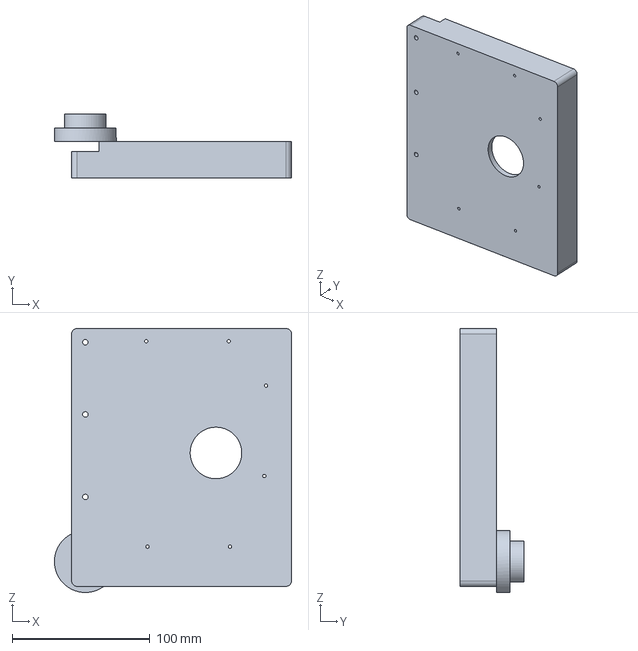
[picture p100: CAD file, 2022-11-30]
STEP/00_XYTable_china_75_55mm.ipt.step
172.5 x 46.5 x 192.0 mm
