openUC2/UC2-STEP/STEP/20_Cube_Insert_Kinematic_Mirror_45_pro_v3.ipt.step

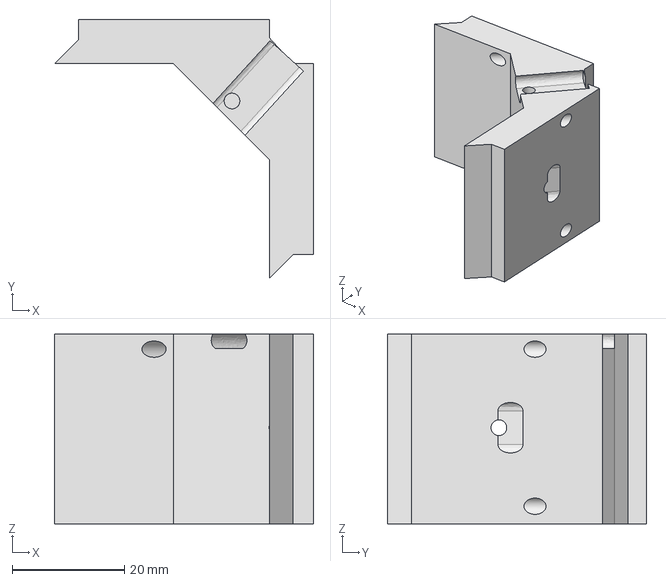
[picture p101: CAD file, 2022-11-30]
STEP/20_Cube_Insert_Kinematic_Mirror_45_pro_v3.ipt.step
46.2 x 46.2 x 33.8 mm
