openUC2/UC2-STEP/STEP/30_Linear_Stage_NEMA11_China_base_universal_v2.ipt.step

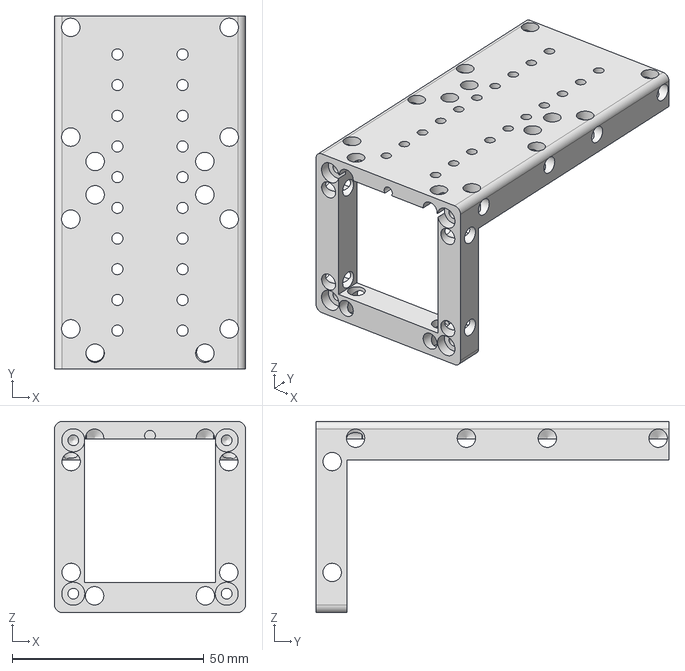
[picture p102: CAD file, 2022-11-30]
STEP/30_Linear_Stage_NEMA11_China_base_universal_v2.ipt.step
49.8 x 92.0 x 49.8 mm
