openUC2/UC2-STEP/STEP/20_Cube_Insert_Cube_Z-Stage_NEMA11_china_v3.ipt.step

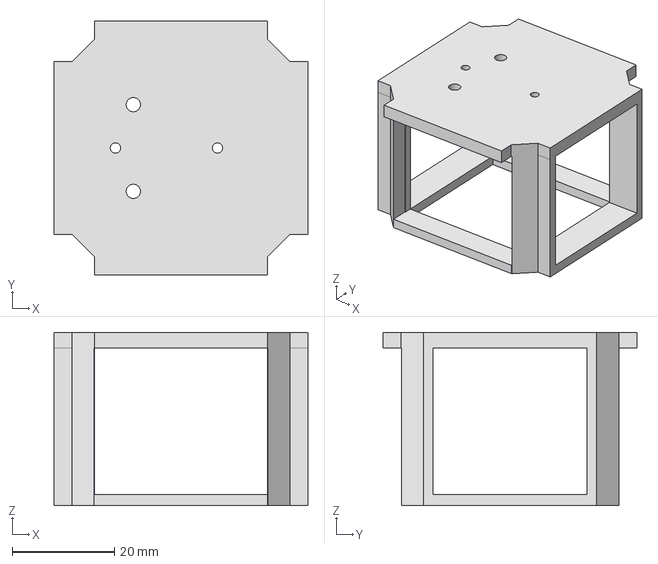
[picture p103: CAD file, 2022-11-30]
STEP/20_Cube_Insert_Cube_Z-Stage_NEMA11_china_v3.ipt.step
49.8 x 49.8 x 34.0 mm
