openUC2/UC2-STEP/STEP/00_Heidstar_XYStage.ipt.step

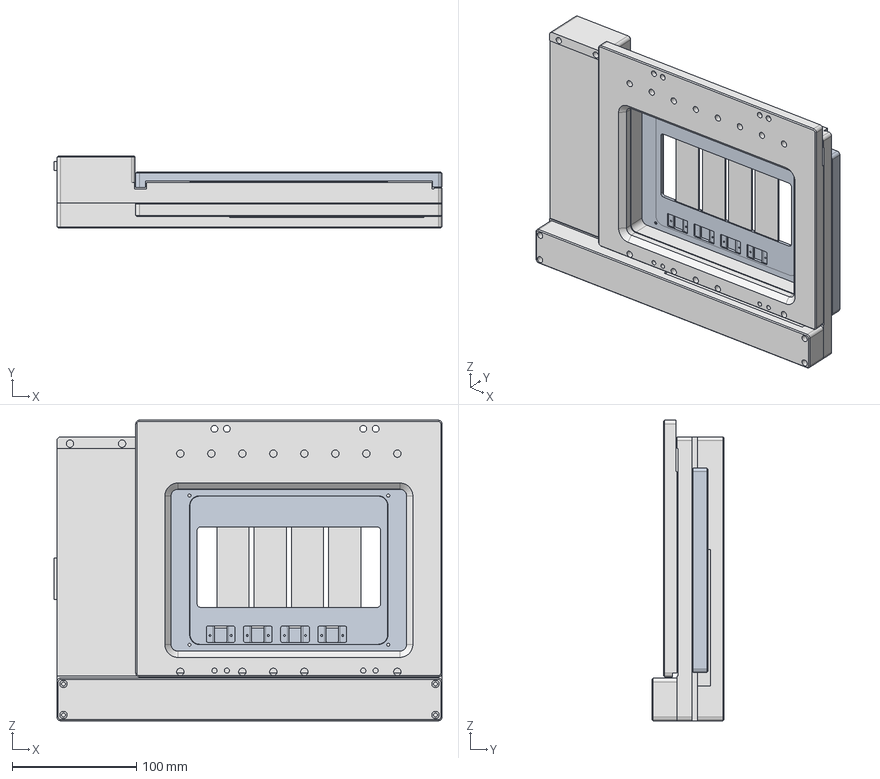
[picture p104: CAD file, 2022-11-30]
STEP/00_Heidstar_XYStage.ipt.step
312.9 x 58.4 x 242.5 mm
