openUC2/UC2-STEP/STEP/00_XY_Manipulator.ipt.step

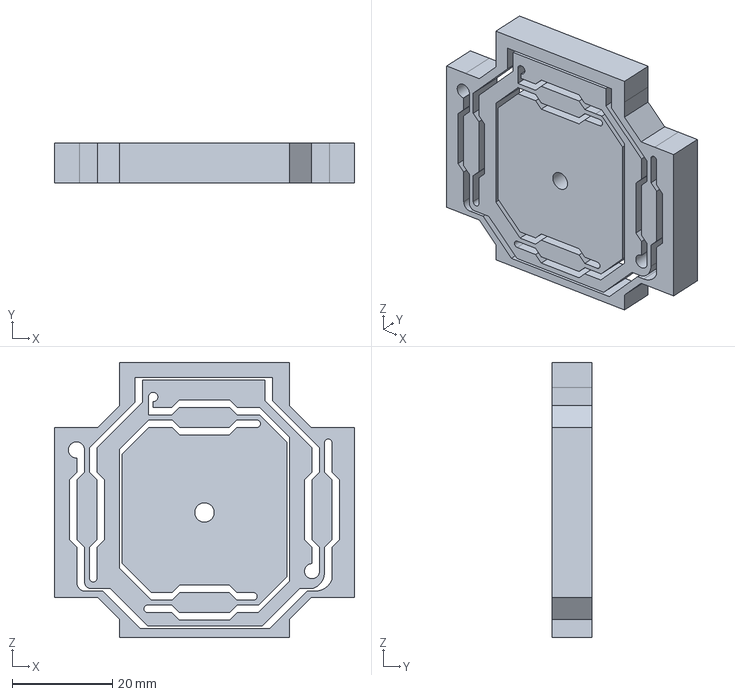
[picture p105: CAD file, 2022-11-30]
STEP/00_XY_Manipulator.ipt.step
60.0 x 8.00 x 55.0 mm
