openUC2/UC2-STEP/STEP/20_Cube_Insert_Beamsplittercube_motorized_cube_LID.ipt.step

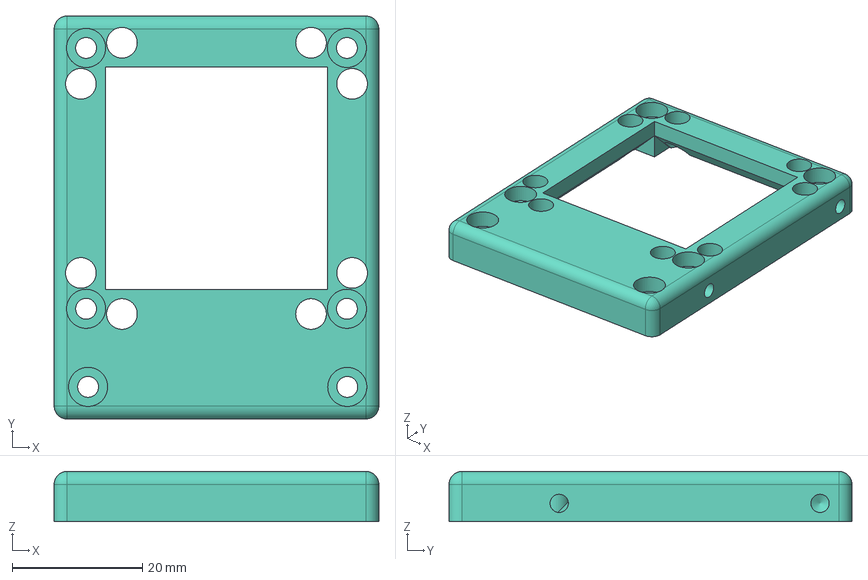
[picture p106: CAD file, 2022-11-30]
STEP/20_Cube_Insert_Beamsplittercube_motorized_cube_LID.ipt.step
49.8 x 61.8 x 7.70 mm
