openUC2/UC2-STEP/STEP/30_Cube_Adapter_Heidstar_Holecover.ipt.step

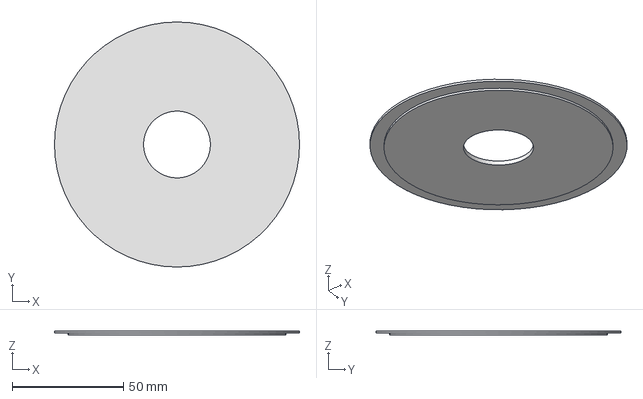
[picture p107: CAD file, 2022-11-30]
STEP/30_Cube_Adapter_Heidstar_Holecover.ipt.step
110.0 x 110.0 x 2.00 mm
