openUC2/UC2-STEP/STEP/20_Cube_Insert_focusing_gear_v3.ipt.step

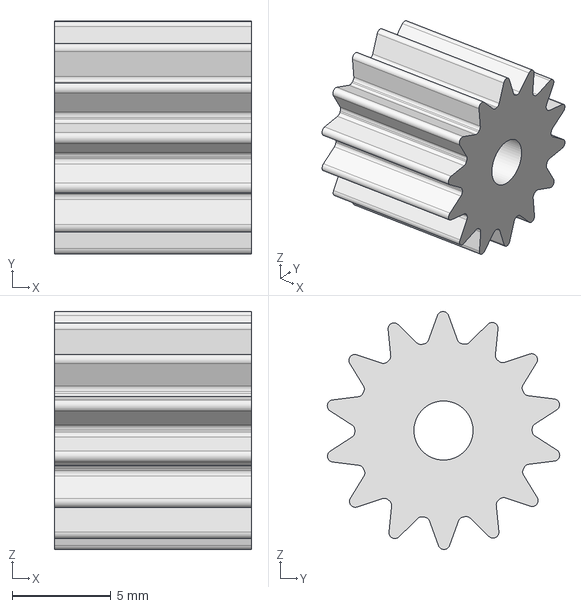
[picture p108: CAD file, 2022-11-30]
STEP/20_Cube_Insert_focusing_gear_v3.ipt.step
10.0 x 11.8 x 12.1 mm
