openUC2/UC2-STEP/STEP/20_Cube_Insert_Mirror_Stairs_fixed_varspacer2_v3.ipt.step

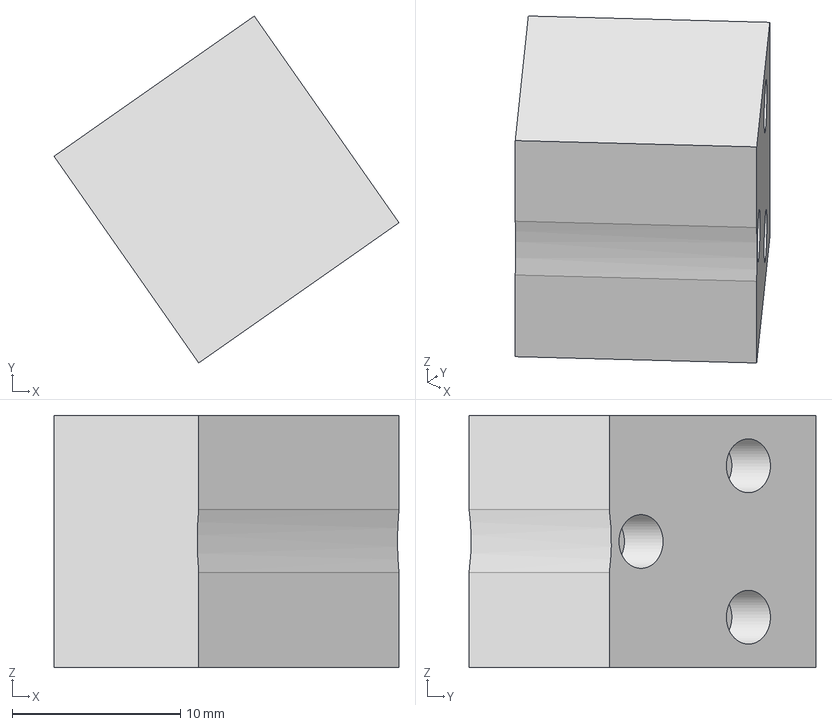
[picture p109: CAD file, 2022-11-30]
STEP/20_Cube_Insert_Mirror_Stairs_fixed_varspacer2_v3.ipt.step
20.5 x 20.6 x 15.0 mm
