openUC2/UC2-STEP/STEP/20_Cube_Insert_Lightsheet_FEPTube_Rotating_gear2_v0.ipt.step

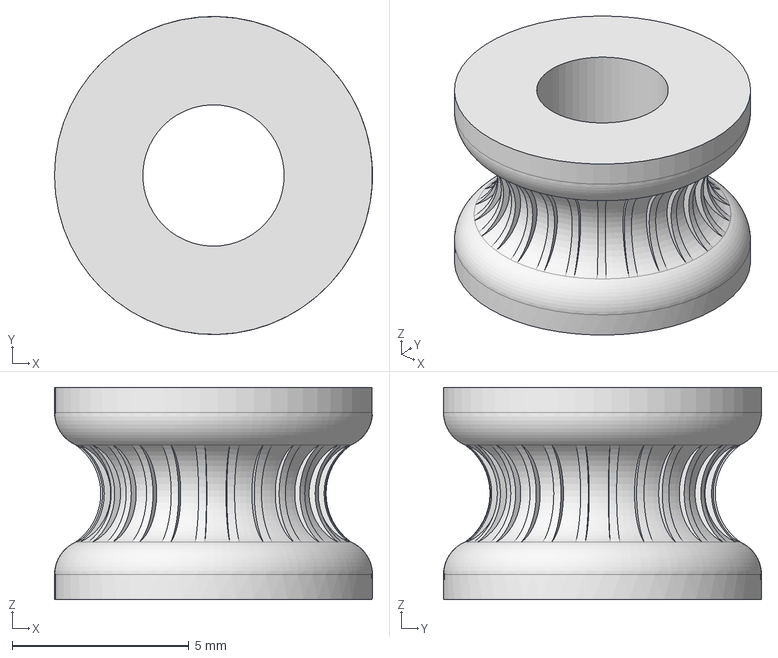
[picture p110: CAD file, 2022-11-30]
STEP/20_Cube_Insert_Lightsheet_FEPTube_Rotating_gear2_v0.ipt.step
9.00 x 9.00 x 6.00 mm
