openUC2/UC2-STEP/STEP/EXPERIMENT_LEGO_10_Cube_1x1_IM.ipt.step

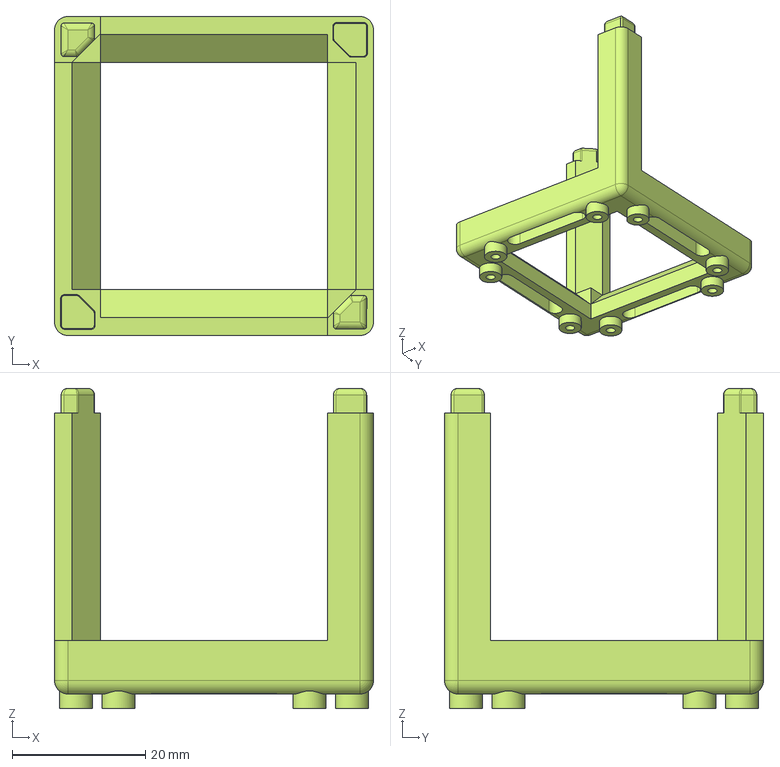
[picture p111: CAD file, 2022-11-30]
STEP/EXPERIMENT_LEGO_10_Cube_1x1_IM.ipt.step
47.8 x 47.8 x 48.0 mm
