openUC2/UC2-STEP/STEP/00_F6SS088-Step.ipt.step

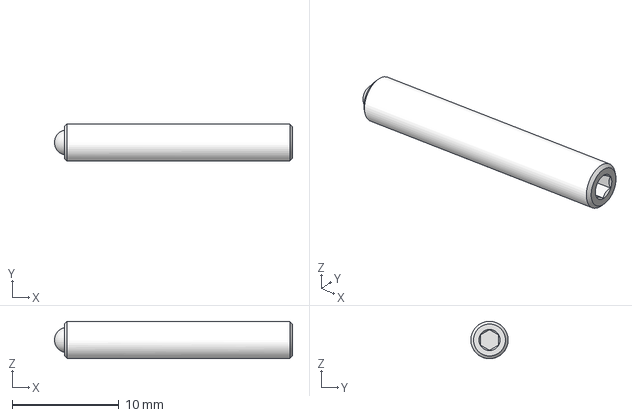
[picture p112: CAD file, 2022-11-30]
STEP/00_F6SS088-Step.ipt.step
22.3 x 3.51 x 3.51 mm
