openUC2/UC2-STEP/STEP/00_Cuvette_3ml_10mm.ipt.step

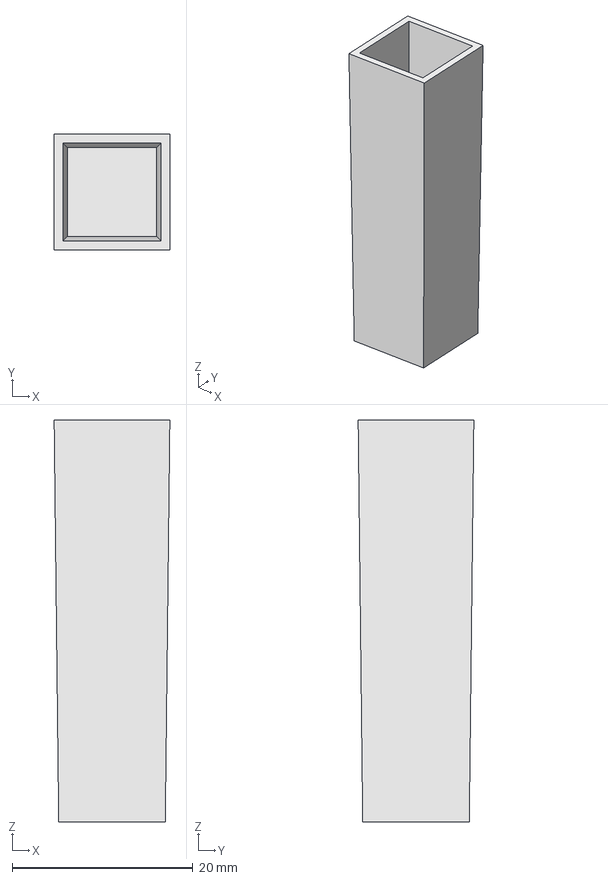
[picture p113: CAD file, 2022-11-30]
STEP/00_Cuvette_3ml_10mm.ipt.step
12.8 x 12.8 x 44.5 mm
