openUC2/UC2-STEP/STEP/20_Cube_Insert_Template_straightened_levelarm_v3.ipt.step

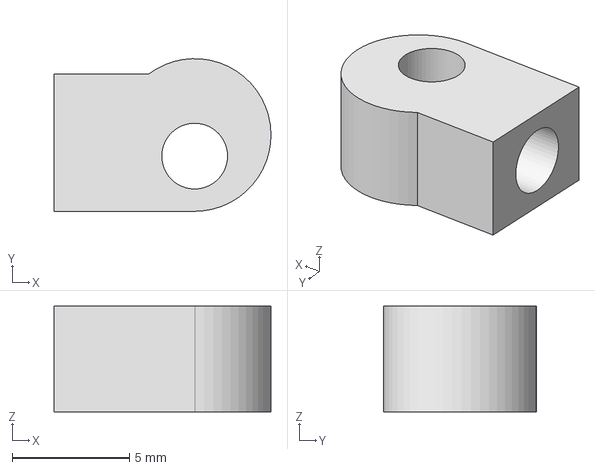
[picture p114: CAD file, 2022-11-30]
STEP/20_Cube_Insert_Template_straightened_levelarm_v3.ipt.step
9.24 x 6.50 x 4.50 mm
