openUC2/UC2-STEP/STEP/20_Cube_Insert_Objective_Holder_v3.ipt.step

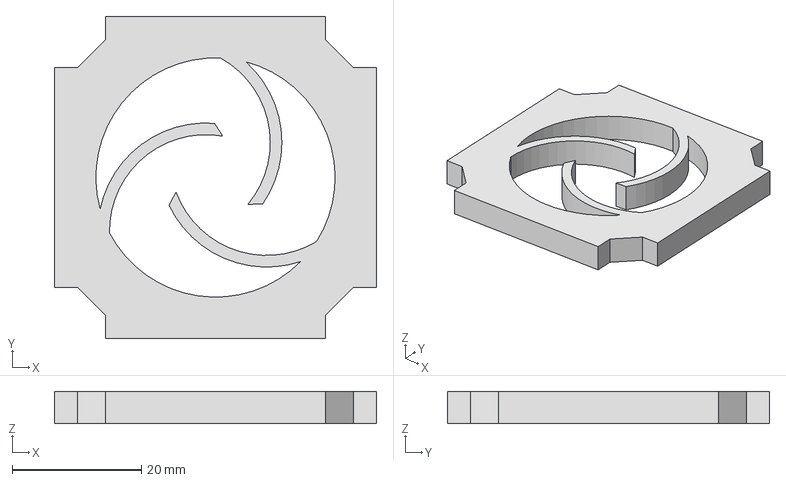
[picture p115: CAD file, 2022-11-30]
STEP/20_Cube_Insert_Objective_Holder_v3.ipt.step
49.8 x 49.8 x 5.00 mm
