openUC2/UC2-STEP/STEP/30_Cube_Syringepump_90mm_linearmotor_base_1mlAdapter_V3.ipt.step

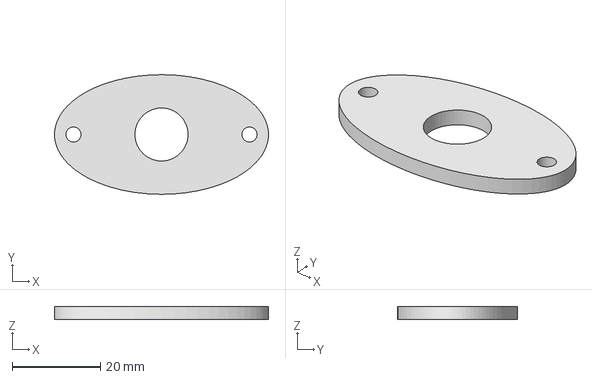
[picture p116: CAD file, 2022-11-30]
STEP/30_Cube_Syringepump_90mm_linearmotor_base_1mlAdapter_V3.ipt.step
48.4 x 27.1 x 3.00 mm
