openUC2/UC2-STEP/STEP/30_XYTabel_Aliexpress_cellSTORM_lasermount.ipt.step

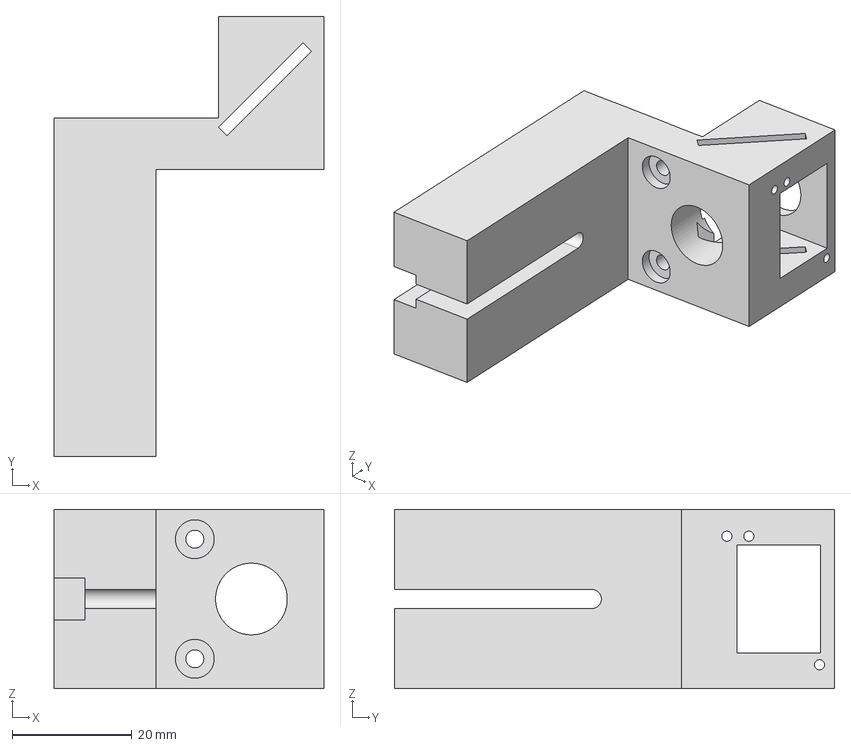
[picture p117: CAD file, 2022-11-30]
STEP/30_XYTabel_Aliexpress_cellSTORM_lasermount.ipt.step
45.2 x 73.6 x 30.0 mm
