openUC2/UC2-STEP/STEP/00_fan_30mm_24mm.ipt.step

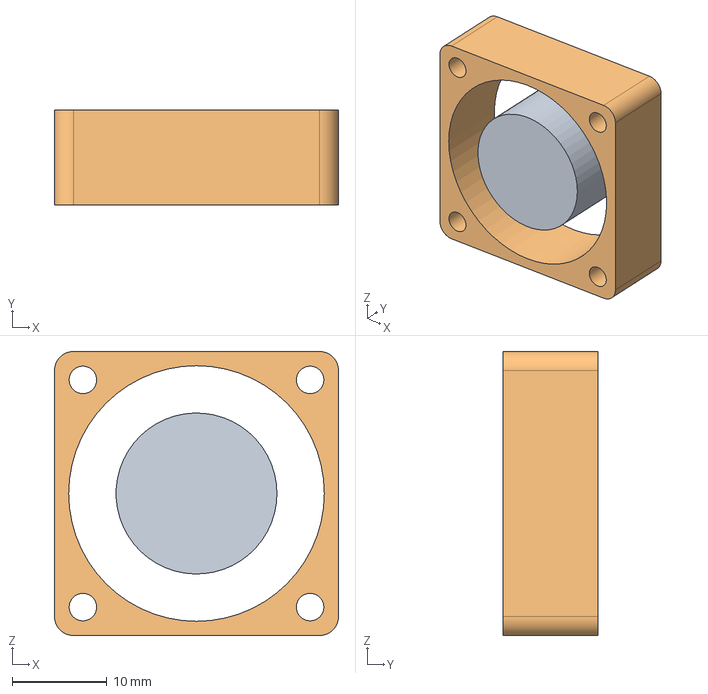
[picture p118: CAD file, 2022-11-30]
STEP/00_fan_30mm_24mm.ipt.step
30.0 x 10.0 x 30.0 mm
