openUC2/UC2-STEP/STEP/30_Cube_Insert_Filter_Revolver_Lid.ipt.step

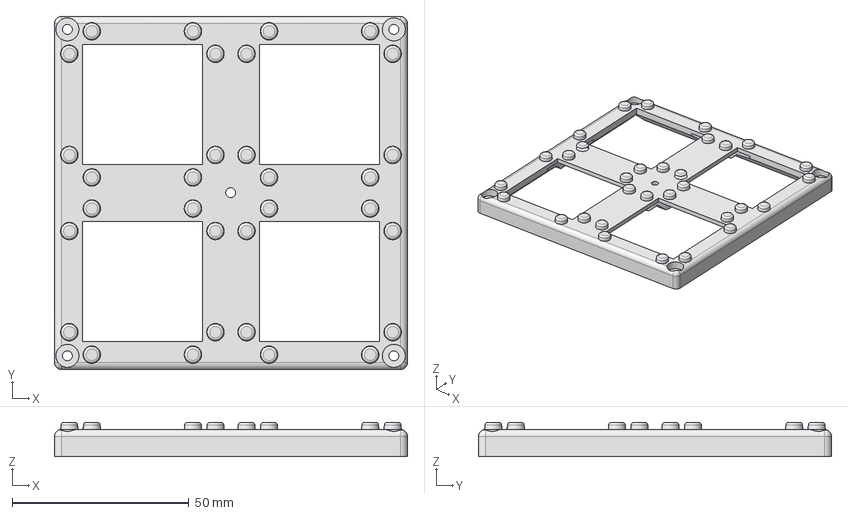
[picture p119: CAD file, 2022-11-30]
STEP/30_Cube_Insert_Filter_Revolver_Lid.ipt.step
99.8 x 99.8 x 9.70 mm
