openUC2/UC2-STEP/STEP/Pusa.ipt.step

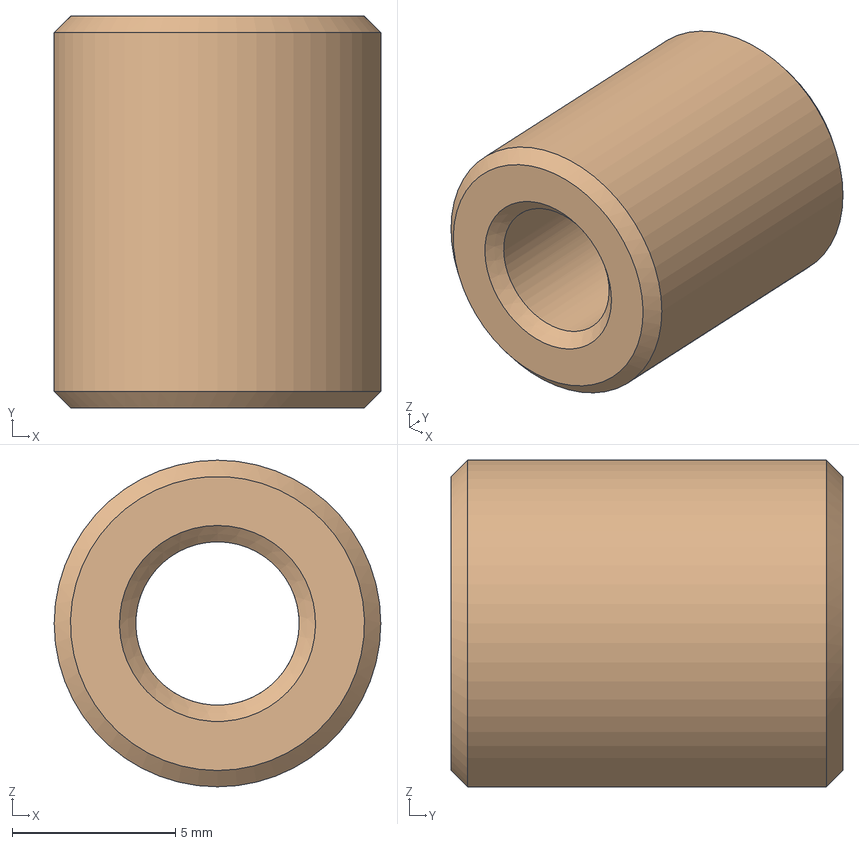
[picture p120: CAD file, 2022-11-30]
STEP/Pusa.ipt.step
10.0 x 12.0 x 10.0 mm
