openUC2/UC2-STEP/STEP/20_CUBE_Insert_NeoMatrix_4x4.ipt.step

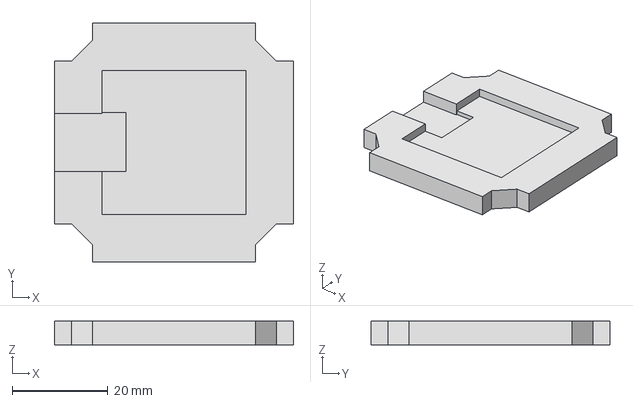
[picture p121: CAD file, 2022-11-30]
STEP/20_CUBE_Insert_NeoMatrix_4x4.ipt.step
49.8 x 49.8 x 5.00 mm
