openUC2/UC2-STEP/STEP/30_cellSTORM_UC2_motorized_xystage_spacer.ipt.step

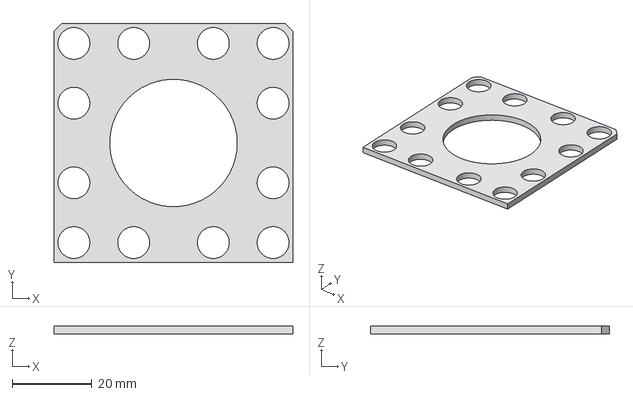
[picture p122: CAD file, 2022-11-30]
STEP/30_cellSTORM_UC2_motorized_xystage_spacer.ipt.step
60.0 x 60.0 x 2.00 mm
