openUC2/UC2-STEP/STEP/00_SM05LC-toRMS.ipt.step

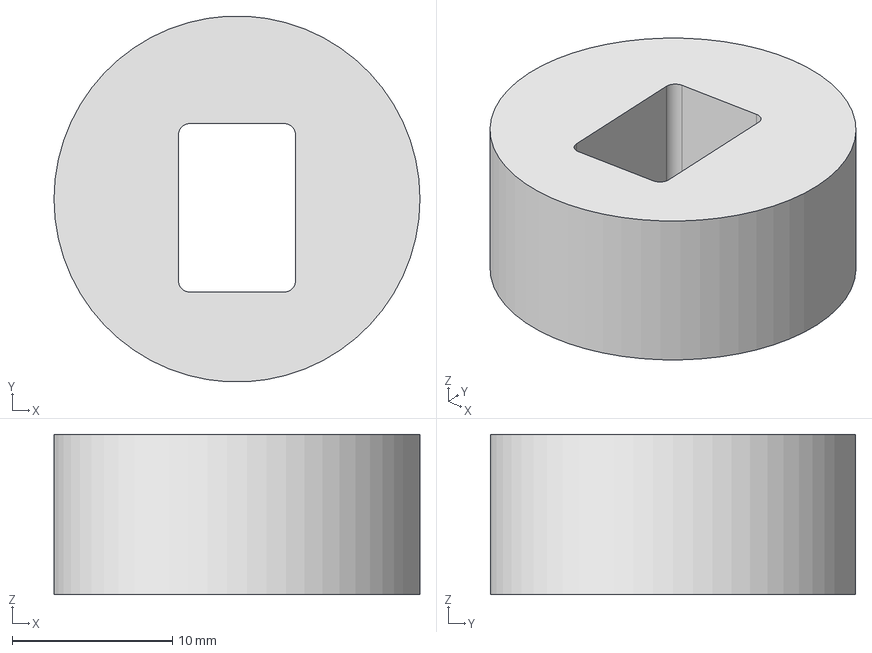
[picture p123: CAD file, 2022-11-30]
STEP/00_SM05LC-toRMS.ipt.step
22.8 x 22.8 x 10.0 mm
