openUC2/UC2-STEP/STEP/30_cellSTORM_base.ipt.step

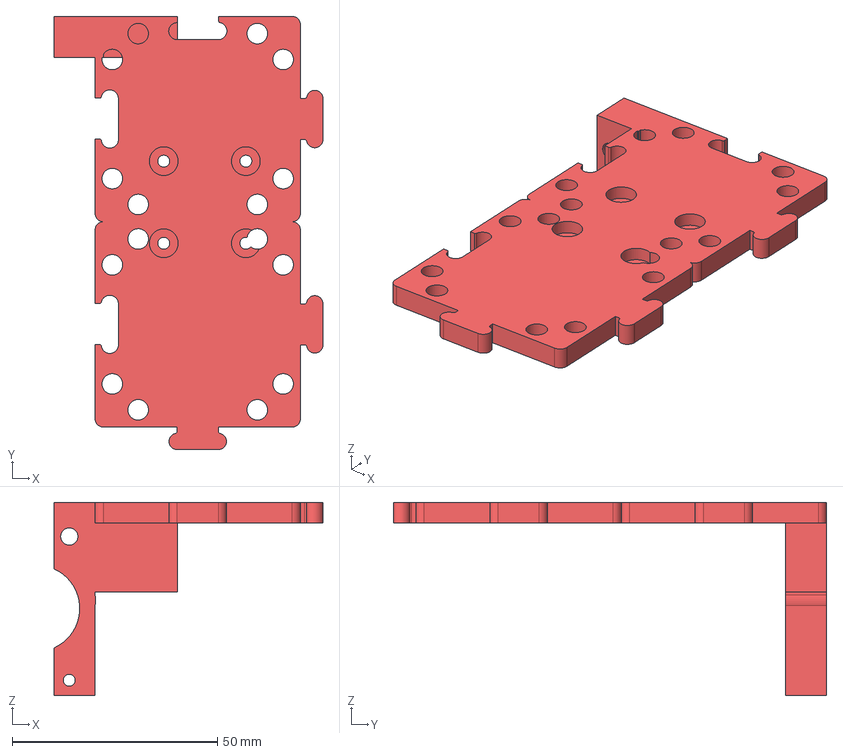
[picture p124: CAD file, 2022-11-30]
STEP/30_cellSTORM_base.ipt.step
65.5 x 105.5 x 47.0 mm
