openUC2/UC2-STEP/STEP/30_Cube_Adapter_Heidstar_IlluminationArm.ipt.step

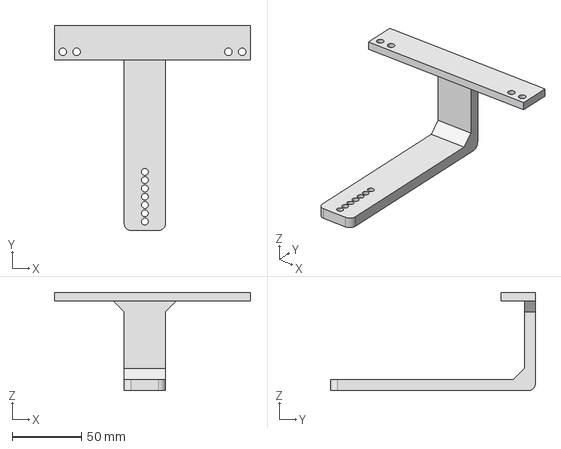
[picture p125: CAD file, 2022-11-30]
STEP/30_Cube_Adapter_Heidstar_IlluminationArm.ipt.step
142.0 x 148.4 x 71.0 mm
