openUC2/UC2-STEP/STEP/30_Cube_Syringepump_90mm_linearmotor_pusher_part2_V3.ipt.step

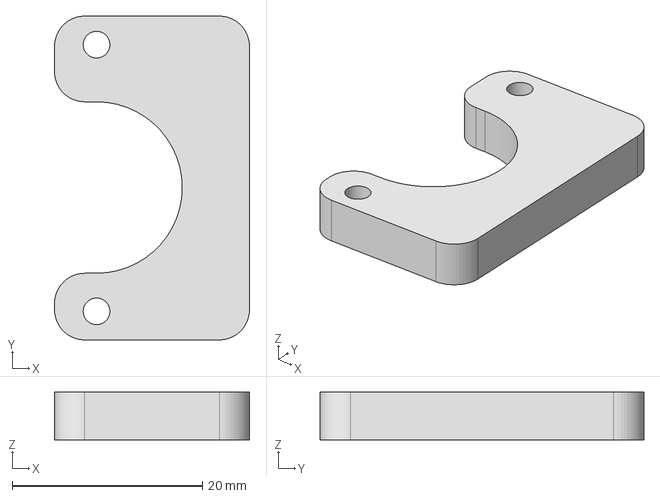
[picture p126: CAD file, 2022-11-30]
STEP/30_Cube_Syringepump_90mm_linearmotor_pusher_part2_V3.ipt.step
20.5 x 34.0 x 5.00 mm
