openUC2/UC2-STEP/STEP/30_Z_Stage_Adapterplate.ipt.step

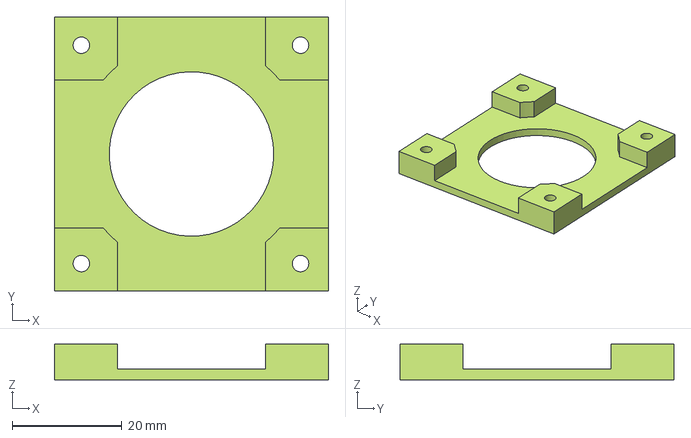
[picture p127: CAD file, 2022-11-30]
STEP/30_Z_Stage_Adapterplate.ipt.step
50.0 x 50.0 x 6.50 mm
