openUC2/UC2-STEP/STEP/20_Cube_Insert_Lens_Cylindrical_Plexiglas_glassslab_longF_v3.ipt.step

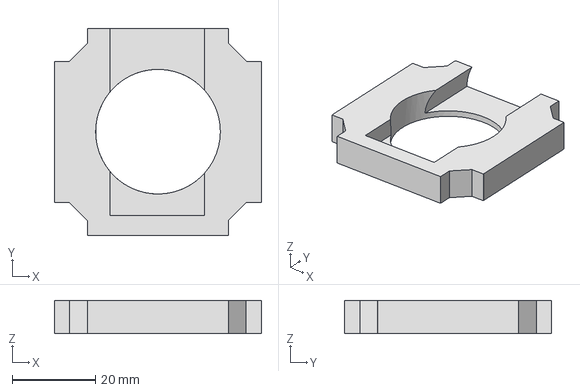
[picture p128: CAD file, 2022-11-30]
STEP/20_Cube_Insert_Lens_Cylindrical_Plexiglas_glassslab_longF_v3.ipt.step
49.8 x 49.8 x 8.00 mm
