openUC2/UC2-STEP/STEP/20_gear.ipt.step

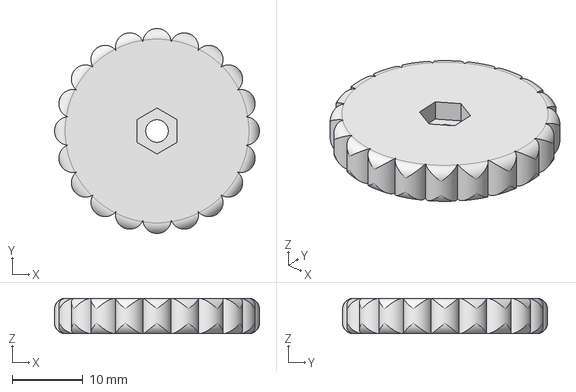
[picture p129: CAD file, 2022-11-30]
STEP/20_gear.ipt.step
29.0 x 29.0 x 5.00 mm
