openUC2/UC2-STEP/STEP/30_Cube_Z_Focus_NEMA8_captive_motorbase_v0.ipt.step

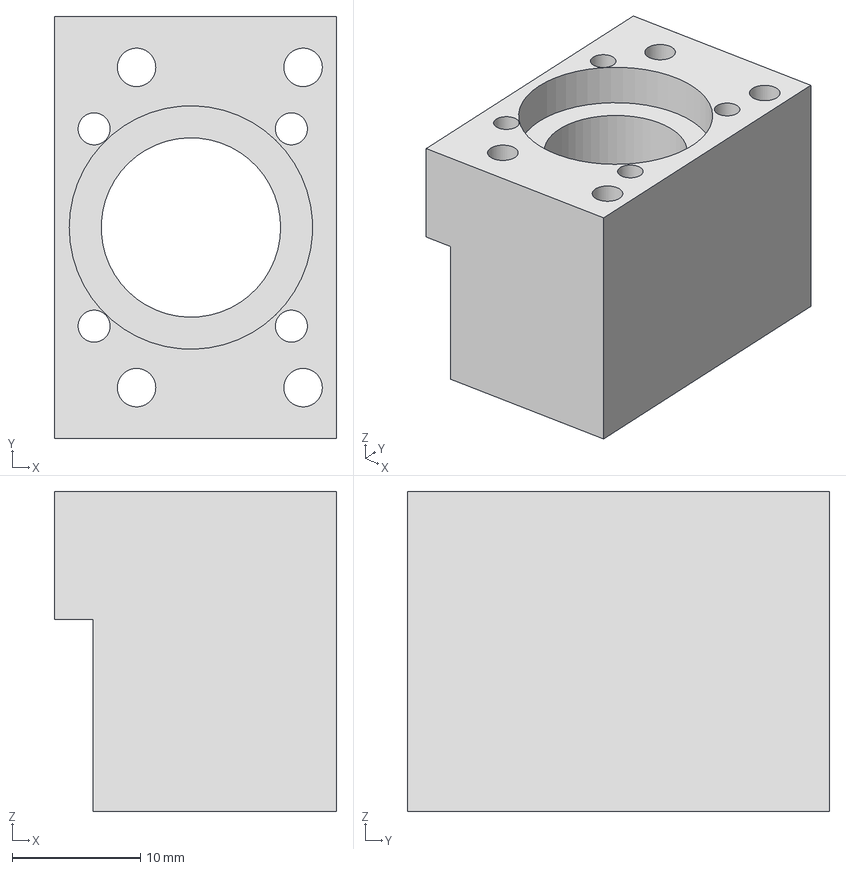
[picture p130: CAD file, 2022-11-30]
STEP/30_Cube_Z_Focus_NEMA8_captive_motorbase_v0.ipt.step
22.0 x 32.9 x 25.0 mm
