openUC2/UC2-STEP/STEP/Bearings.ipt.step

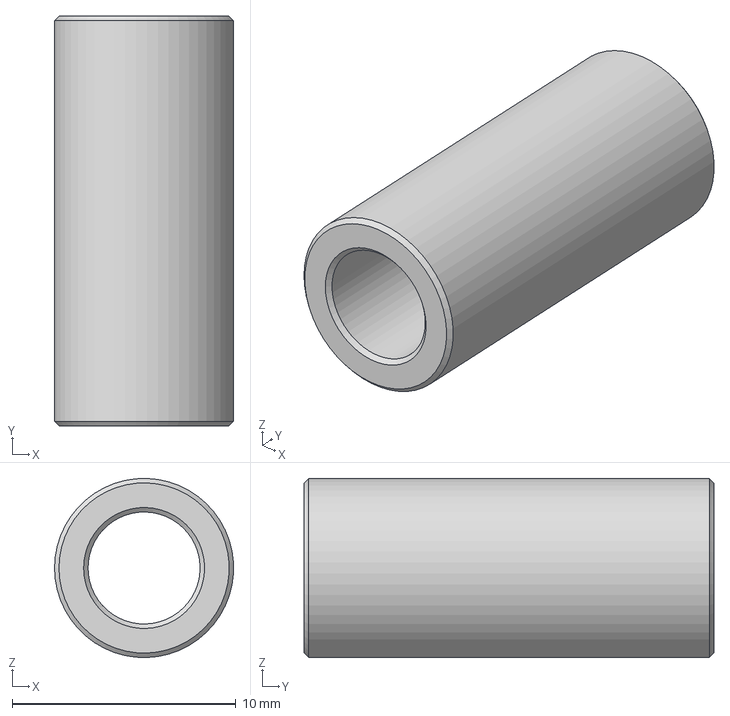
[picture p131: CAD file, 2022-11-30]
STEP/Bearings.ipt.step
7.99 x 18.3 x 8.00 mm
