openUC2/UC2-STEP/STEP/20_Cube_Insert_CirAp_Wheel_UPD.ipt.step

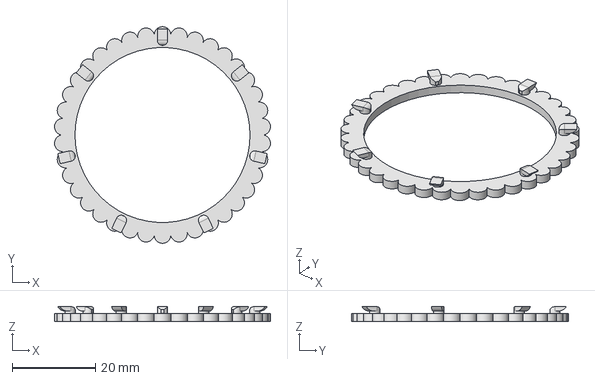
[picture p132: CAD file, 2022-11-30]
STEP/20_Cube_Insert_CirAp_Wheel_UPD.ipt.step
51.8 x 52.0 x 3.50 mm
