openUC2/UC2-STEP/STEP/00_FEP_tube_2mm.ipt.step

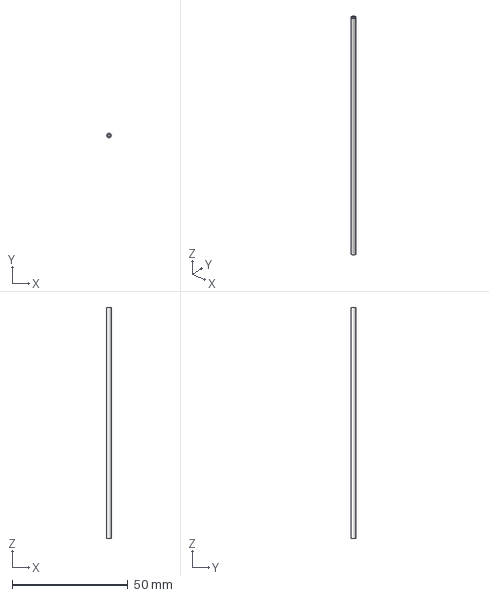
[picture p133: CAD file, 2022-11-30]
STEP/00_FEP_tube_2mm.ipt.step
2.00 x 2.00 x 100.0 mm
