openUC2/UC2-STEP/STEP/20_Cube_Insert_Nema8_Holder_Center_v3.ipt.step

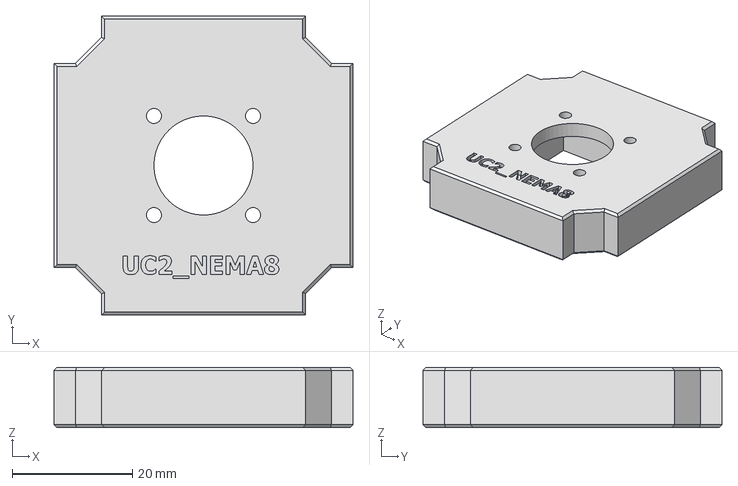
[picture p135: CAD file, 2022-11-30]
STEP/20_Cube_Insert_Nema8_Holder_Center_v3.ipt.step
49.8 x 49.8 x 10.0 mm
