openUC2/UC2-STEP/STEP/20_Cube_Insert_CirAp_Wheel.ipt.step

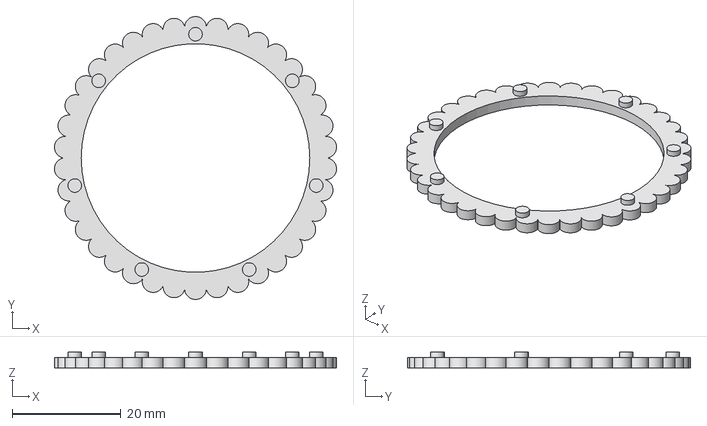
[picture p136: CAD file, 2022-11-30]
STEP/20_Cube_Insert_CirAp_Wheel.ipt.step
51.8 x 52.0 x 2.90 mm
