openUC2/UC2-STEP/STEP/20_Cube_Insert_Lightsheet_RectangularCapillary.ipt.step

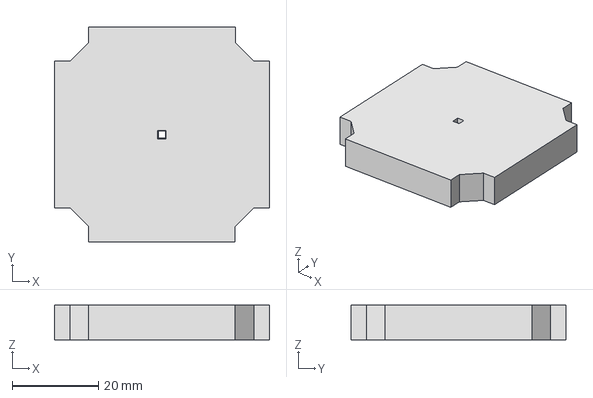
[picture p137: CAD file, 2022-11-30]
STEP/20_Cube_Insert_Lightsheet_RectangularCapillary.ipt.step
49.8 x 49.8 x 8.00 mm
