openUC2/UC2-STEP/(list of files, cad)

Other CAD files:
STEP/50_Assembly_ETL_Mould.ipt.step
STEP/Assembly_Cube_Kinematic_Mirrormount_30x30_45_v3.iam.step
STEP/Assembly_Cube_LED_Luxeon_Saber_Z4_v3.iam.step
STEP/Assembly_Cube_Lens_Cylindrical_v3.iam.step
STEP/Assembly_Cube_empty_1x1_withBase_v3.iam.step
STEP/Assembly_Cube_Mirror_30x30_v3.iam.step
STEP/Assembly_Cube_Template_v3.iam.step
STEP/Assembly_Cube_Cuvette_holder_diy_v3.iam.step
STEP/Assembly_Cube_Beamsplitter_v3.iam.step
STEP/Assembly_ModularElectronics_Mockup_v0.ipt.step
STEP/Assembly_Cube_Lens_holder_-50mm_v3.iam.step
STEP/Assembly_Cube_BaslerCam_ACE2_v3.iam.step
STEP/Assembly_Cube_Sample_holder_v3.iam.step
STEP/00Mousetop.ipt.step
STEP/00_10127C-Step.ipt.step
STEP/00_24wellplate_base_2.ipt.step
STEP/00_28by_coil.ipt.step
STEP/00_30126G3-Step.ipt.step
STEP/00_3W-Led-2 v7.iam.step
STEP/00_3W_LED_Star_pad_v1.iam.step
STEP/00_40_Perestaltic_Pump_NEMA17_Head.iam.step
STEP/00_AC254-030-A-ML-Step.ipt.step
STEP/00_AC254-030-A-Step.ipt.step
STEP/00_AC254-050-A-ML-Step.ipt.step
STEP/00_AC254-075-A-ML-Step.ipt.step
STEP/00_AC254-200-A-ML-Step.ipt.step
STEP/00_Adapter_RMS_M12_CCTV.ipt.step
STEP/00_Aluminiumrail_nutslider_block.ipt.step
STEP/00_Anybeam_Nebra_HAT.ipt.step
STEP/00_Anybeam_Nebra_HAT_RAY.ipt.step
STEP/00_Arducam_USB.ipt.step
STEP/00_Axiovert_Base.ipt.step
STEP/00_Axiovert_Wheel.ipt.step
STEP/00_Axiovert_condenser.ipt.step
STEP/00_Axiovert_focusblock.ipt.step
STEP/00_BallMagnets_5mm.ipt.step
STEP/00_BallMagnets_5mm_single.ipt.step
STEP/00_Ballbearing_3x8mm.ipt.step
STEP/00_Basler_acA1920_25gm.ipt.step
STEP/00_Basler_ace_USB3_C-Mount.ipt.step
STEP/00_Battery_AAA_Attrap.ipt.step
STEP/00_Beam_Stairs_7.5mm.ipt.step
STEP/00_Beampath_Coupling.ipt.step
STEP/00_Beamsplitter.ipt.step
STEP/00_Bearing_US.ipt.step
STEP/00_Berrybase_CCTVLens_100mm.ipt.step
STEP/00_C1515_M-Step.ipt.step
STEP/00_CCTV_Lens_f2.8_f#1.ipt.step
STEP/00_CUBE_openSIM_Beamexpander_Lens_20mm_Edmundoptics.ipt.step
STEP/00_CUBE_openSIM_LA1131-ML-Step.ipt.step
STEP/00_Carriage.ipt.step
STEP/00_Case_Powersupply_Galvo.ipt.step
STEP/00_Case_Powersupply_Galvo_lid.ipt.step
STEP/00_Chroma_Dichroic_25x,3x1.ipt.step
STEP/00_Comar_Dichroic_16x25x0.2.ipt.step
STEP/00_Comar_Filter_25Dia.ipt.step
STEP/00_Comar_Lens_Cylindrical_50mm.ipt.step
STEP/00_Cuvette_1.5ml_10mm.ipt.step
STEP/00_DMLP425-Step.ipt.step
STEP/00_Daheng_IMX174_mer2_u3_user_a1.0.1.ipt.step
STEP/00_E Slide Mount v2.ipt.step
STEP/00_ESP32_Board.ipt.step
STEP/00_Eyepiece_WF20x 23,2mm.ipt.step
STEP/00_F6SSN2P-Step.ipt.step
STEP/00_FEP_Tube_3mm_x_20mm.ipt.step
STEP/00_Fiber_M12_collimator.ipt.step
STEP/00_Fiber_M12_collimator_v3.ipt.step
STEP/00_Fiberprotection.ipt.step
STEP/00_FluidicChip_AlexSwen.ipt.step
STEP/00_FluidicChip_Vittorio.ipt.step
STEP/00_GT2_TimingBelt_flexible.ipt.step
STEP/00_GT2_TimingBelt_flexible_Modular.ipt.step
STEP/00_GT2_TimingBelt_flexible_Modular_Dia_42mm.ipt.step
STEP/00_GT2_TimingBelt_flexible_Modular_Dia_53.2mm.ipt.step
STEP/00_GT2_TimingBelt_flexible_Modular_xytable_large_161tooth.ipt.step
STEP/00_GT2_TimingBelt_flexible_Modular_xytable_large_62tooth.ipt.step
STEP/00_GT2_TimingBelt_flexible_Modular_xytable_large_64tooth.ipt.step
STEP/00_GT2_TimingBelt_flexible_Modular_xytable_large_65tooth.ipt.step
STEP/00_GT2_TimingBelt_flexible_Modular_xytable_large_89tooth.ipt.step
STEP/00_GT2_TimingBelt_flexible_Modular_xytable_small_131tooth.ipt.step
STEP/00_Galvo_Taobao.ipt.step
STEP/00_Gear_Pulley_GT2_nut.ipt.step
STEP/00_Gears_For_GT02_Arduino.ipt.step
STEP/00_Glassslab_Lens_Cylindrical_30mm_Plexiglas.ipt.step
STEP/00_Huawei_P20.ipt.step
STEP/00_IR_Laserdiode.ipt.step
STEP/00_Igus_Drylin_6mm.ipt.step
STEP/00_Jetson_Nano_IMX2019.ipt.step
STEP/00_Joy-IT-B20SHD4353_NEMA8_captive.ipt.step
STEP/00_Joystick_PS2.ipt.step
STEP/00_KES400.iam.step
STEP/00_KES400_Bluray_Lens.ipt.step
STEP/00_KES400_Lens.ipt.step
STEP/00_KES_Bluray_Magnet.ipt.step
STEP/00_KM100-Step.ipt.step
STEP/00_LA1304-Step.ipt.step
STEP/00_LASER_640nm.ipt.step
STEP/00_LC_Duplex_Fiber_Connector.ipt.step
STEP/00_LED-ARRAY.ipt.step
STEP/00_LED-ARRAY_4x4.ipt.step
STEP/00_LED_lens.ipt.step
STEP/00_LED_smd_body.ipt.step
STEP/00_LED_star_base.ipt.step
STEP/00_Laser_532nm_200mw.ipt.step
STEP/00_Laser_match_housing.ipt.step
STEP/00_Laserpointer_450nm_blue.ipt.step
STEP/00_Lasertack_Coolingblock.ipt.step
STEP/00_Lens_Iphone_5s.ipt.step
STEP/00_Lens_d21,5.ipt.step
STEP/00_Lens_f_29_d12.6.ipt.step
STEP/00_Linear_Stage_NEMA11_Mount.ipt.step
STEP/00_Linear_Stepper_90mm.ipt.step
STEP/00_Linear_Stepper_90mm_slide.ipt.step
STEP/00_Luxeon_Saber_z4.ipt.step
STEP/00_MGN12 LINEAR GUIDE RAIL, CONFIGURABLE.ipt.step
STEP/00_MGN12H, LINEAR GUIDE BLOCK.ipt.step
STEP/00_MGN7-H.ipt.step
STEP/00_MGN7.ipt.step
STEP/00_MGN7_34mm.ipt.step
STEP/00_Metaltube_OD3.17mm.ipt.step
STEP/00_Michelson_Interferometer_beampath.ipt.step
STEP/00_MicroSwitch.ipt.step
STEP/00_Microlinearmotor.ipt.step
STEP/00_Microlinearmotor_aliexpress_5mm.ipt.step
STEP/00_Microscope_Objective.ipt.step
STEP/00_Microscope_Objective_Lens10x.ipt.step
STEP/00_Microscope_Slide.ipt.step
STEP/00_Mirror_30x30.ipt.step
STEP/00_Motorcoupling_5mm_M3.ipt.step
STEP/00_Motorcoupling_5mm_M3_clamped.ipt.step
STEP/00_NEMA11_spindle.ipt.step
STEP/00_NEMA17.ipt.step
STEP/00_NEMA23_holder.ipt.step
STEP/00_NEMA8.iam.step
STEP/00_NEMA_17.ipt.step
STEP/00_OT-2 Reference Model Basic.ipt.step
STEP/00_OT-2 Reference Model Detailed.ipt.step
STEP/00_OV_lens.ipt.step
STEP/00_Olympus_40_1.3oil.ipt.step
STEP/00_P1-305A-FC-1-Step.ipt.step
STEP/00_P125_M-Step.ipt.step
STEP/00_PB4_M-Step.ipt.step
STEP/00_PF10-03-P01-Step.ipt.step
STEP/00_PF175B-Step.ipt.step
STEP/00_PM20-ST-Step.ipt.step
STEP/00_PipetteTip200ul-1.ipt.step
STEP/00_Pulley_28byj-48.ipt.step
STEP/00_Pulley_28byj-48_large.ipt.step
STEP/00_RGB_Laser_Laserlands.ipt.step
STEP/00_RMS_Laser_alignmenttool.ipt.step
STEP/00_RMS_TAP_Adapter.ipt.step
STEP/00_RMS_Thread.ipt.step
STEP/00_RS_Pro_Micrometer_small.ipt.step
STEP/00_RasPi_Camera.ipt.step
STEP/00_Ringmagnet_10x5x3mm.ipt.step
STEP/00_Ringmagnet_10x6mm.ipt.step
STEP/00_Rod_6mm_150mm.ipt.step
STEP/00_SM05FCA-Step.ipt.step
STEP/00_SM05LC-Step.ipt.step
STEP/00_SM1FC-Step.ipt.step
STEP/00_SMLM_chamber.ipt.step
STEP/00_STORMModule.ipt.step
STEP/00_Servomotor_SG90.ipt.step
STEP/00_Slider_Mask_Coherent.ipt.step
STEP/00_Slider_Mask_DPC.ipt.step
STEP/00_Slider_Mask_Darkfield.ipt.step
STEP/00_Slider_Polarizationfilterr.ipt.step
STEP/00_Sony_EMount.ipt.step
STEP/00_Spacer_13mm.ipt.step
STEP/00_Stepper_Motor_28BYJ-48.0013.ipt.step
STEP/00_Stepper_Motor_28BYJ-48.ipt.step
STEP/00_Syringe 20 ml_threaded.ipt.step
STEP/00_Syringe_10ml.ipt.step
STEP/00_T-nut_M3_x1.ipt.step
STEP/00_THORLABS_AC254-050-A-ML-Step.ipt.step
STEP/00_TI_DLP_2000EVM.ipt.step
STEP/00_TI_DLP_2000_Chip.ipt.step
STEP/00_TLV-TE2000-Step.ipt.step
STEP/00_Thorlabs_Cage_CP33_M.ipt.step
STEP/00_Thorlabs_Lens_Holder_CP02_M.ipt.step
STEP/00_Thorlabs_PF10-03-P01-Step.ipt.step
STEP/00_Thorlabs_Rod_200mm.ipt.step
STEP/00_Thorlabs_Rod_6mm.ipt.step
STEP/00_Threaded_Insert_M3_8mm.ipt.step
STEP/00_V-Slot_20x.ipt.step
STEP/00_VSlot_20mm.ipt.step
STEP/00_VSlot_20mm_200mm.ipt.step
STEP/00_VSlot_20mm_250mm.ipt.step
STEP/00_VSlot_90degree_bracket.ipt.step
STEP/00_Vslot_bearing.ipt.step
STEP/00_X-axis_MX25-SC.iam.step
STEP/00_XYTable_large_gear.ipt.step
STEP/00_XYTable_medium_gear.ipt.step
STEP/00_XYTable_pulley.ipt.step
STEP/00_XYTable_pulley_M3.ipt.step
STEP/00_XY_stage-CHUO_SEIKI_LD-647-R1-Bottom.ipt.step
STEP/00_XY_stage-CHUO_SEIKI_LD-647-R1-Middle.ipt.step
STEP/00_XY_stage-CHUO_SEIKI_LD-647-R1-Top.ipt.step
STEP/00_XY_stage-CHUO_SEIKI_LD-647-R1.iam.step
STEP/00_arduino_uno.ipt.step
STEP/00_ballbearing_8mm.ipt.step
STEP/00_bearing_ball_2mm.ipt.step
STEP/00_cellSTORM_chip_01_old.ipt.step
STEP/00_cellSTORM_v5_chiptray_old_0.ipt.step
STEP/00_cellSTORM_v5_chiptray_slidesize.ipt.step
STEP/00_chip_01_old.ipt.step
STEP/00_chipnano_waveguide_slidsize.ipt.step
STEP/00_coupler_5_3_nema_screw.ipt.step
STEP/00_coupler_5_3_nema_screw_nut.ipt.step
STEP/00_coverglass_10mm.ipt.step
STEP/00_coverglass_12mm.ipt.step
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
